dramco-iwast/sensors/README.md

# sensors
Design of the sensors that can be plugged onto the IWAST motherboard.
