dramco-iwast/sensors/casing/verticalspacing.PNG

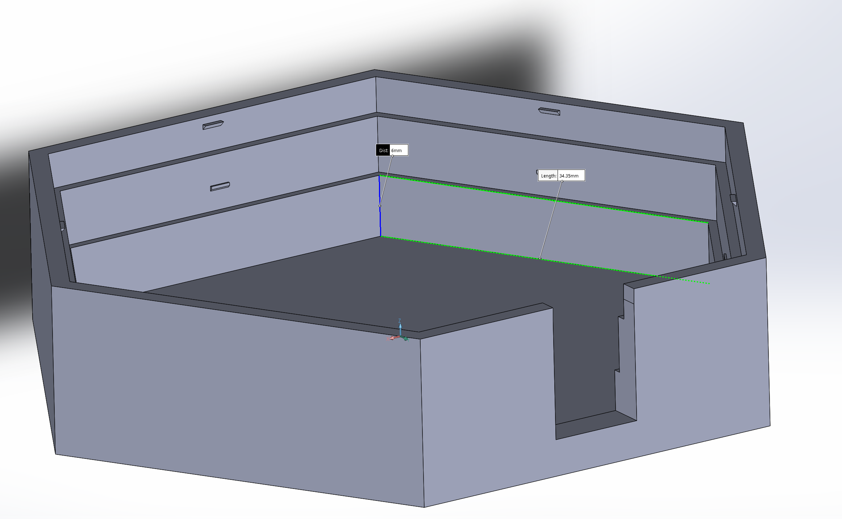
casing/verticalspacing.PNG
