dramco-iwast/sensors/hardware/Sound_Level/SoundModulev2.4/kicadproject/noun_Microphone_1957310.png

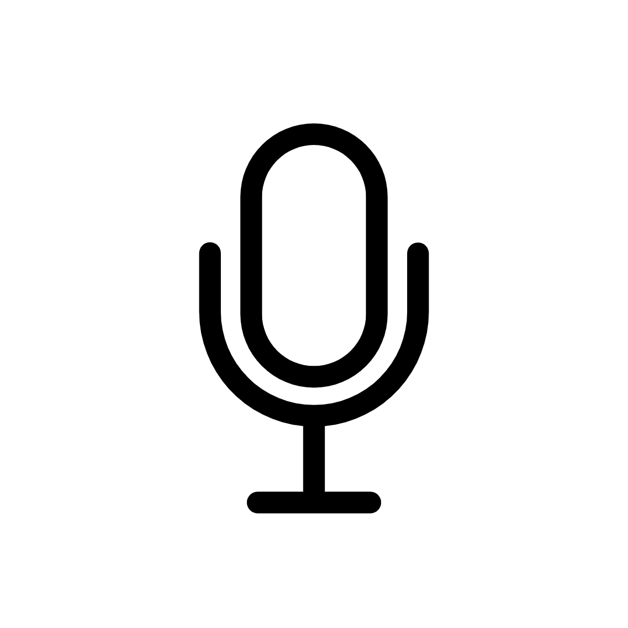
hardware/Sound_Level/SoundModulev2.4/kicadproject/noun_Microphone_1957310.png
