dramco-iwast/sensors/hardware/Buttons/Buttons_v2/bom/Buttons_v1.xlsx

Id | Designator | Behuizing | Hoeveelheid | Orientatie | Manufacturer Part Number (MPN) | Ordercode Farnell | Ordercode Mouser | Type
1 | REF** | PinHeader_1x06_P2.54mm_Vertical_SMD | 1 | PinHeader_1x06_P2.54mm_Vertical_SMD
2 | G*** | Dramco7500 | 1 | LOGO
3 | G*** | KULeuven4000 | 1 | LOGO
4 | S4,S3,S2,S1 | 30062114 | 4 | 30062114 | 30062114 |  | 979-3006.2114 | Not specified
5 | J2 | ConnectorHorizontalPcb | 1 | MASTER | M20-9980345 | 1022230 |  | Per stuk
6 | C5,C4,C3,C2,C1 | C_0805_2012Metric_Pad1.15x1.40mm_HandSolder | 5 | 100n | C0805C104M4RACAUTO | 3510057 |  | Reel
7 | R10,R9,R7,R5,R3 | R_0805_2012Metric_Pad1.15x1.40mm_HandSolder | 5 | 1k | MCWR08X1001FTL | 2446904 |  | Reel
8 | LED1 | LED_0805_2012Metric_Pad1.15x1.40mm_HandSolder | 1 | SML-D12Y1WT86 | KP-2012QBC-D | 2217974 |  | Tape en reel, afgesneden
9 | R8,R6,R4,R2 | R_0805_2012Metric_Pad1.15x1.40mm_HandSolder | 4 | 100k | MC01W08051100K | 2129276 |  | Reel
10 | J1 | PinHeader_1x06_P2.54mm_Vertical | 1 | PICKit3
11 | IC1 | SOP65P780X200-20N | 1 | PIC16F18446-I_SS | PIC16F18446-I/SS | 3631504 |  | Not specified
12 | R1 | R_0805_2012Metric_Pad1.15x1.40mm_HandSolder | 1 | 10k | MC01W0805110K | 2129195 |  | Reel
