dramco-iwast/sensors/hardware/Power/Power_v6/bom/Power_module_v4.xlsx

Id | Designator | Behuizing | Hoeveelheid | Orientatie | Manufacturer Part Number (MPN) | Ordercode Farnell | Ordercode Mouser | Type
1 | G*** | logoKuleuven2 | 1 | LOGO
2 | G*** | logoDramco2 | 1 | LOGO
3 | Z1 | D_SOD-523 | 1 | BZT52C4V7T-7
4 | R4,R5 | R_0805_2012Metric_Pad1.15x1.40mm_HandSolder | 2 | 1.5k | MCWR08X1501FTL | 2447592 |  | Tape en reel, afgesneden
5 | J1 | PinHeader_1x02_P2.54mm_Vertical | 1 | Conn_01x02
6 | CSTOR1,CIN1 | C_0805_2012Metric_Pad1.18x1.45mm_HandSolder | 2 | 4.7 uF | C0805C475K8PACTU | 2409055 |  | Tape en reel, afgesneden
7 | CREF1,CBYP1 | C_0805_2012Metric_Pad1.18x1.45mm_HandSolder | 2 | 10 nF | 885012207011 | 2534050 |  | Tape en reel, afgesneden
8 | COUT1,CIN2 | C_0805_2012Metric_Pad1.18x1.45mm_HandSolder | 2 | 100n | C0805C104M4RACAUTO | 3510057 |  | Reel
9 | C14 | C_0805_2012Metric_Pad1.18x1.45mm_HandSolder | 1 | 100 nF | C0805C104M4RACAUTO | 3510057 |  | Reel
10 | C13 | C_0805_2012Metric_Pad1.18x1.45mm_HandSolder | 1 | 10 uF | C0805C106Z8VACTU | 2725611 |  | Reel
11 | C12,C10,C9,C8,C7,C4,C1 | C_0805_2012Metric_Pad1.18x1.45mm_HandSolder | 9 | 1 uF | C0805C105K4RACTU | 2392346 |  | Reel
12 | COUT2, COUT3 | C_0805_2012Metric_Pad1.18x1.45mm_HandSolder | 2 | 22 uF | C0805C226M8PACTU | 2773239 |  | Tape en reel, afgesneden
13 | CSTOR2,CBATT1 | C_0805_2012Metric_Pad1.18x1.45mm_HandSolder | 2 | DNP
14 | U1 | BQ24040 | 1 | BQ24040 | BQ24040DSQR | 3008693RL |  | Tape en reel, afgesneden
15 | D3,D4 | LED_0805_2012Metric_Pad1.15x1.40mm_HandSolder | 2 | LED | KP-2012QBC-D | 2217974 |  | Tape en reel, afgesneden
15 | D1 | LED_0805_2012Metric_Pad1.15x1.40mm_HandSolder | 1 | LED | KP-2012CGCK | 2290331 |  | Tape en reel, afgesneden
15 | D2 | LED_0805_2012Metric_Pad1.15x1.40mm_HandSolder | 1 | LED | KP-2012SURC | 8529930 |  | Tape en reel, afgesneden
16 | J3 | USB_Micro | 1 | USB_B_Micro | 10118194-0001LF | 2668482 |  | Tape en reel, afgesneden
17 | J4 | PinHeader_1x02_P2.54mm_Vertical | 1 | Conn_01x02_battery
18 | J5,J6 | PinHeader_1x06_P2.54mm_Vertical | 2 | Conn_01x06_programmer
19 | JP1,JP2 | SolderJumper-2_P1.3mm_Open_RoundedPad1.0x1.5mm | 2 | SolderJumper_2_Open
20 | L1 | Inductor_744031220_22uH | 1 | 22 uH | 744031220 | 1890602 |  | Tape en reel, afgesneden
21 | L2 | Inductor_744029100_10uH | 1 | 10 uH | 744029100 | 1635828 |  | Tape en reel, afgesneden
22 | R1,R6,R9,R13,R12 | R_0805_2012Metric_Pad1.15x1.40mm_HandSolder | 5 | 10k | MC01W0805110K | 2129195 |  | Reel
23 | R2 | R_0805_2012Metric_Pad1.15x1.40mm_HandSolder | 1 | 1k | MCWR08X1001FTL | 2446904 |  | Reel
24 | R3 | R_0805_2012Metric_Pad1.15x1.40mm_HandSolder | 1 | 2k | MCWR08X2001FTL | 2447622 |  | Tape en reel, afgesneden
25 | R7 | R_0805_2012Metric_Pad1.15x1.40mm_HandSolder | 1 | 27k | MCWR08X2702FTL | 2447620 |  | Tape en reel, afgesneden
26 | R10 | R_0805_2012Metric_Pad1.15x1.40mm_HandSolder | 1 | 8.2k | MCWR08X8201FTL | 2447732 |  | Tape en reel, afgesneden
27 | R14,R15 | R_0805_2012Metric_Pad1.15x1.40mm_HandSolder | 2 | 470 | MCWR08X4700FTL | 2447662 |  | Tape en reel, afgesneden
28 | ROK3 | R_0805_2012Metric_Pad1.15x1.40mm_HandSolder | 1 | 1,27M | CRCW08051M27FKEA. | 2139131 |  | Tape en reel, afgesneden
29 | ROK2 | R_0805_2012Metric_Pad1.15x1.40mm_HandSolder | 1 | 6,81M | CRCW08056M81FKEA. | 2139222 |  | Tape en reel, afgesneden
30 | ROK1 | R_0805_2012Metric_Pad1.15x1.40mm_HandSolder | 1 | 5,1M | CRCW08055M10FKEA. | 2139205 |  | Tape en reel, afgesneden
31 | ROUT2 | R_0805_2012Metric_Pad1.15x1.40mm_HandSolder | 1 | 8.25 M | CRCW08058M25FKEA. | 2139232 |  | Tape en reel, afgesneden
32 | ROUT1 | R_0805_2012Metric_Pad1.15x1.40mm_HandSolder | 1 | 4.75 M | CRCW08054M75FKEA. | 2139202 |  | Tape en reel, afgesneden
33 | ROV2 | R_0805_2012Metric_Pad1.15x1.40mm_HandSolder | 1 | 7,15 M | CRCW08057M15FKEA. | 2139225 |  | Tape en reel, afgesneden
34 | ROV1 | R_0805_2012Metric_Pad1.15x1.40mm_HandSolder | 1 | 5.49M | CRCW08055M49FKEA. | 2139209 |  | Tape en reel, afgesneden
35 | S3,S1 | SOT-23-6_Handsoldering | 2 | TPS22860 | TPS22860DBVR | 3008896RL |  | Tape en reel, afgesneden
36 | U2 | QFN-20-1EP_3.5x3.5mm_P0.5mm_EP2x2mm | 1 | BQ25570 | BQ25570RGRR | 3123350RL |  | Tape en reel, afgesneden
37 | U3 | SOT-23-5_HandSoldering | 1 | TPS705
38 | U4 | PIC16F18446SSOP20PIN | 1 | PIC16F18446 | PIC16F18446-I/SS | 3631504 |  | Not specified
39 | J2 | ConnectorHorizontalPcb | 1 | Conn_02x03_motherboardconn | M20-9980345 | 1022230 |  | Per stuk
40 | COUT4 | CP_Radial_D6.3mm_P2.50mm | 1 | 470 uF
41 | R8 | R_LDR_5.1x4.3mm_P3.4mm_Vertical | 1 | LDR03 | NSL 19M51 | 3168335 |  | Per stuk
 | C2, C3 | R_0805_2012Metric_Pad1.15x1.40mm_HandSolder |  | DNP
