dramco-iwast/sensors/hardware/Sound_Level/SoundModulev2.4/bom/SoundModulev2_2.xlsx

Id | Designator | Behuizing | Hoeveelheid | Orientatie | Manufacturer Part Number (MPN) | Ordercode Farnell | Ordercode Mouser | Type
1 | G*** | logoDramco2 | 1 | LOGO
2 | G*** | logoKuleuven2 | 1 | LOGO
3 | J6,J4 | PinHeader_1x01_P2.54mm_Vertical | 2 | Conn_01x01
4 | R18 | R_0805_2012Metric_Pad1.15x1.40mm_HandSolder | 1 | 500k | MCWR08X4993FTL | 2447667 |  | Tape en reel, afgesneden
5 | IC1 | SOP50P310X90-8N | 1 | TS5A2066DCUR | TS5A2066DCUR | 3118281RL |  | Tape en reel, afgesneden
6 | R17,R3 | R_0805_2012Metric_Pad1.15x1.40mm_HandSolder | 2 | 9k | CRCW08059K09FKEA. | 2138974 |  | Tape en reel, afgesneden
7 | R2,R1 | R_0805_2012Metric_Pad1.15x1.40mm_HandSolder | 2 | 36k | CRCW080536K0FKEA. | 2138997 |  | Tape en reel, afgesneden
8 | C13,C1,C2,C5,C6,C11 | C_0805_2012Metric_Pad1.15x1.40mm_HandSolder | 6 | 100 nF | C0805C104M4RACAUTO | 3510057 |  | Reel
9 | J5 | ConnectorHorizontalPcb | 1 | Conn_02x03_Top_Bottom | M20-9980345 | 1022230 |  | Per stuk
10 | C3,C7,C12 | C_0805_2012Metric_Pad1.15x1.40mm_HandSolder | 3 | 47n | 885012207015 | 2812382RL |  | Tape en reel, afgesneden
11 | C9,C10 | C_0805_2012Metric_Pad1.15x1.40mm_HandSolder | 2 | 2.2 nF | 885012207009 | 2812377RL |  | Tape en reel, afgesneden
12 | D1 | LED_0805_2012Metric_Pad1.15x1.40mm_HandSolder | 1 | LED | KP-2012QBC-D | 2217974 |  | Tape en reel, afgesneden
13 | J1,J3 | PinHeader_1x06_P2.54mm_Vertical | 2 | ProgramPic
14 | J7 | PinHeader_1x01_P2.54mm_Vertical | 1 | VanalogTestPin
15 | MIC | VESPER_VM1010 | 1 | VesperVM1010 | VM1010 |  | 208-VM1010 | Reel / afgesneden
16 | R4,R12,R13 | R_0805_2012Metric_Pad1.15x1.40mm_HandSolder | 3 | 10k | MC01W0805110K | 2129195 |  | Reel
17 | R6 | R_0805_2012Metric_Pad1.15x1.40mm_HandSolder | 1 | 470 | MCWR08X4700FTL | 2447662 |  | Tape en reel, afgesneden
18 | R5,R11,R16 | R_0805_2012Metric_Pad1.15x1.40mm_HandSolder | 3 | 120k | MCWR08X1203FTL | 2447560 |  | Tape en reel, afgesneden
19 | R7 | R_0805_2012Metric_Pad1.15x1.40mm_HandSolder | 1 | 18k | MCWR08X1802FTL | 2447584 |  | Tape en reel, afgesneden
20 | R8,R9 | R_0805_2012Metric_Pad1.15x1.40mm_HandSolder | 2 | 100k | MC01W08051100K | 2129276 |  | Reel
21 | R10 | R_0805_2012Metric_Pad1.15x1.40mm_HandSolder | 1 | 560k | MCWR08X5603FTL | 2447685 |  | Tape en reel, afgesneden
22 | R14 | R_0805_2012Metric_Pad1.15x1.40mm_HandSolder | 1 | 2.7k | MCWR08X2701FTL | 2447627 |  | Tape en reel, afgesneden
23 | R15 | R_0805_2012Metric_Pad1.15x1.40mm_HandSolder | 1 | 1k | MCWR08X1001FTL | 2446904 |  | Reel
24 | U1 | PIC16F18446SSOP20PIN | 1 | PIC16F18446 | PIC16F18446-I/SS | 3631504 |  | Not specified
25 | U2,U3,U4 | TLV341 SOT-23-6 | 3 | TLV341A | TLV341AIDBVR |  | 595-TLV341AIDBVR | Reel / afgesneden
26 | C4,C8 | C_0805_2012Metric_Pad1.15x1.40mm_HandSolder | 2 | 10 uF | C0805C106Z8VACTU | 2725611 |  | Reel
