dramco-iwast/sensors/casing/CaseModule8.SLDPRT

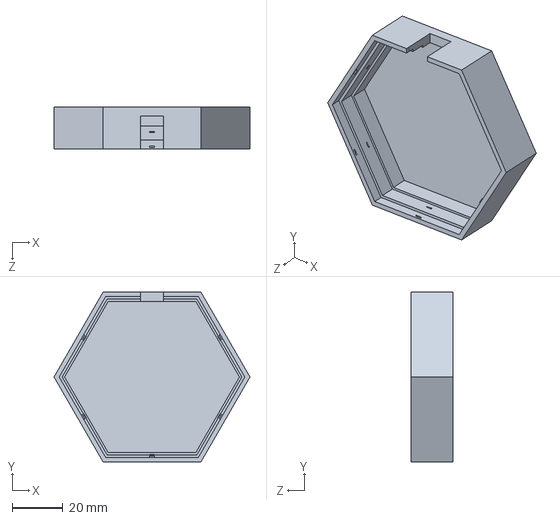
[picture p4: CAD file, 2020-03-09]
casing/CaseModule8.SLDPRT
77.0 x 66.7 x 16.6 mm
