dramco-iwast/sensors/hardware/Power/Power_v6/kicadproject/reverse_mounted_led.STEP

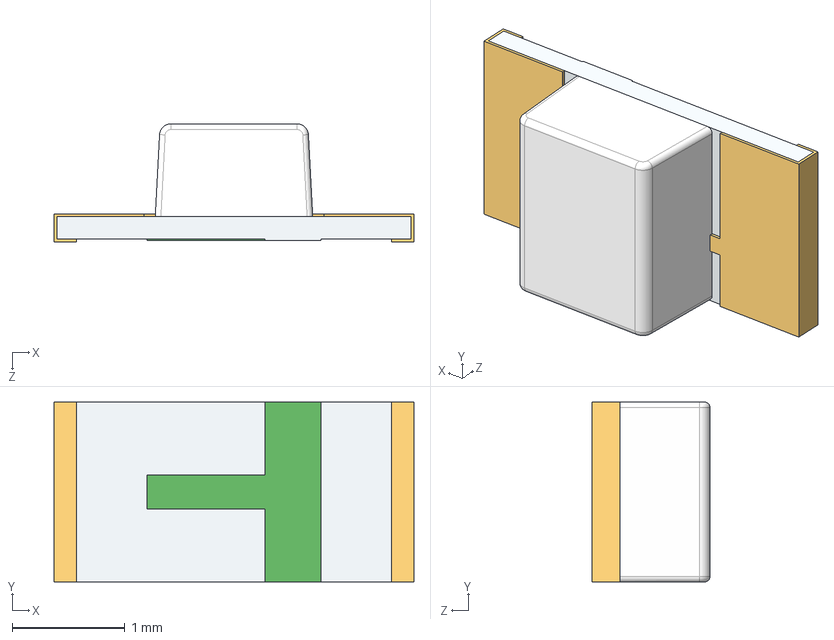
[picture p5: CAD file, 2021-10-26]
hardware/Power/Power_v6/kicadproject/reverse_mounted_led.STEP
3.20 x 1.60 x 1.05 mm
KPTR-3216CGCK
KPTR-3216CGCK-e2
KPTR-3216CGCK-g
KPTR-3216CGCK-e
