dramco-iwast/sensors/hardware/Power/Power_v6/kicadproject/VEML7700-TT/VEML7700-TT.step

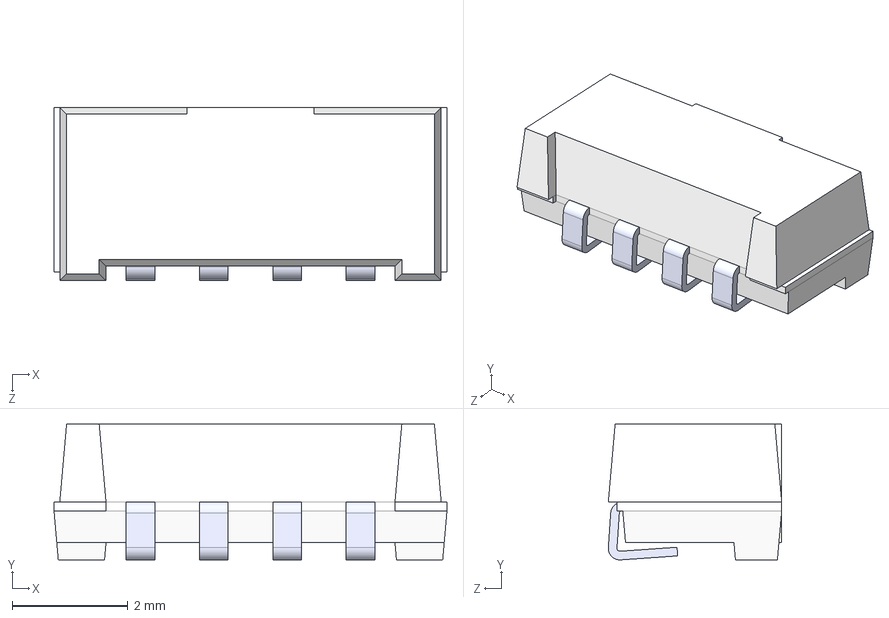
[picture p6: CAD file, 2021-05-31]
hardware/Power/Power_v6/kicadproject/VEML7700-TT/VEML7700-TT.step
6.80 x 2.35 x 3.00 mm
