dramco-iwast/sensors/hardware/Sound_Level/SoundModulev2.4/kicadproject/SoundModulev2.step

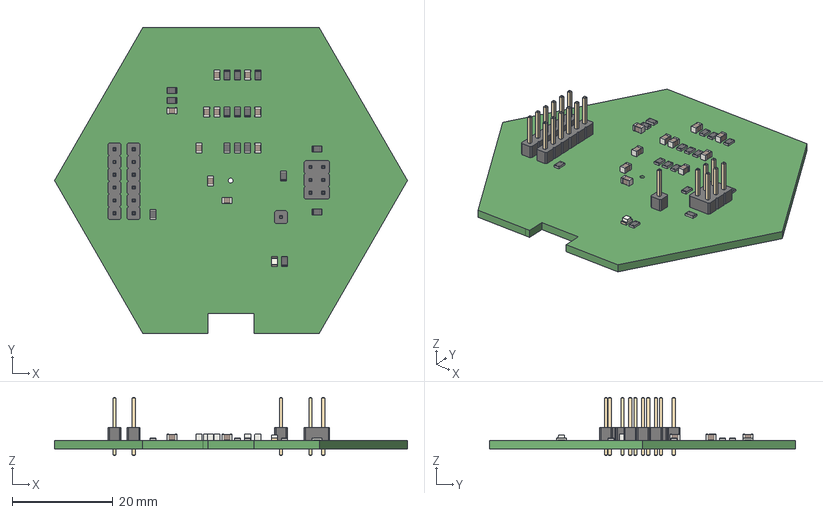
[picture p7: CAD file, 2020-10-28]
hardware/Sound_Level/SoundModulev2.4/kicadproject/SoundModulev2.step
70.0 x 60.6 x 11.5 mm
