dramco-iwast/sensors/hardware/Power/Power_v6/kicadproject/USB3090-30-A--3DModel-STEP-56544.STEP

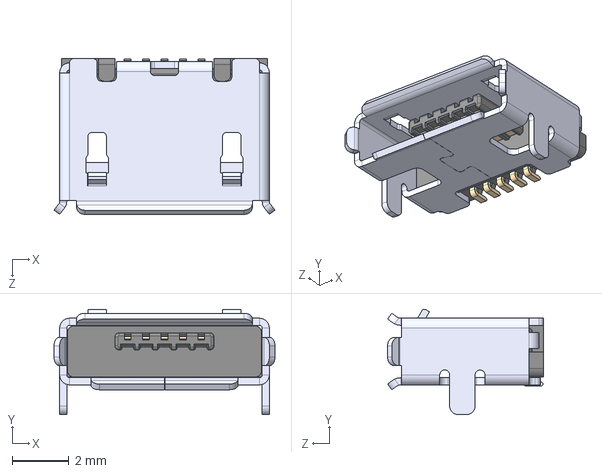
[picture p8: CAD file, 2021-10-26]
hardware/Power/Power_v6/kicadproject/USB3090-30-A--3DModel-STEP-56544.STEP
7.80 x 3.71 x 5.50 mm
