dramco-iwast/sensors/hardware/Power/Power_v6/kicadproject/PIC_3d.STEP

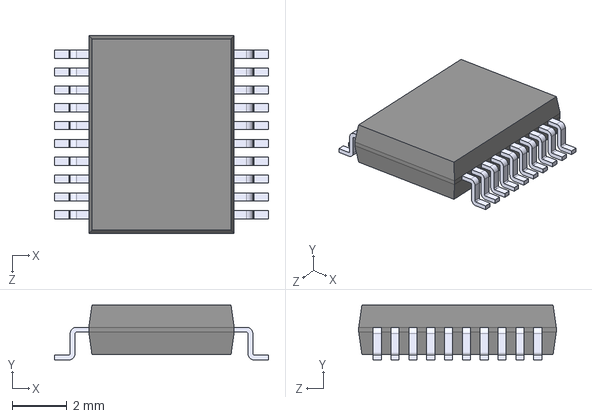
[picture p9: CAD file, 2021-10-26]
hardware/Power/Power_v6/kicadproject/PIC_3d.STEP
7.80 x 2.00 x 7.20 mm
