dramco-iwast/sensors/hardware/Buttons/Buttons_v2/kicadproject/610106249121/610106249121.step

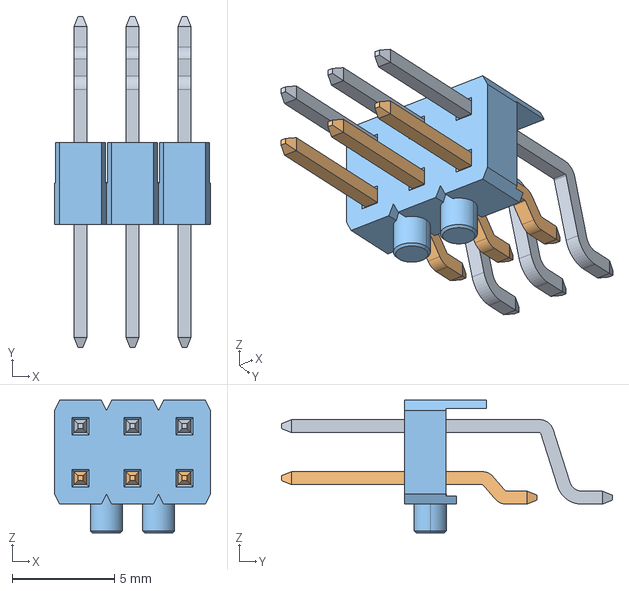
[picture p10: CAD file, 2021-10-26]
hardware/Buttons/Buttons_v2/kicadproject/610106249121/610106249121.step
7.62 x 16.2 x 6.48 mm
