dramco-iwast/sensors/(list of files, cad)

Other CAD files:
casing/CaseModule8.STL
hardware/Sound_Level/SoundModulev2.4/kicadproject/SoundModulev2.SLDASM
