dramco-iwast/sensors/hardware/Air_Quality/air_quality_v3/schematics/back.pdf

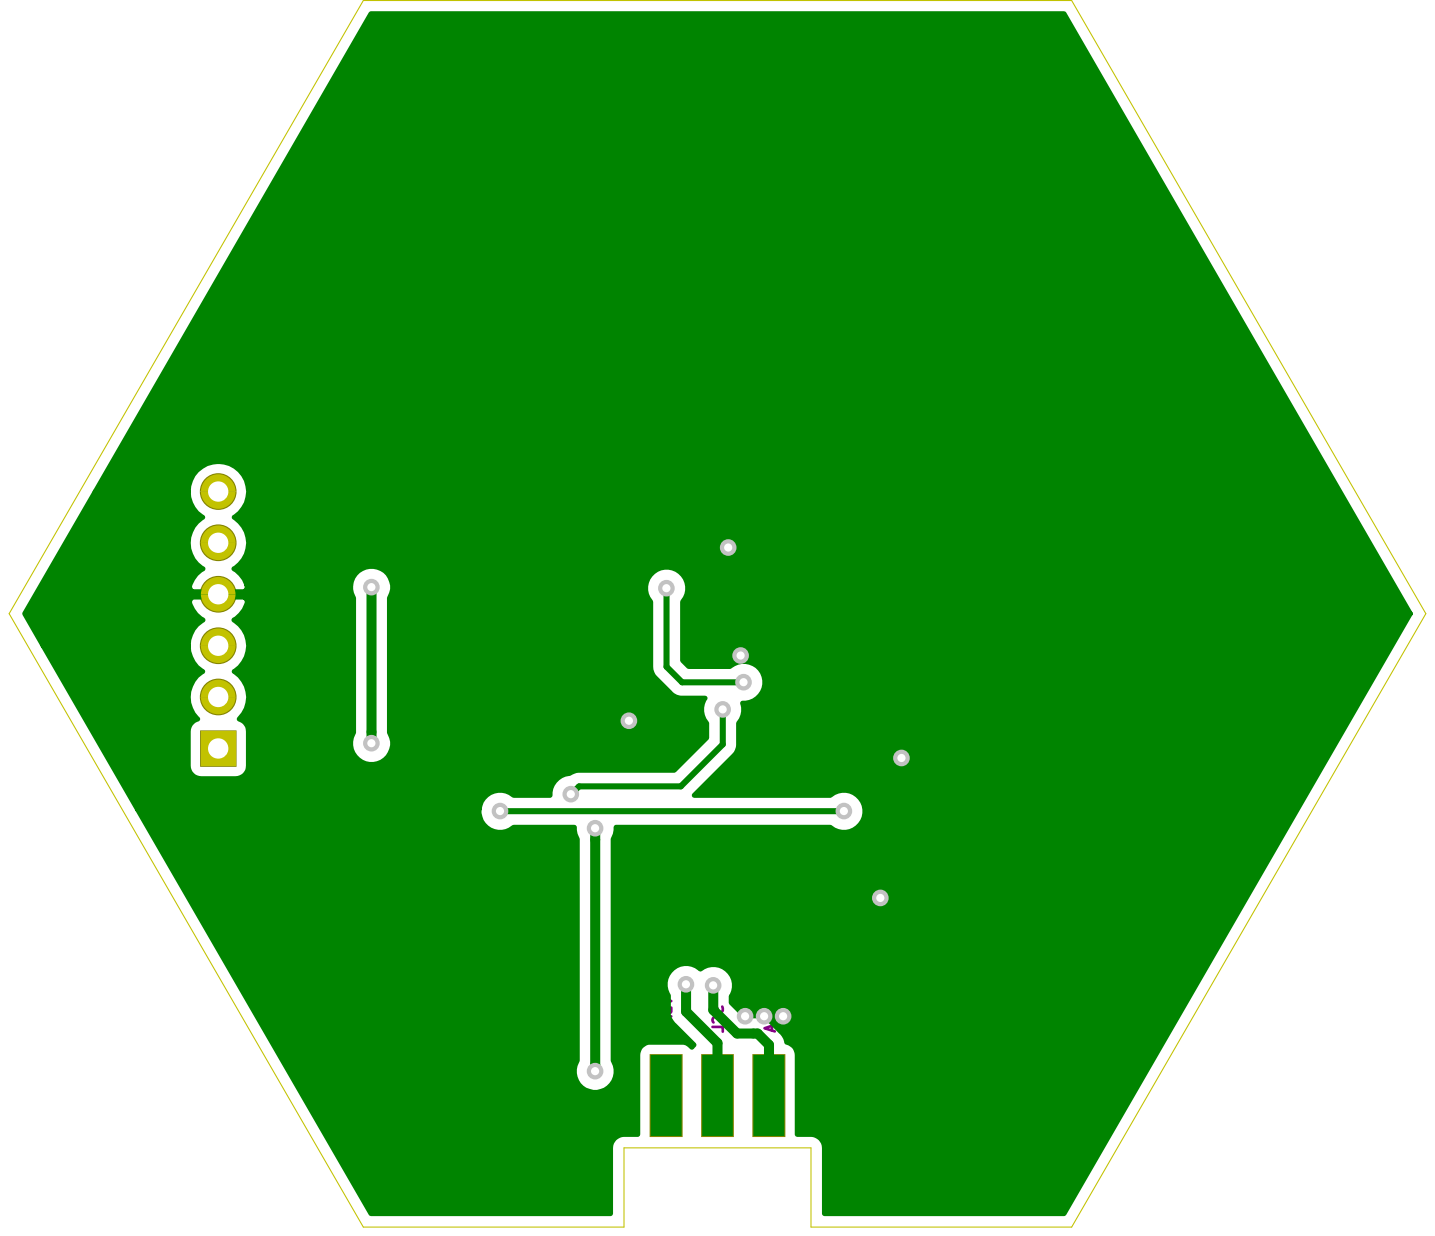
[picture p11: page 1]
