dramco-iwast/sensors/hardware/Air_Quality/air_quality_v3/schematics/front.pdf

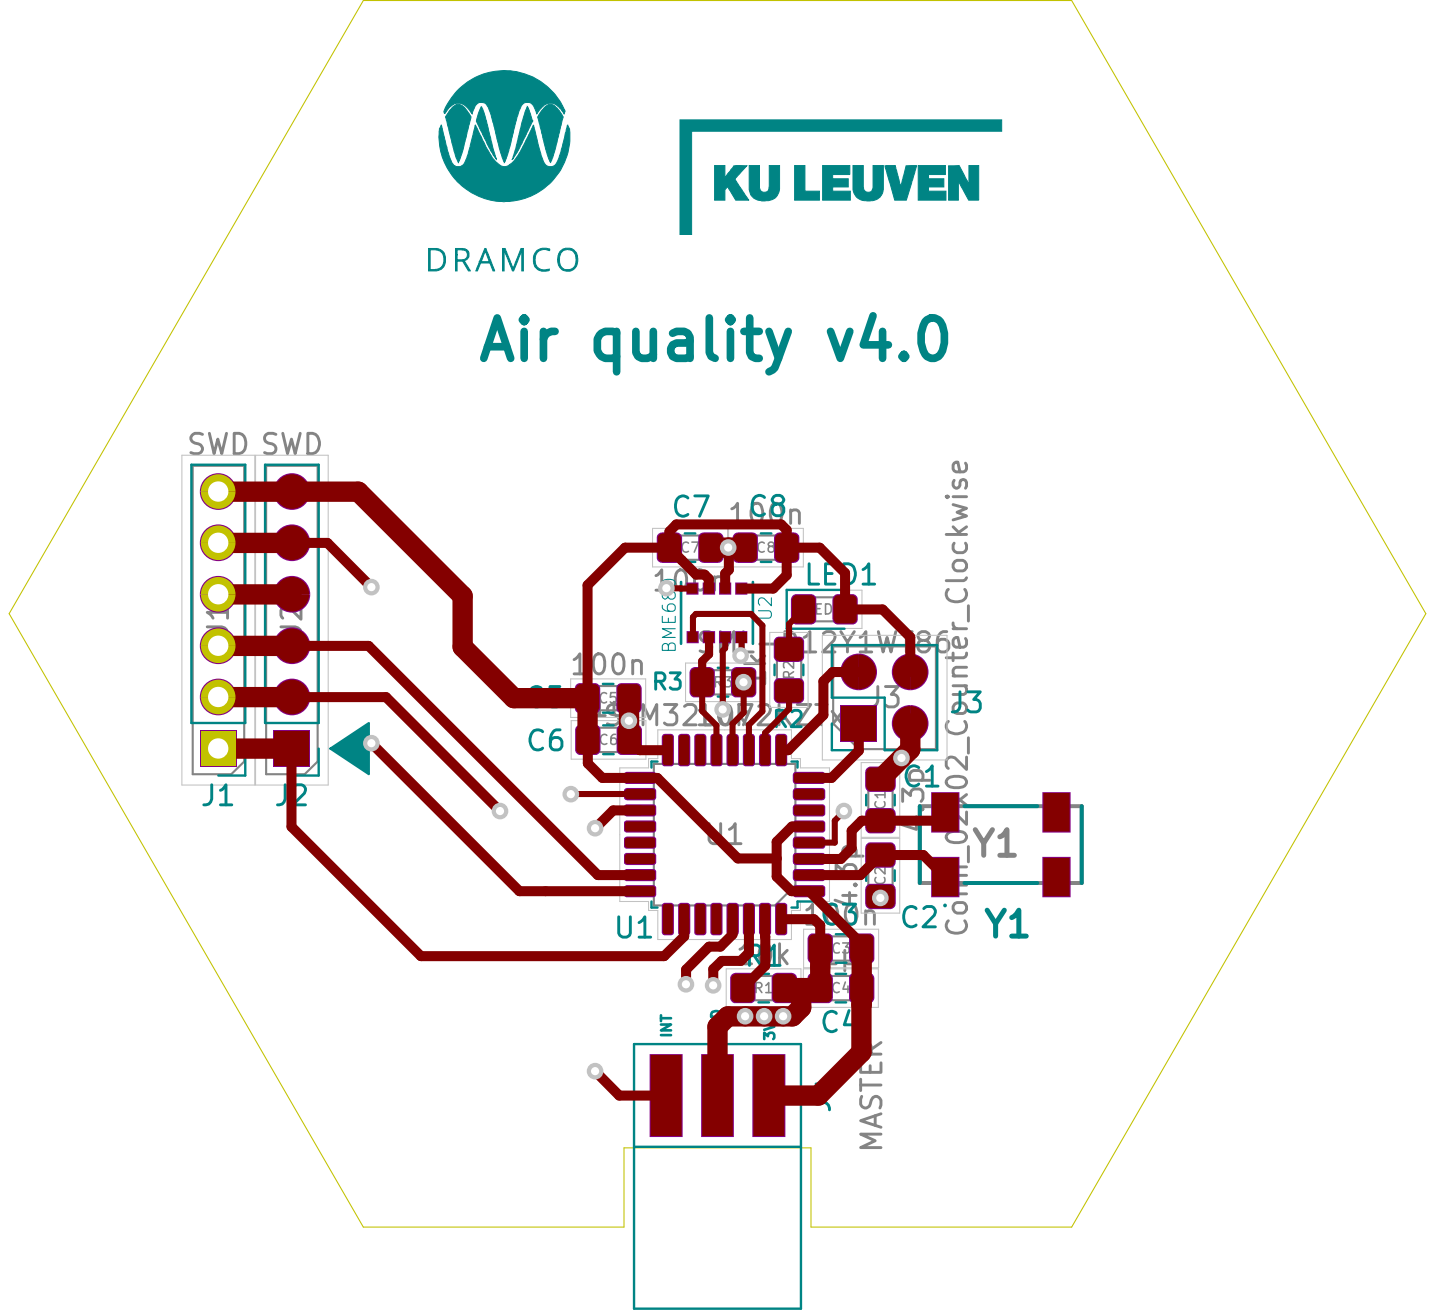
[picture p12: page 1]
