dramco-iwast/sensors/hardware/Air_Quality/air_quality_v3/schematics/schematics.pdf

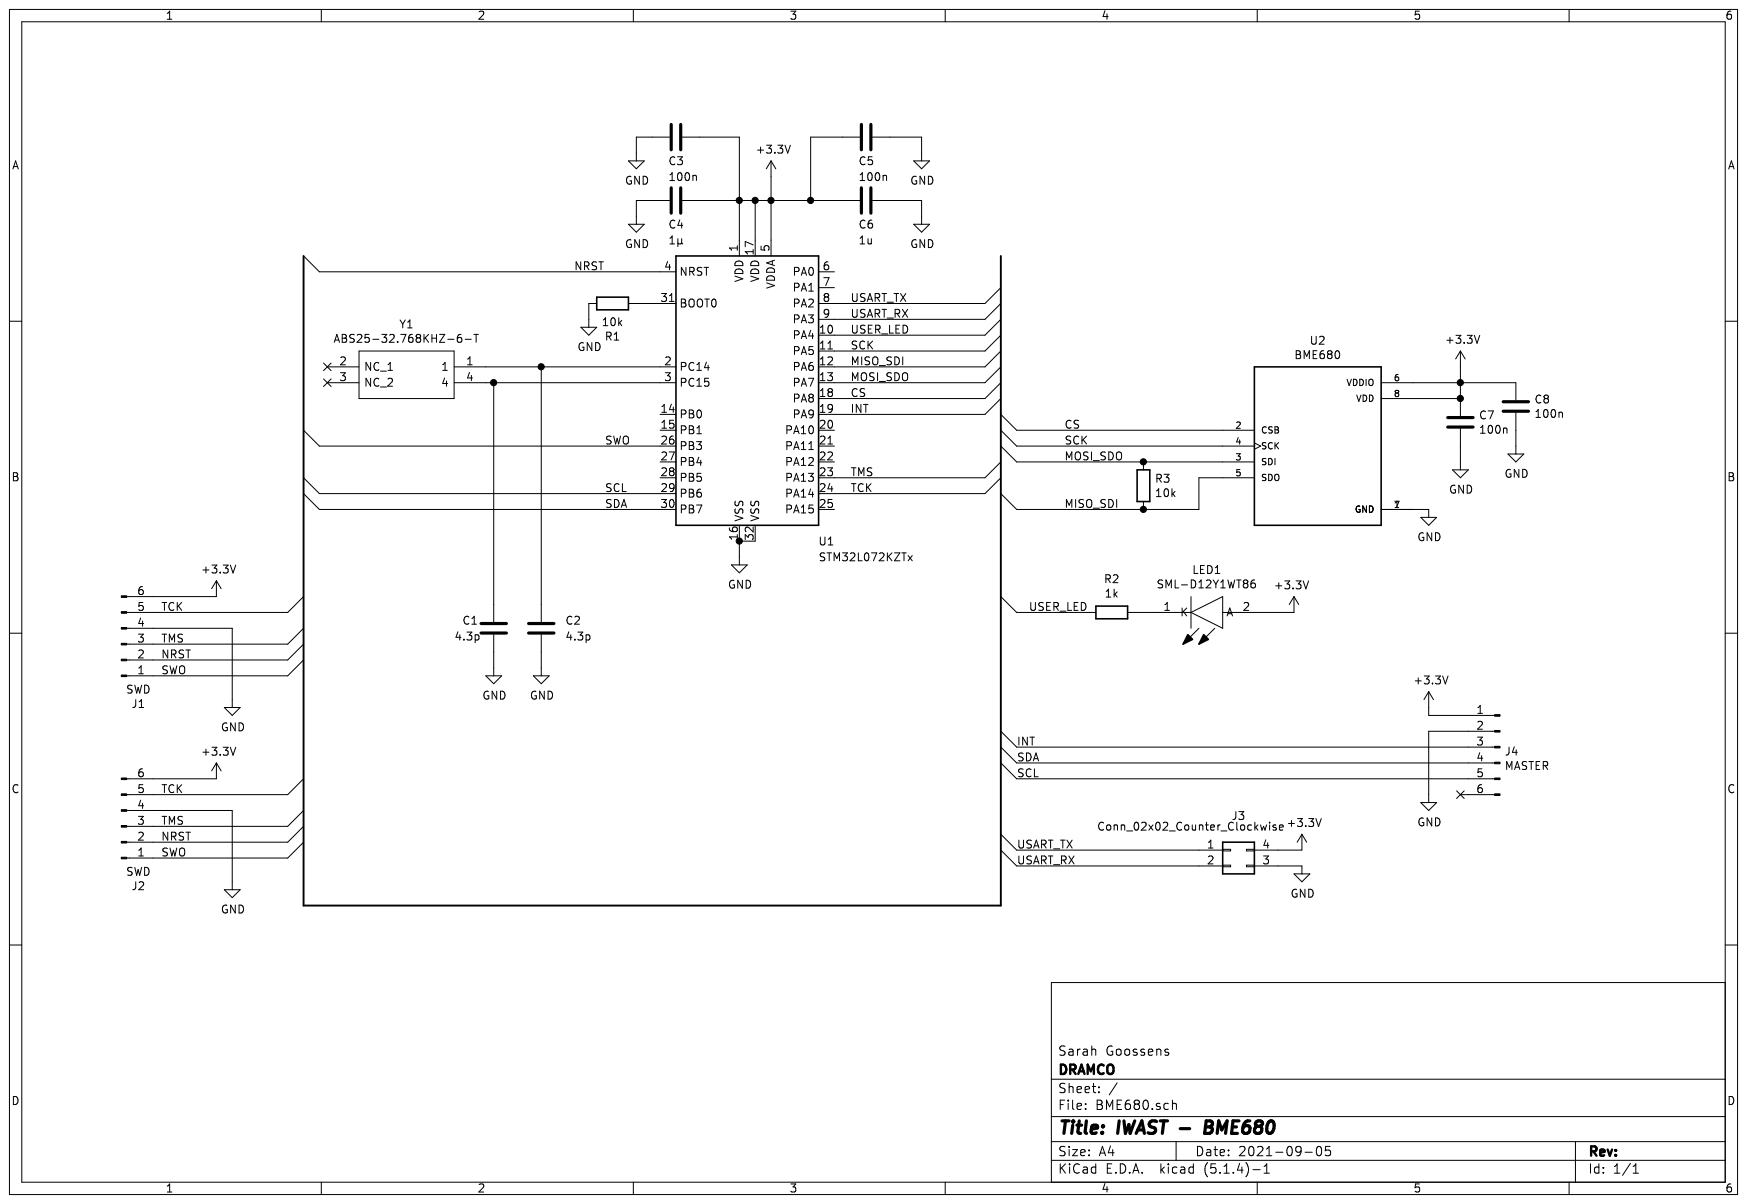
[picture p13: page 1]
