dramco-iwast/sensors/hardware/Power/Power_v6/schematic/power_module_v4_back.pdf

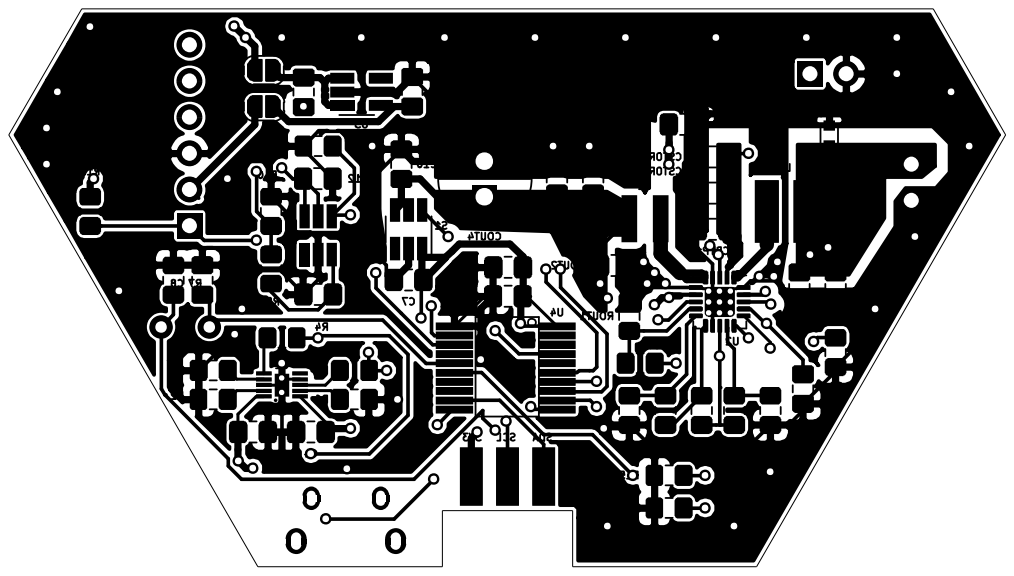
[picture p14: page 1]
