dramco-iwast/sensors/hardware/Power/Power_v6/schematic/power_module_v4_front.pdf

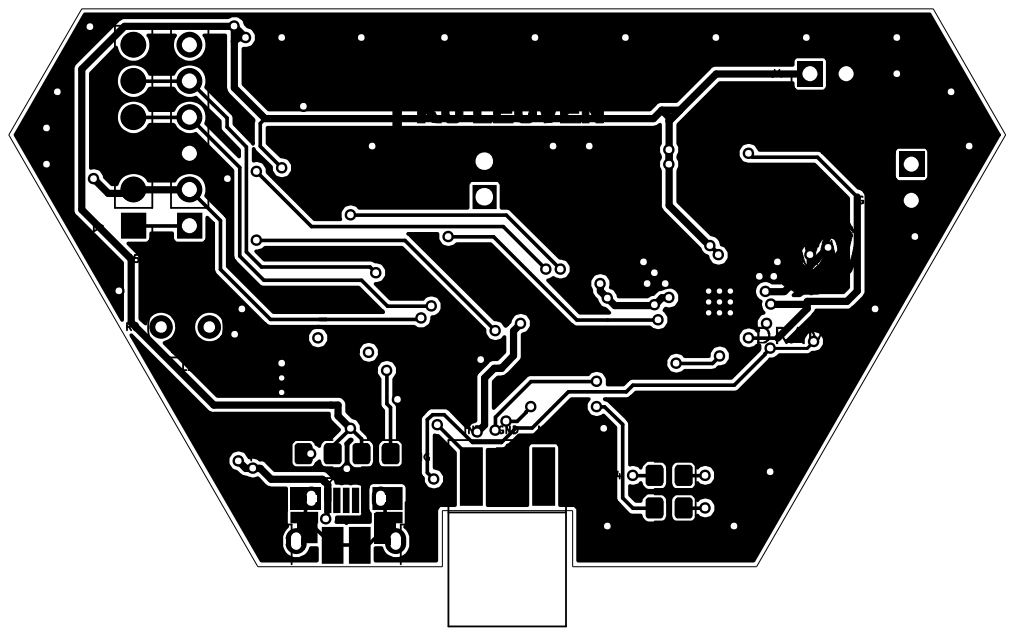
[picture p15: page 1]
