dramco-iwast/sensors/hardware/Power/Power_v6/schematic/power_module_v4_schematic.pdf

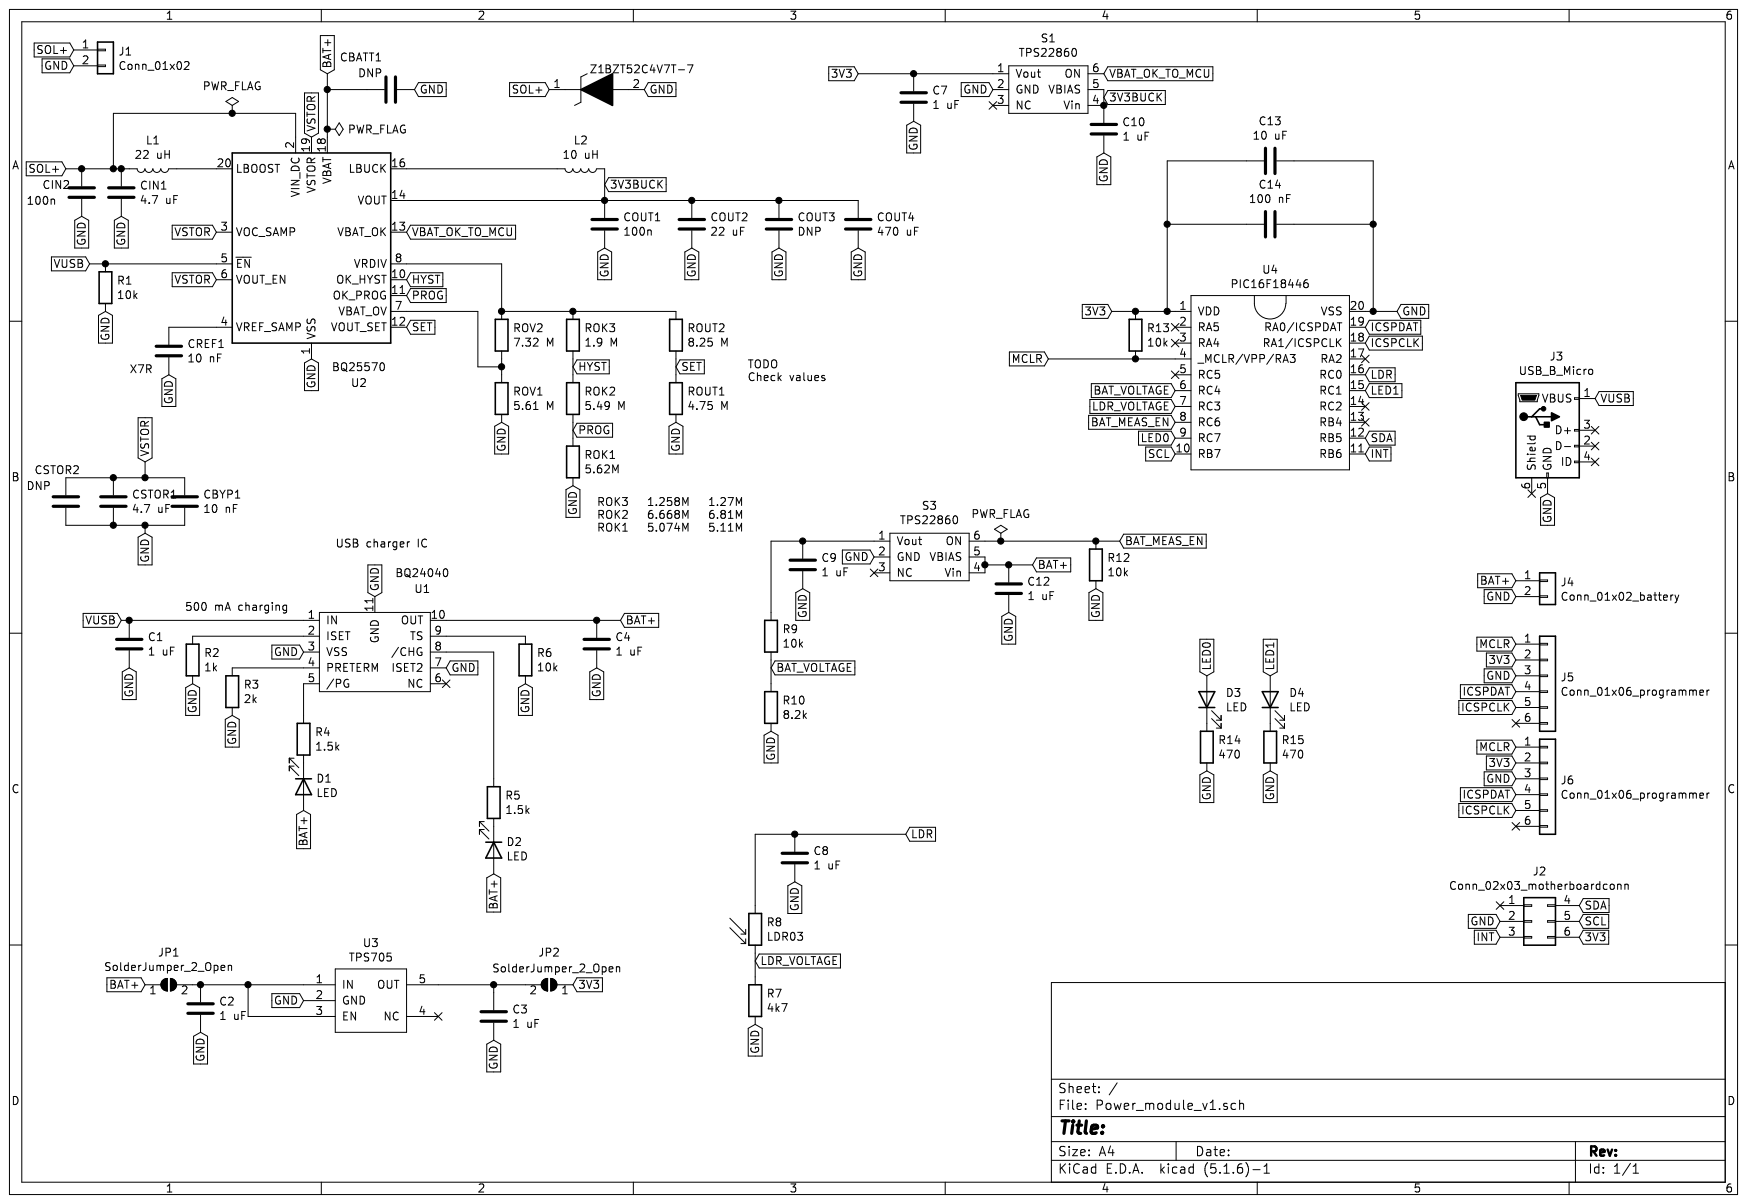
[picture p16: page 1]
