dramco-iwast/sensors/hardware/Sound_Level/SoundModulev2.4/schematics/sound_module_v2.1_back.pdf

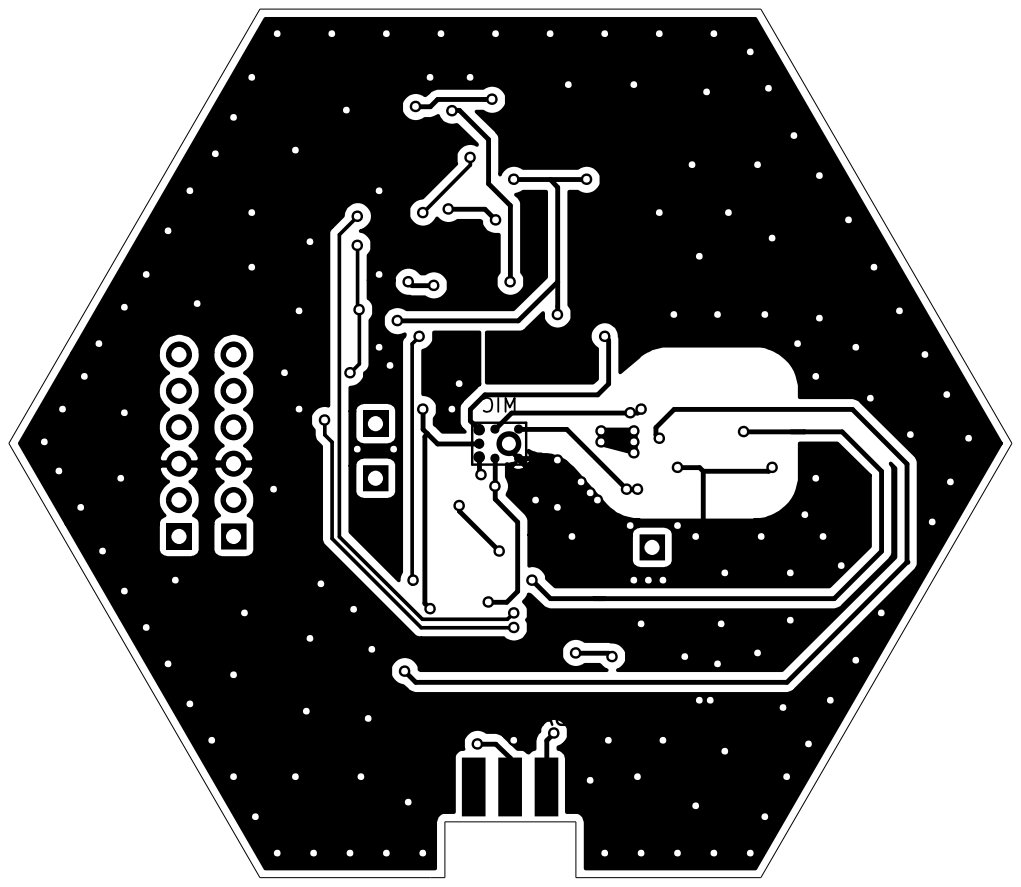
[picture p17: page 1]
