dramco-iwast/sensors/hardware/Sound_Level/SoundModulev2.4/schematics/sound_module_v2.1_front.pdf

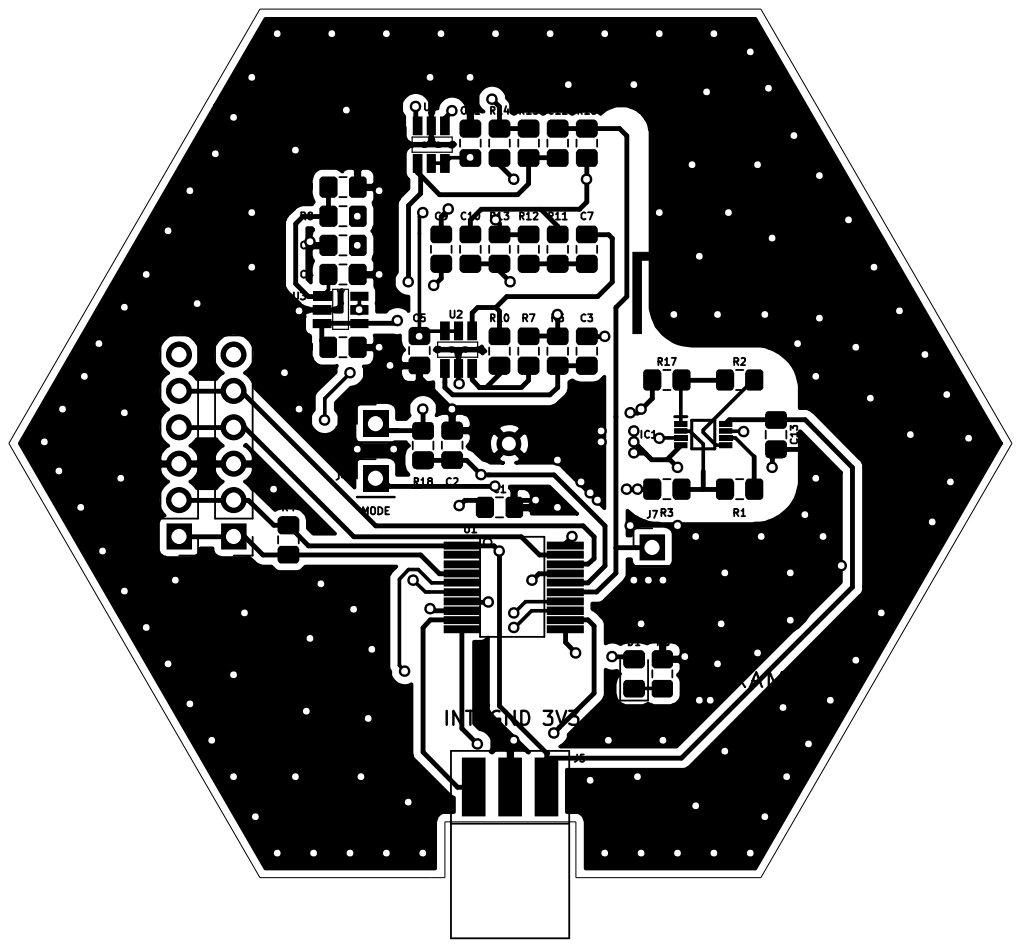
[picture p18: page 1]
