dramco-iwast/sensors/hardware/Sound_Level/SoundModulev2.4/schematics/sound_module_v2.1_schematic.pdf

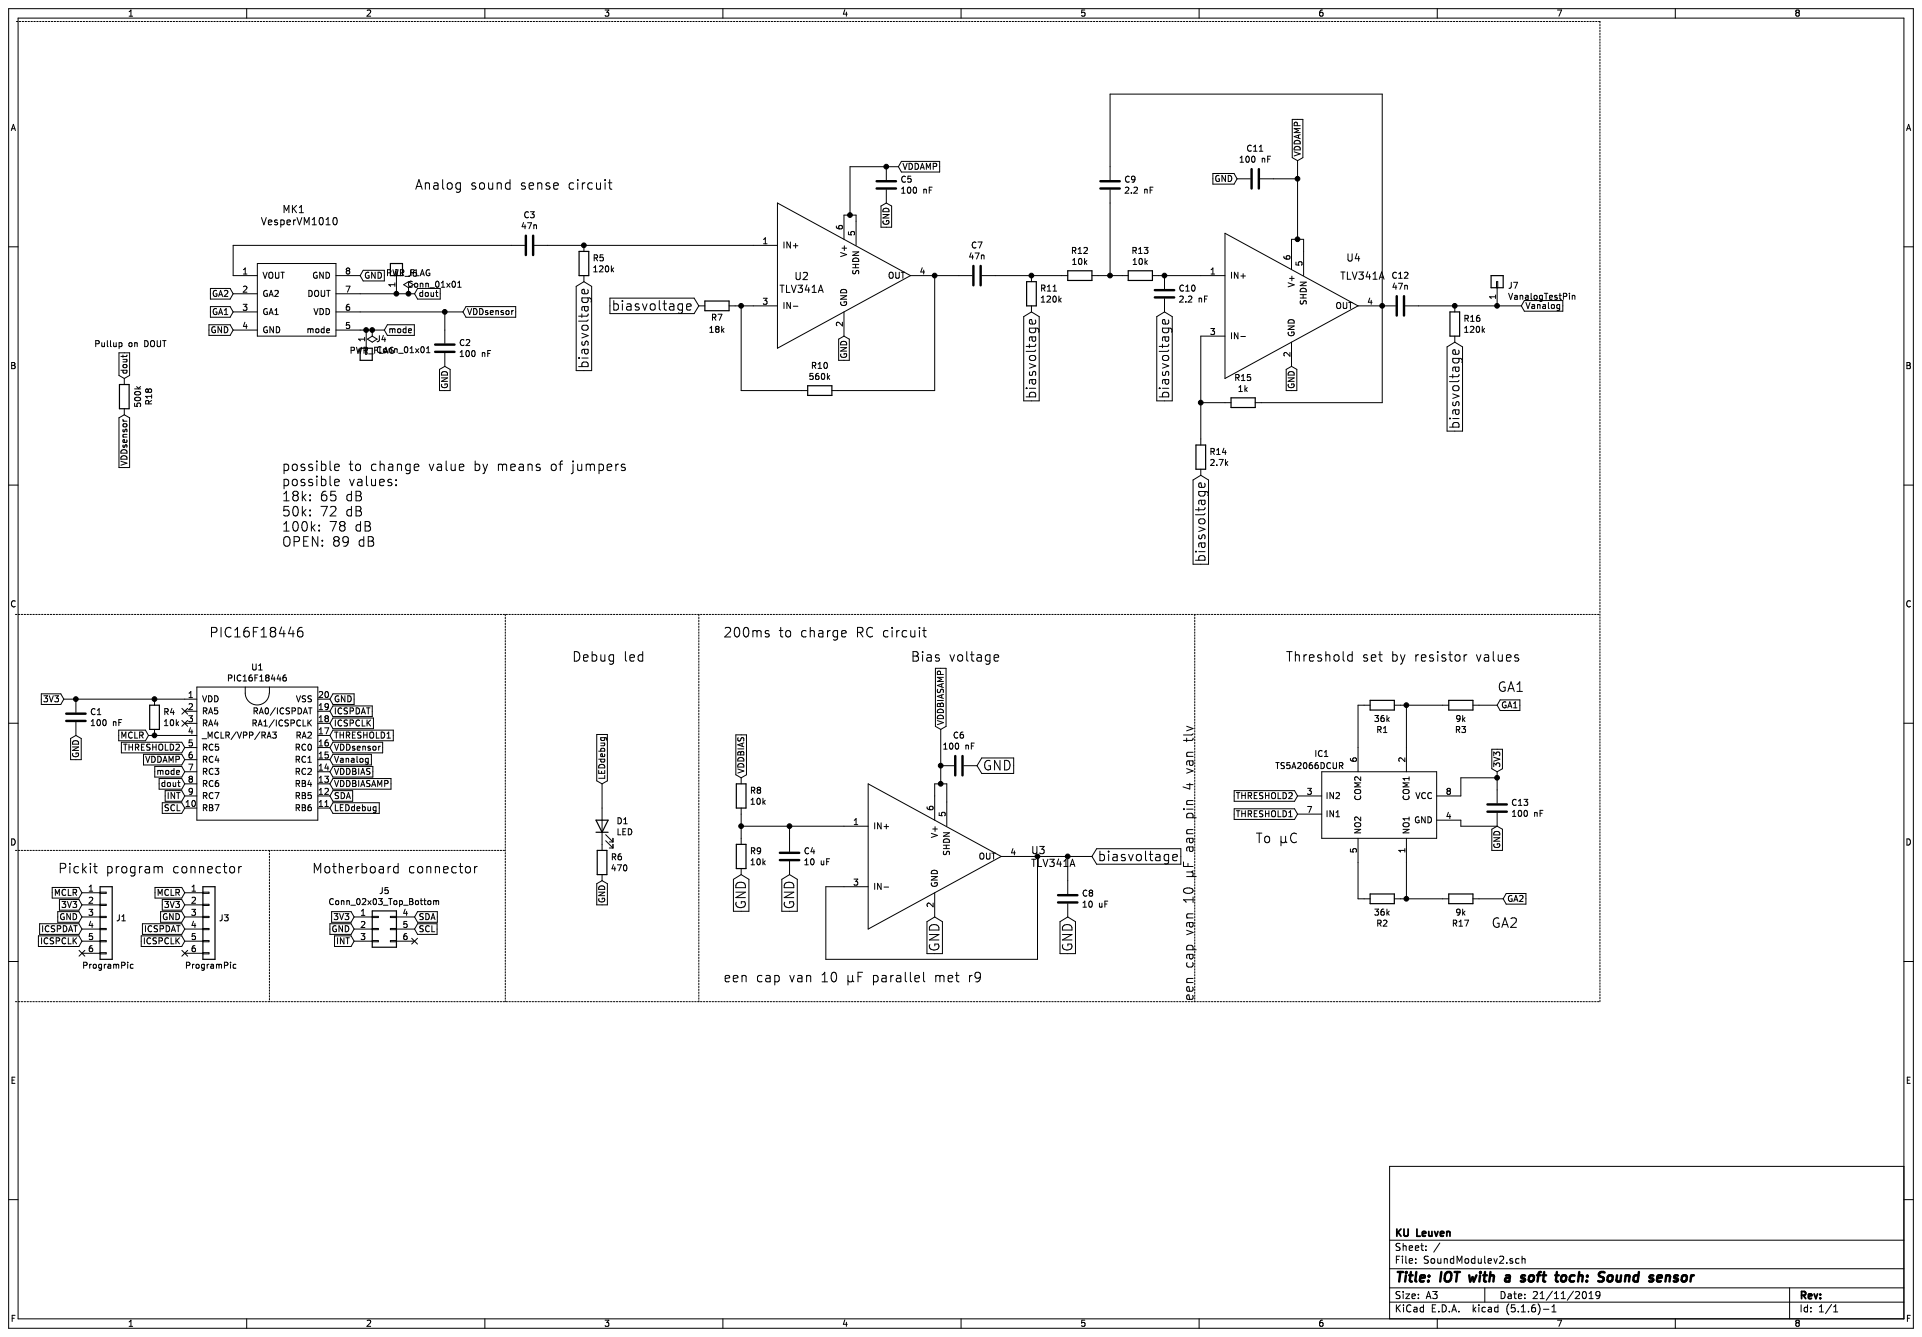
[picture p19: page 1]
