dramco-iwast/sensors/hardware/Sound_Level/SoundModulev1/schematics/sound_module_v1_back.pdf

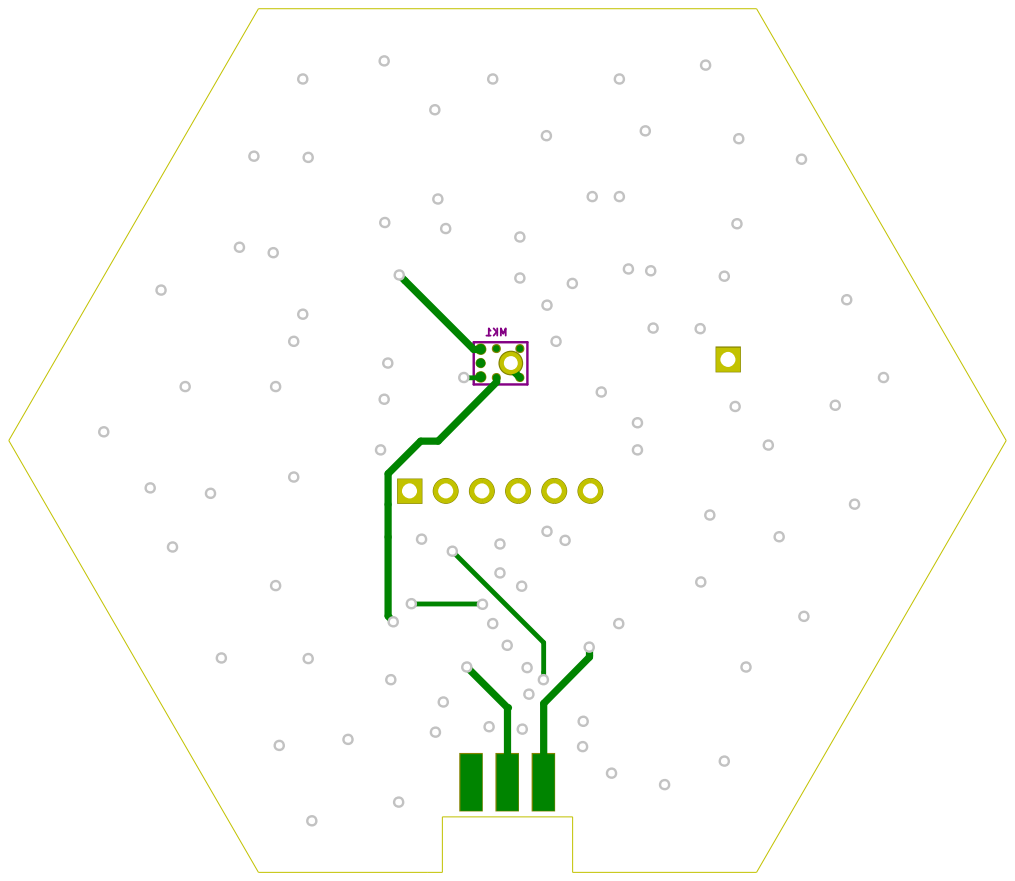
[picture p20: page 1]
