dramco-iwast/sensors/hardware/Sound_Level/SoundModulev1/schematics/sound_module_v1_front.pdf

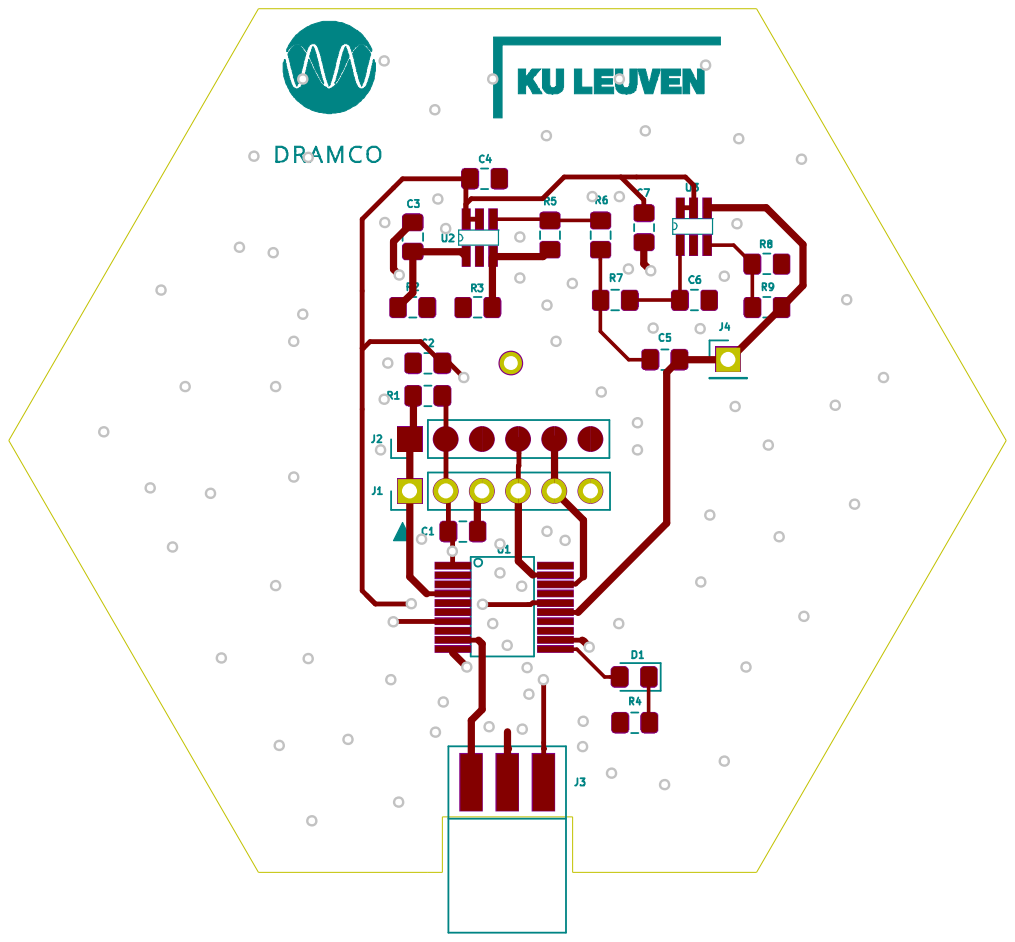
[picture p21: page 1]
