dramco-iwast/sensors/hardware/Sound_Level/SoundModulev1/schematics/sound_module_v1_schematic.pdf

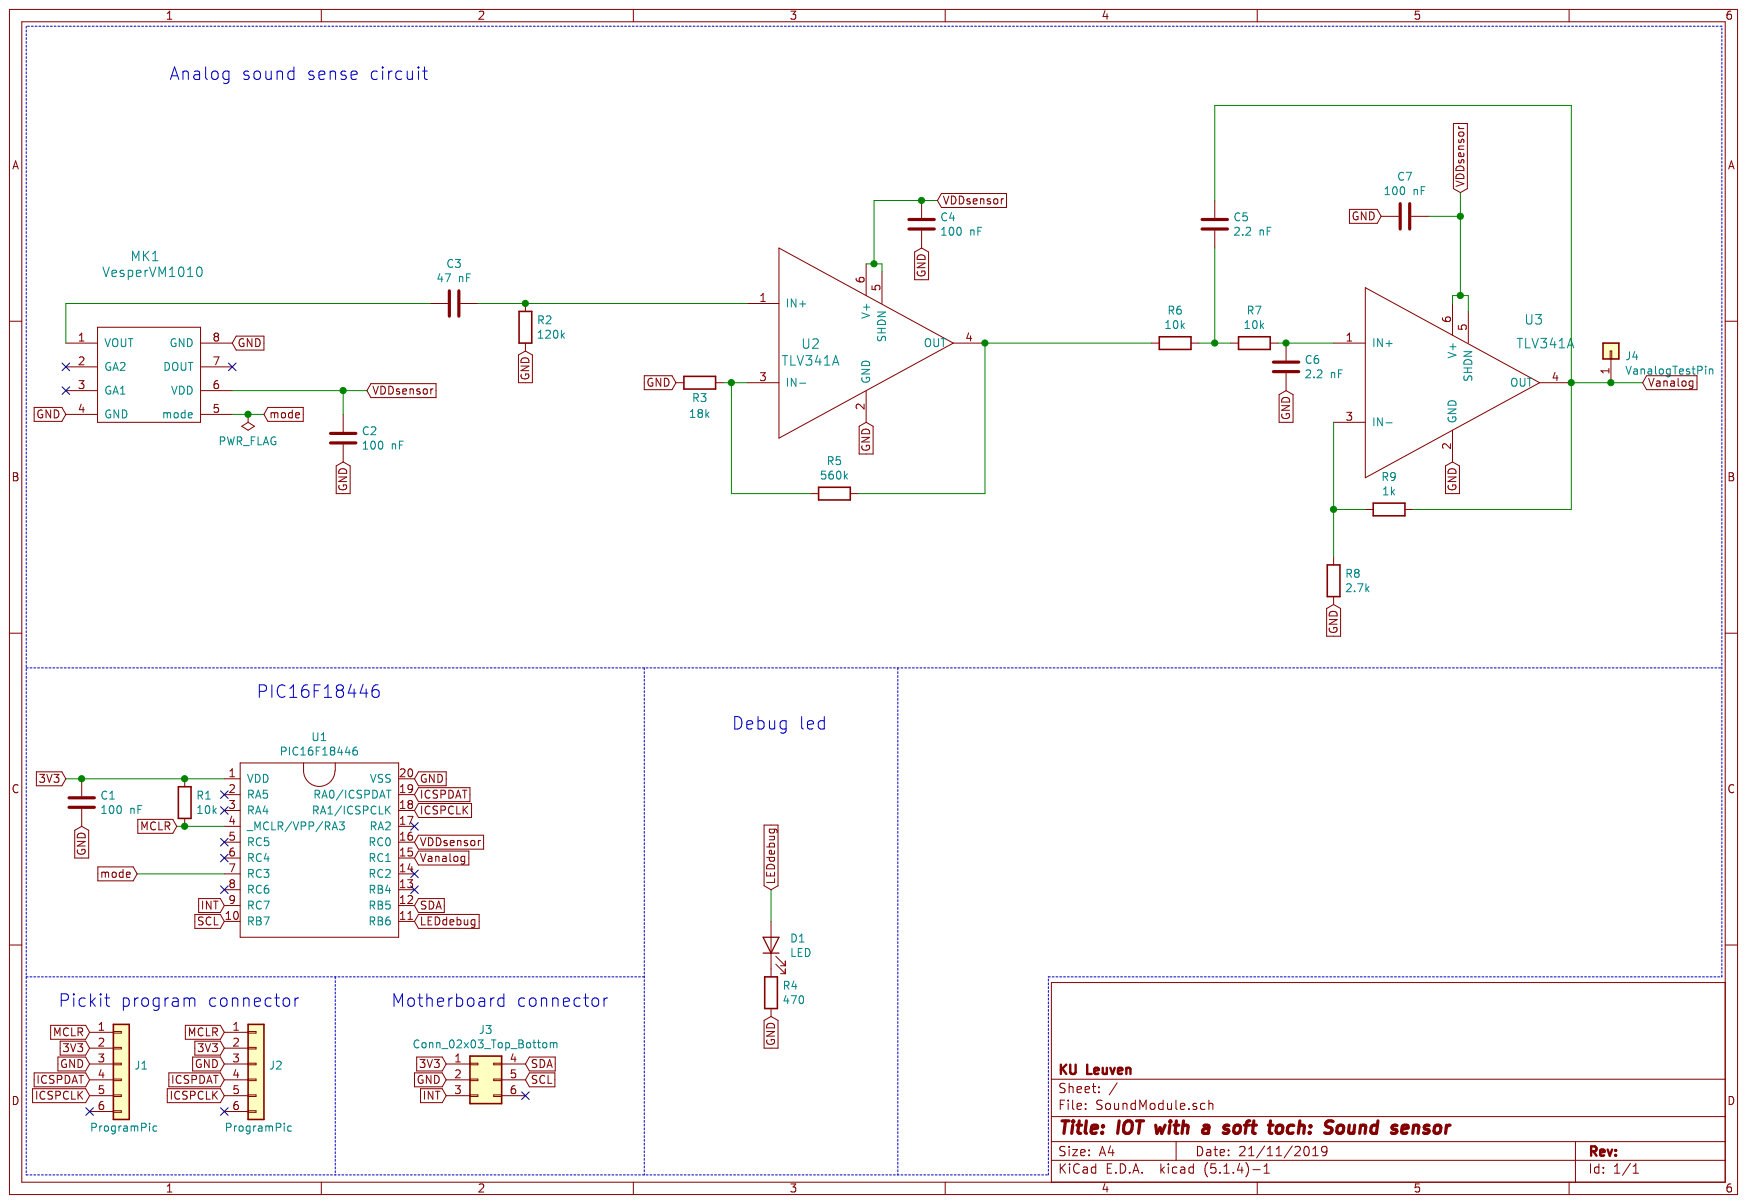
[picture p22: page 1]
