dramco-iwast/sensors/hardware/Buttons/Buttons_v2/schematics/Version_4/buttons_back_v4.pdf

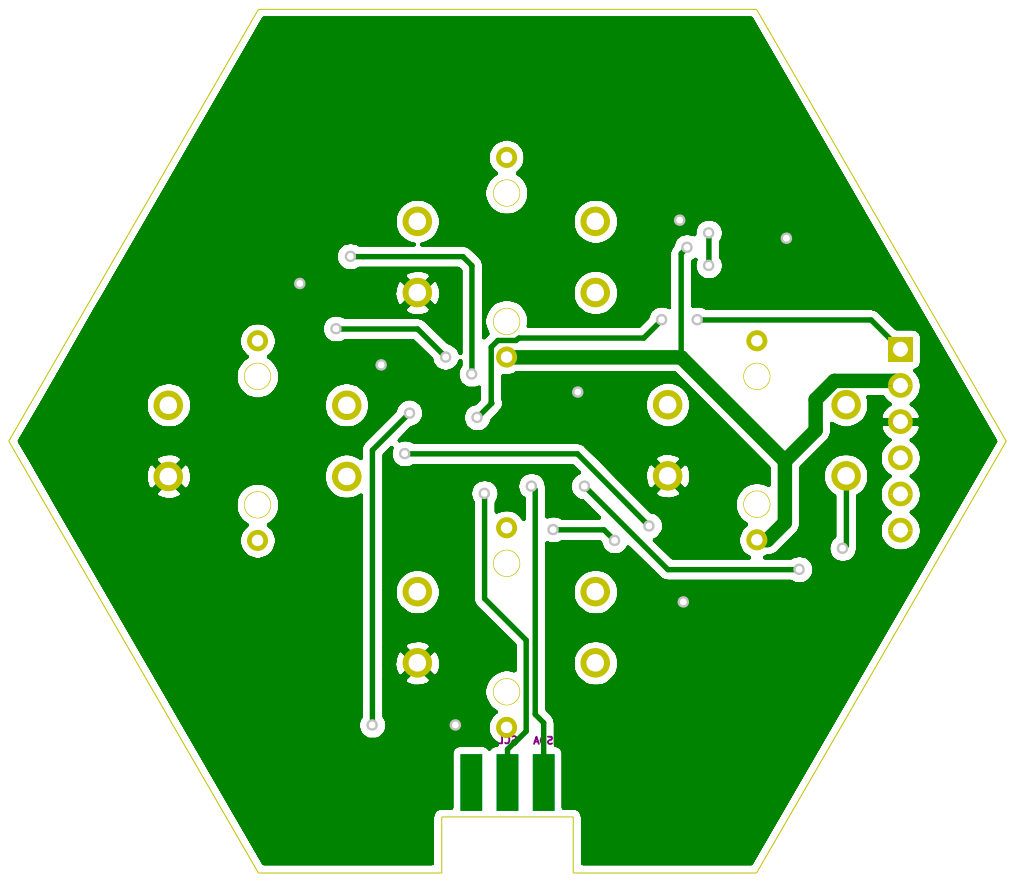
[picture p23: page 1]
