dramco-iwast/sensors/hardware/Buttons/Buttons_v2/schematics/Version_4/buttons_front_v4.pdf

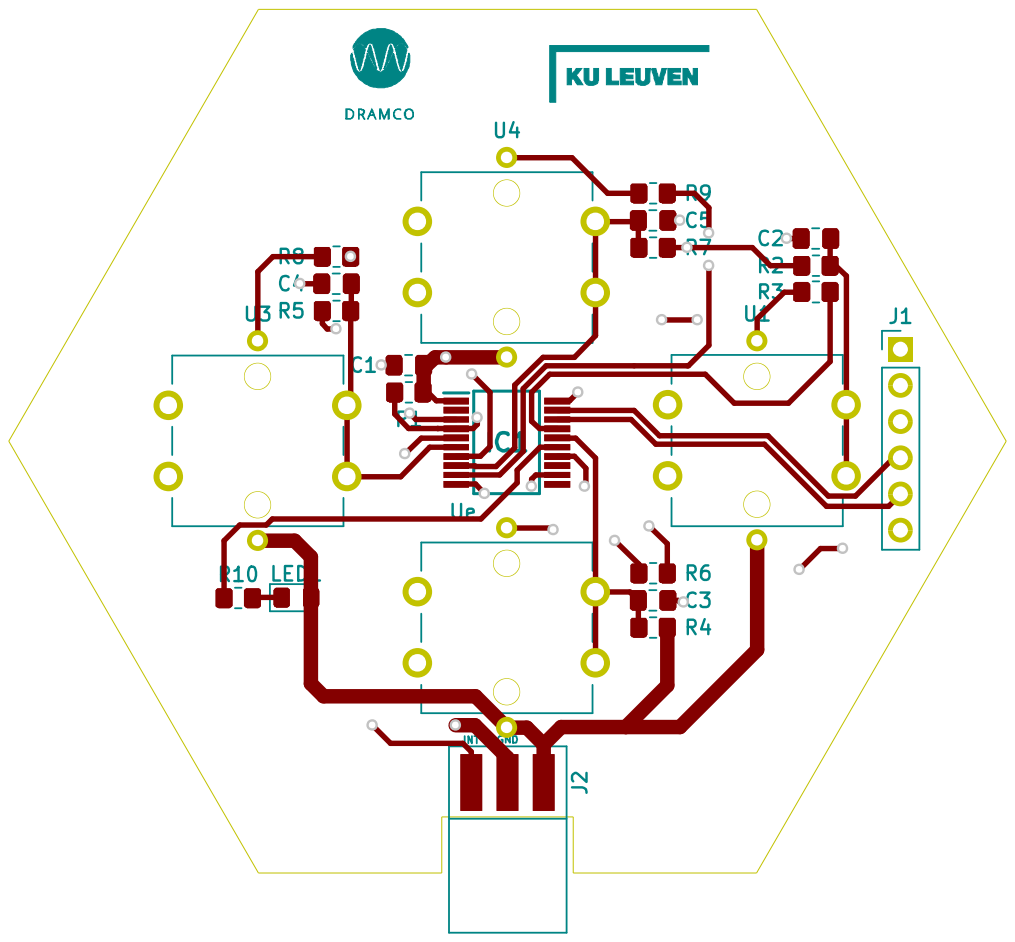
[picture p24: page 1]
