dramco-iwast/sensors/hardware/Buttons/Buttons_v2/schematics/Version_4/buttons_schematic_v4.pdf

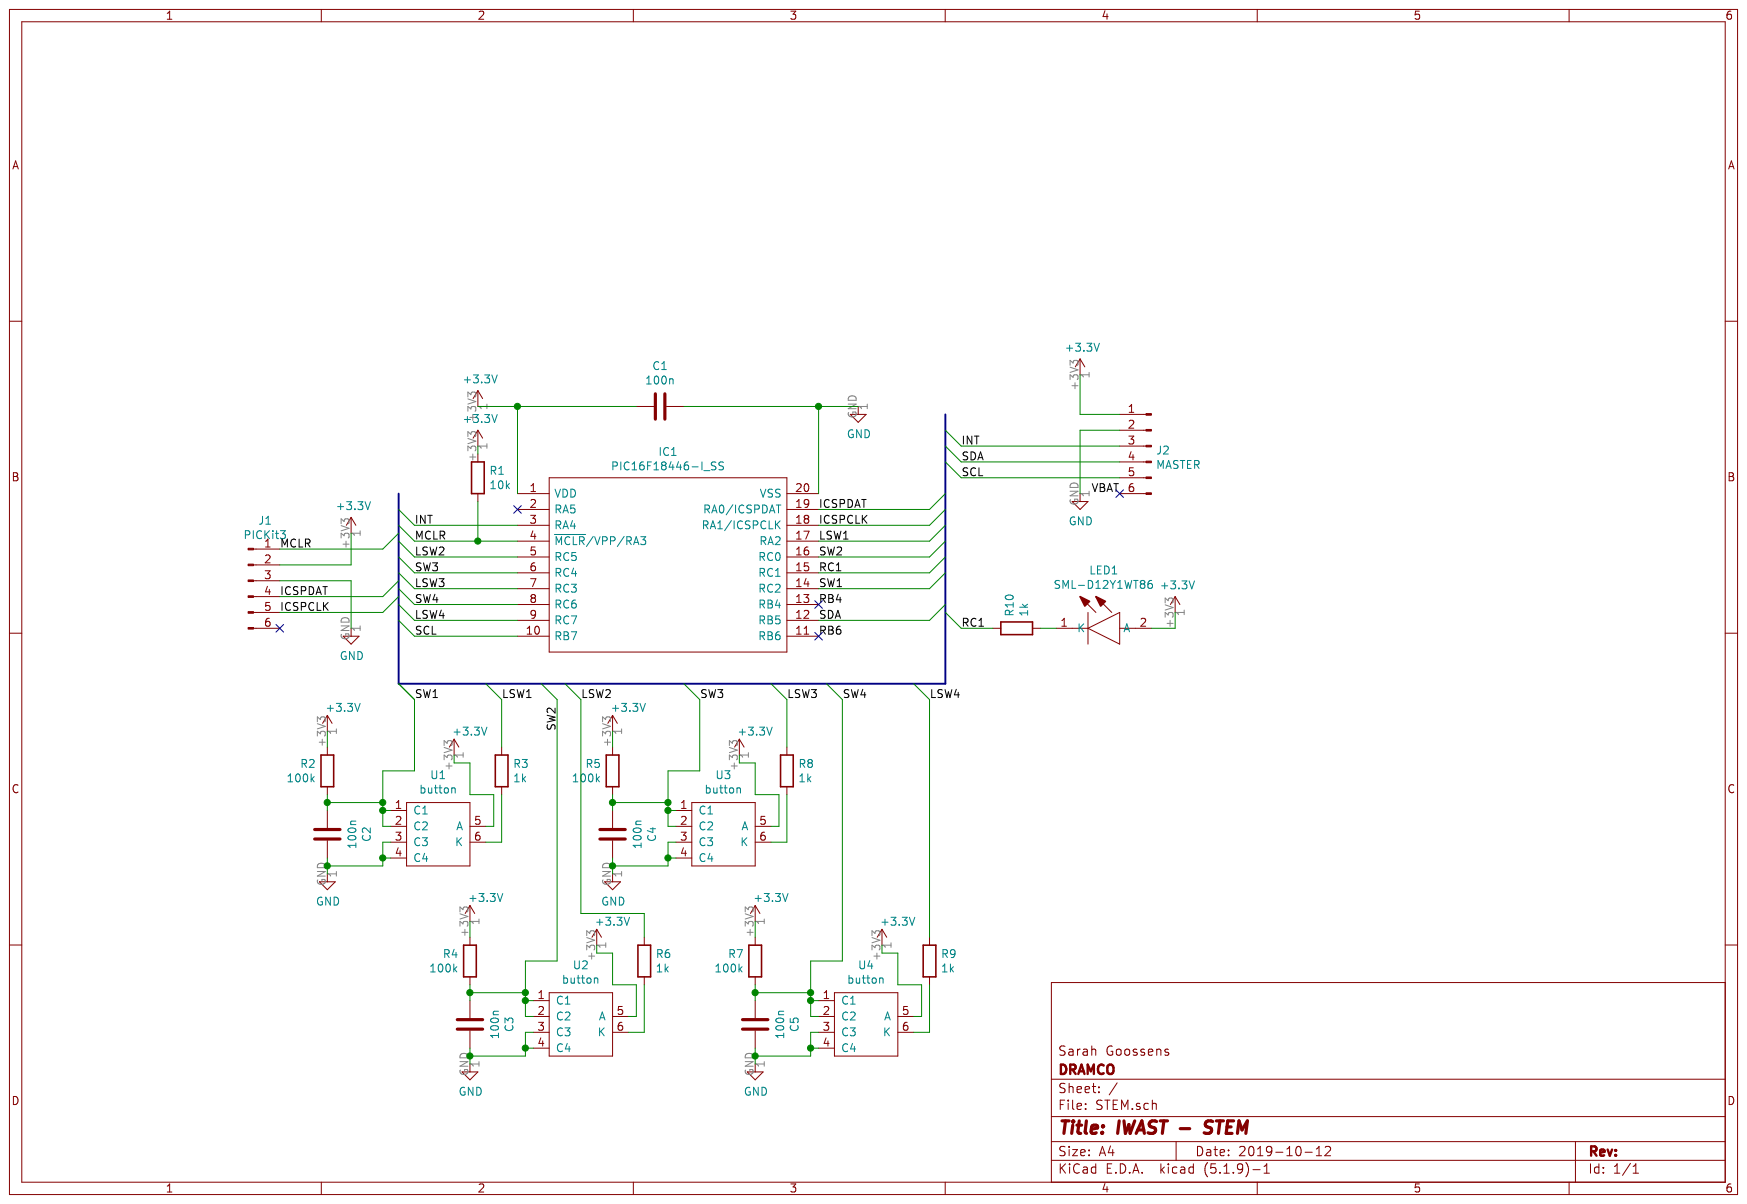
[picture p25: page 1]
