dramco-iwast/sensors/hardware/Air_Quality/air_quality_v2/schematics/back.pdf

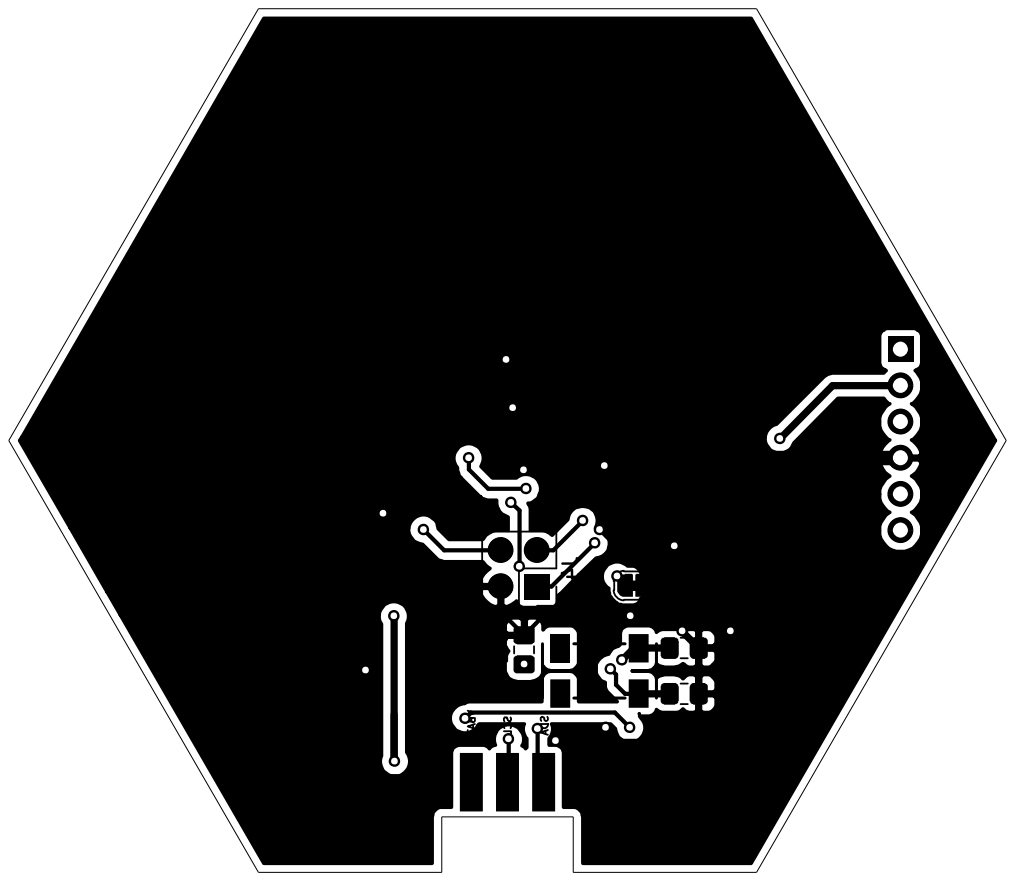
[picture p26: page 1]
