dramco-iwast/sensors/hardware/Air_Quality/air_quality_v2/schematics/front.pdf

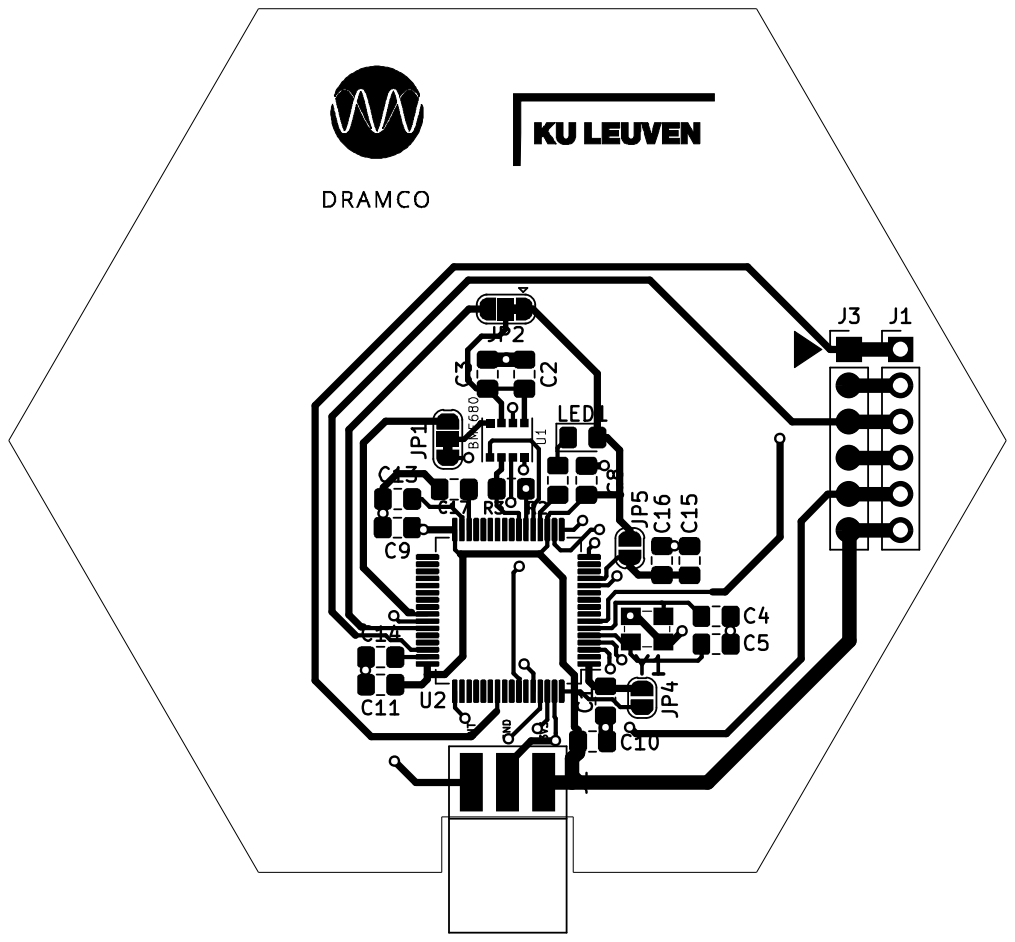
[picture p27: page 1]
