dramco-iwast/sensors/hardware/Air_Quality/air_quality_v2/schematics/schematic.pdf

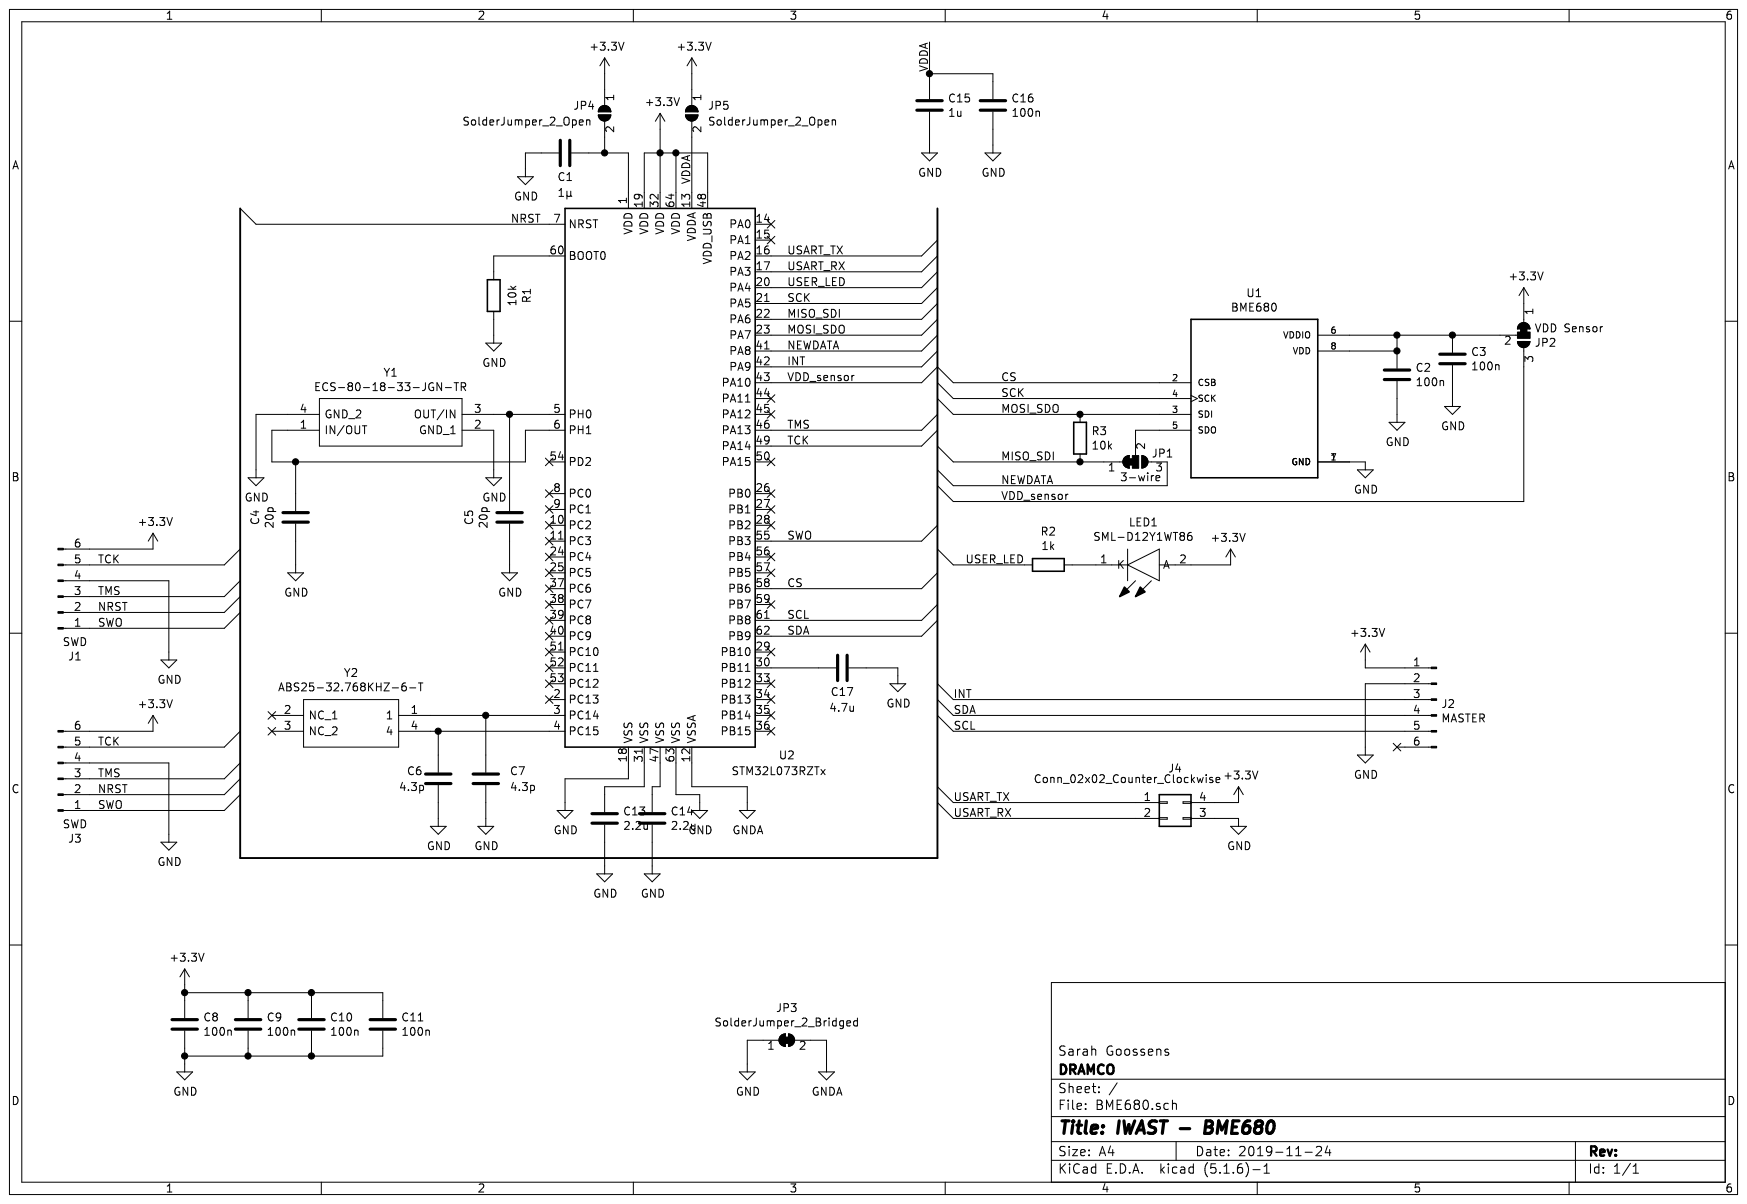
[picture p28: page 1]
