dramco-iwast/sensors/hardware/Power/Power_v2/schematic/power_module_v1_back.pdf

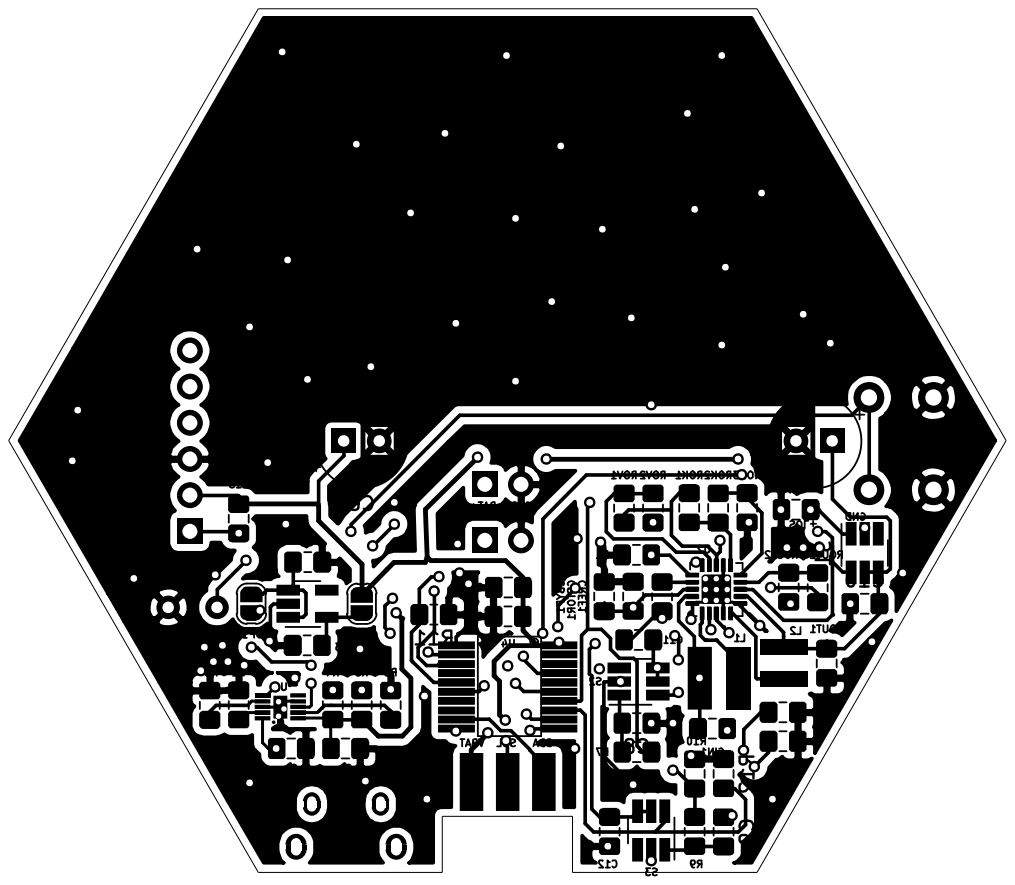
[picture p29: page 1]
