dramco-iwast/sensors/hardware/Power/Power_v2/schematic/power_module_v1_front.pdf

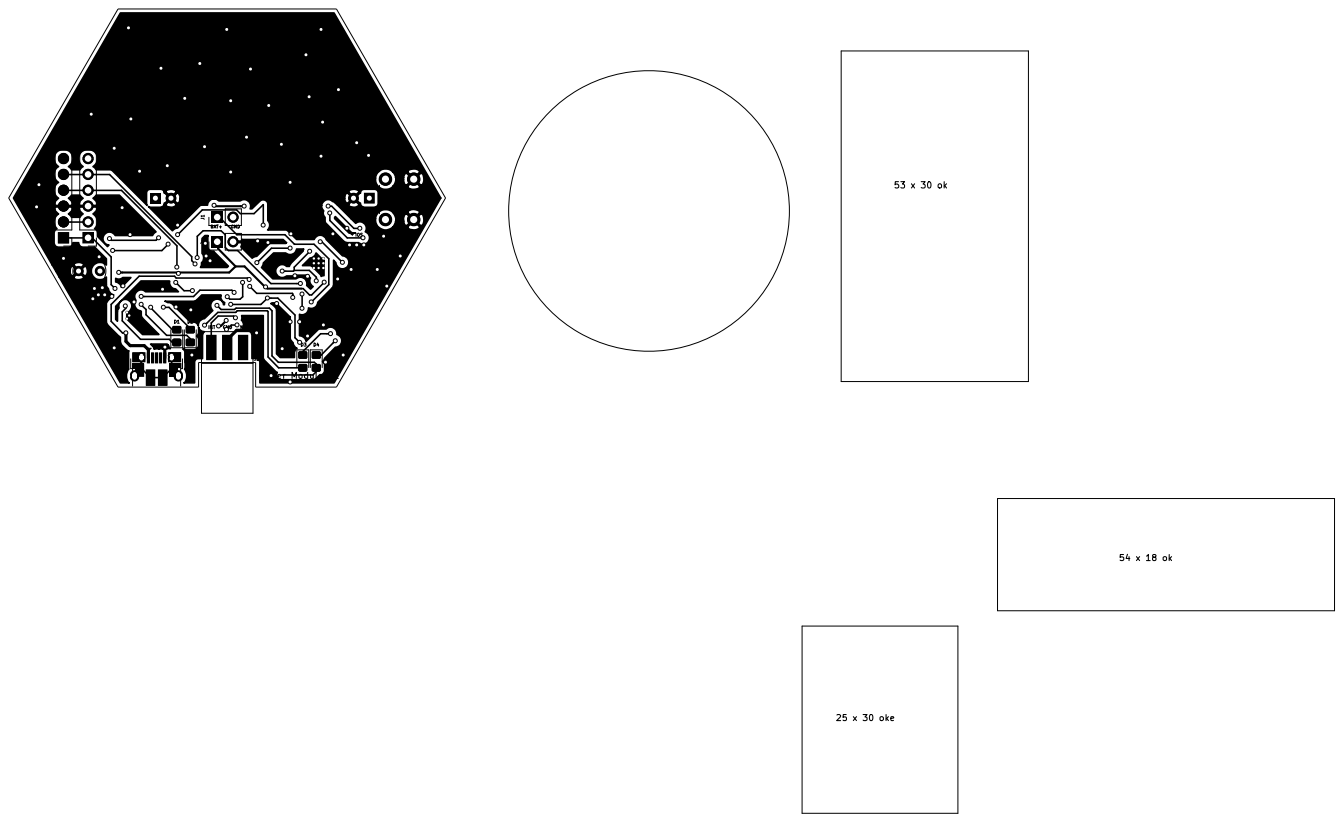
[picture p30: page 1]
