dramco-iwast/sensors/hardware/Power/Power_v2/schematic/power_module_v1_schematic.pdf

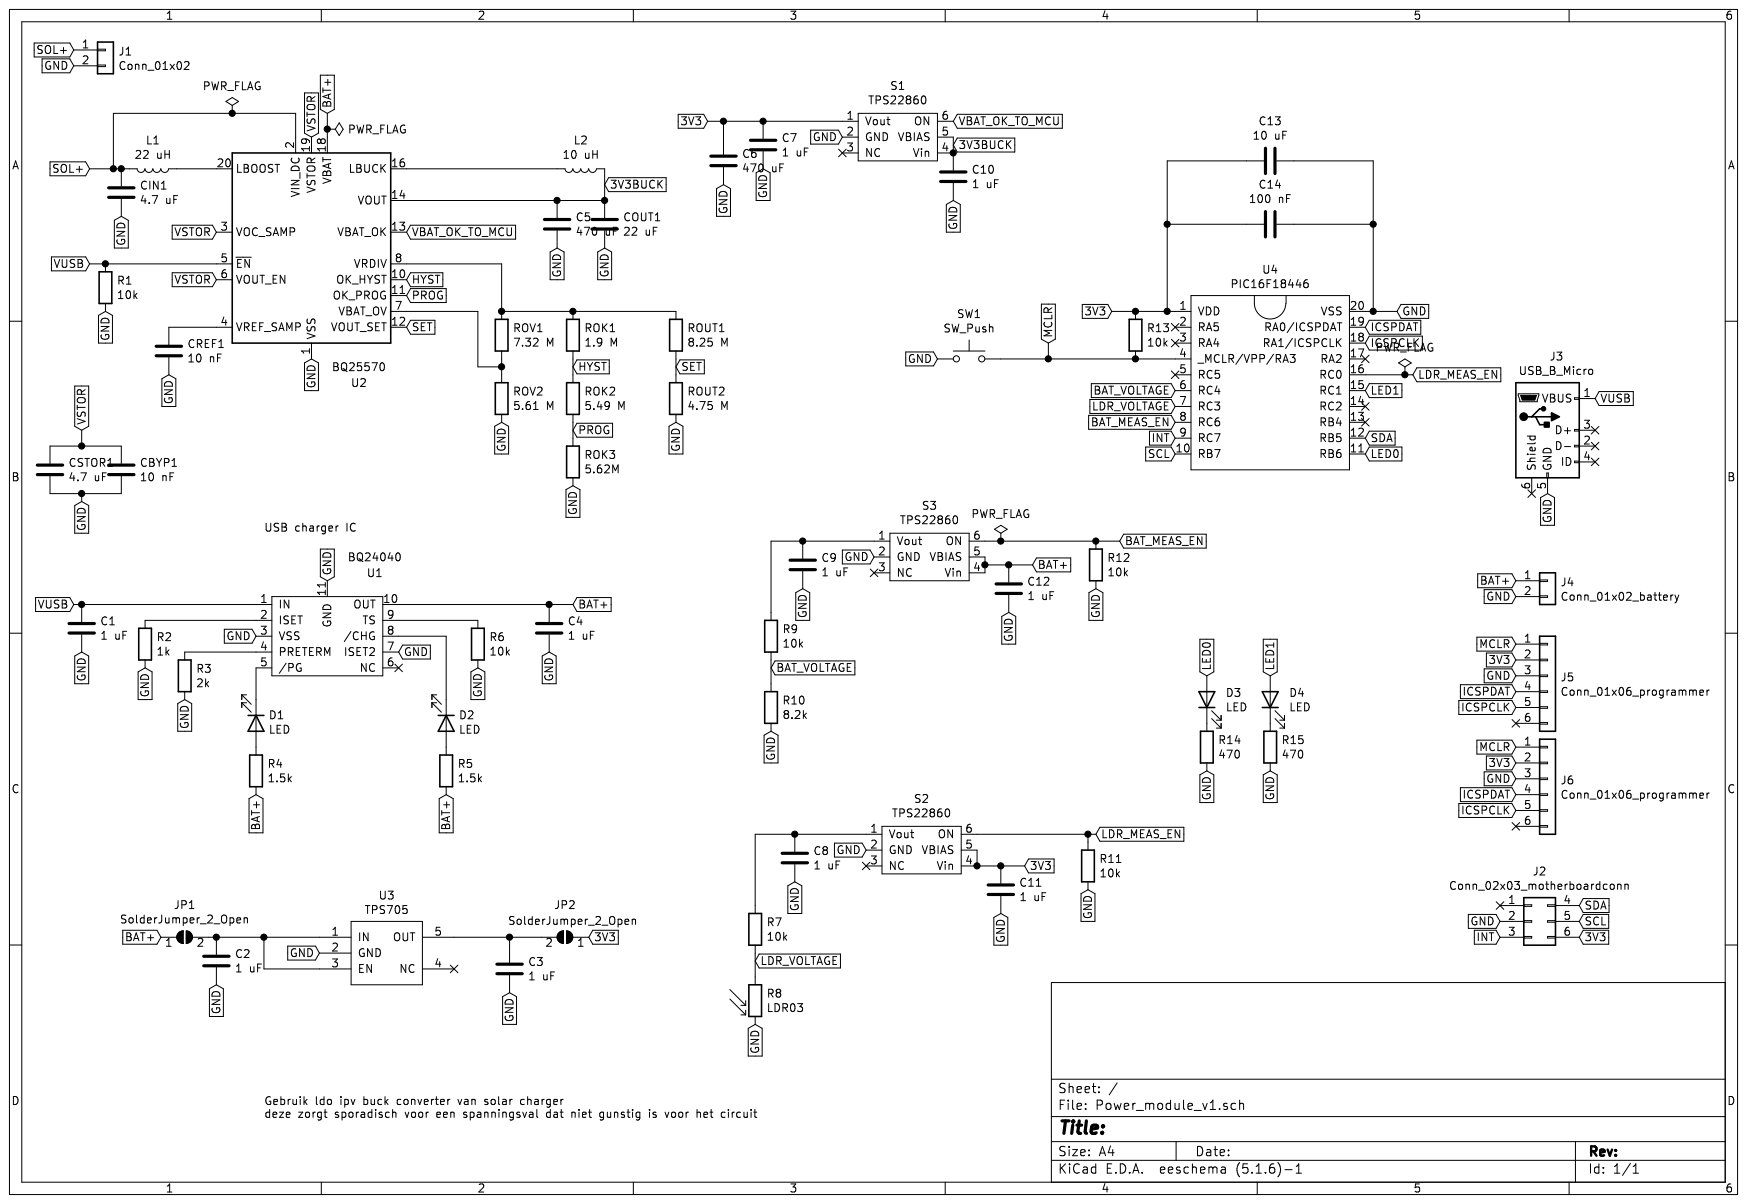
[picture p31: page 1]
