dramco-iwast/sensors/hardware/Sound_Level/SoundModulev2.1/schematics/sound_module_v2.1_back.pdf

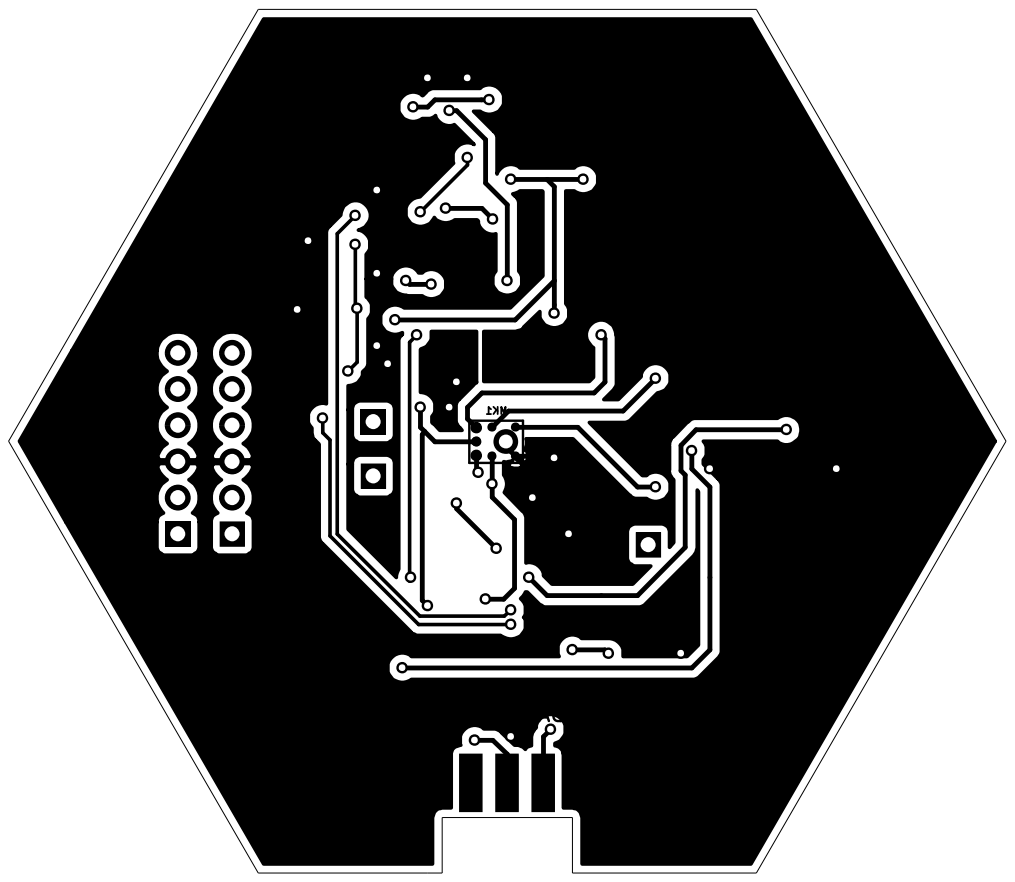
[picture p32: page 1]
