dramco-iwast/sensors/hardware/Sound_Level/SoundModulev2.1/schematics/sound_module_v2.1_front.pdf

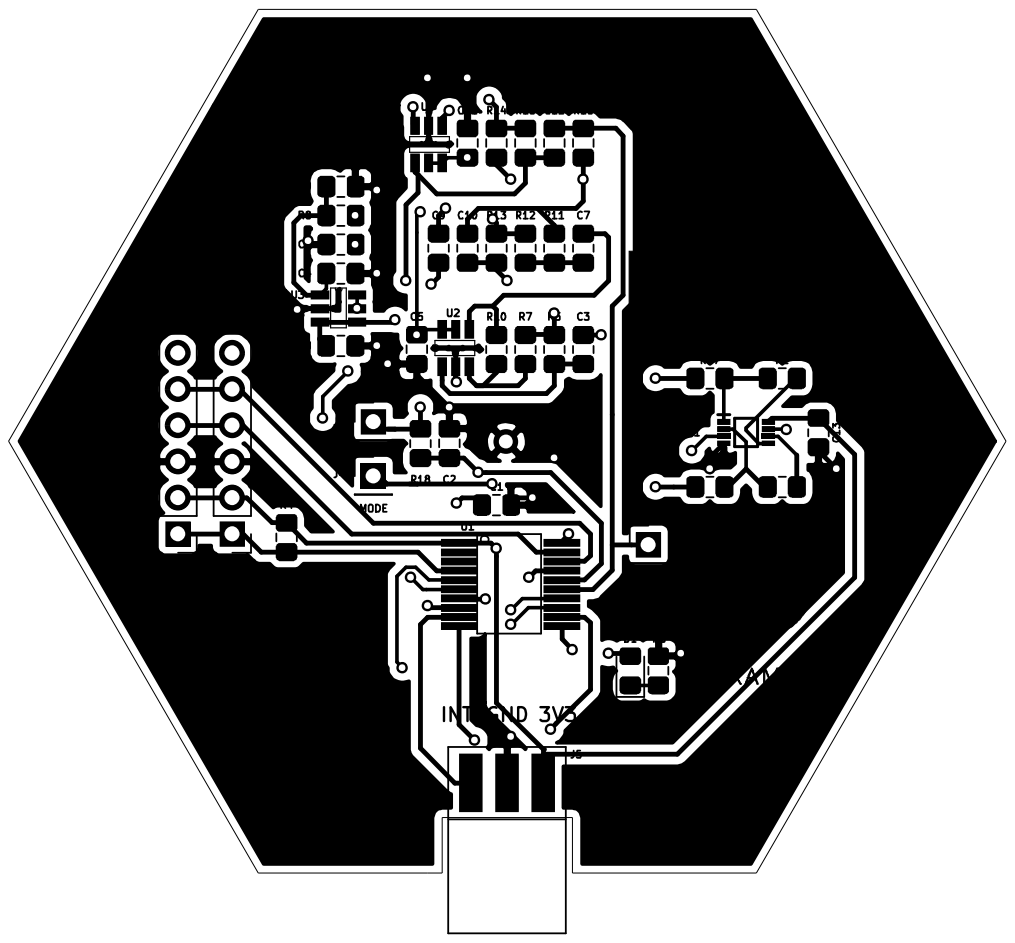
[picture p33: page 1]
