dramco-iwast/sensors/hardware/Sound_Level/SoundModulev2.1/schematics/sound_module_v2.1_schematic.pdf

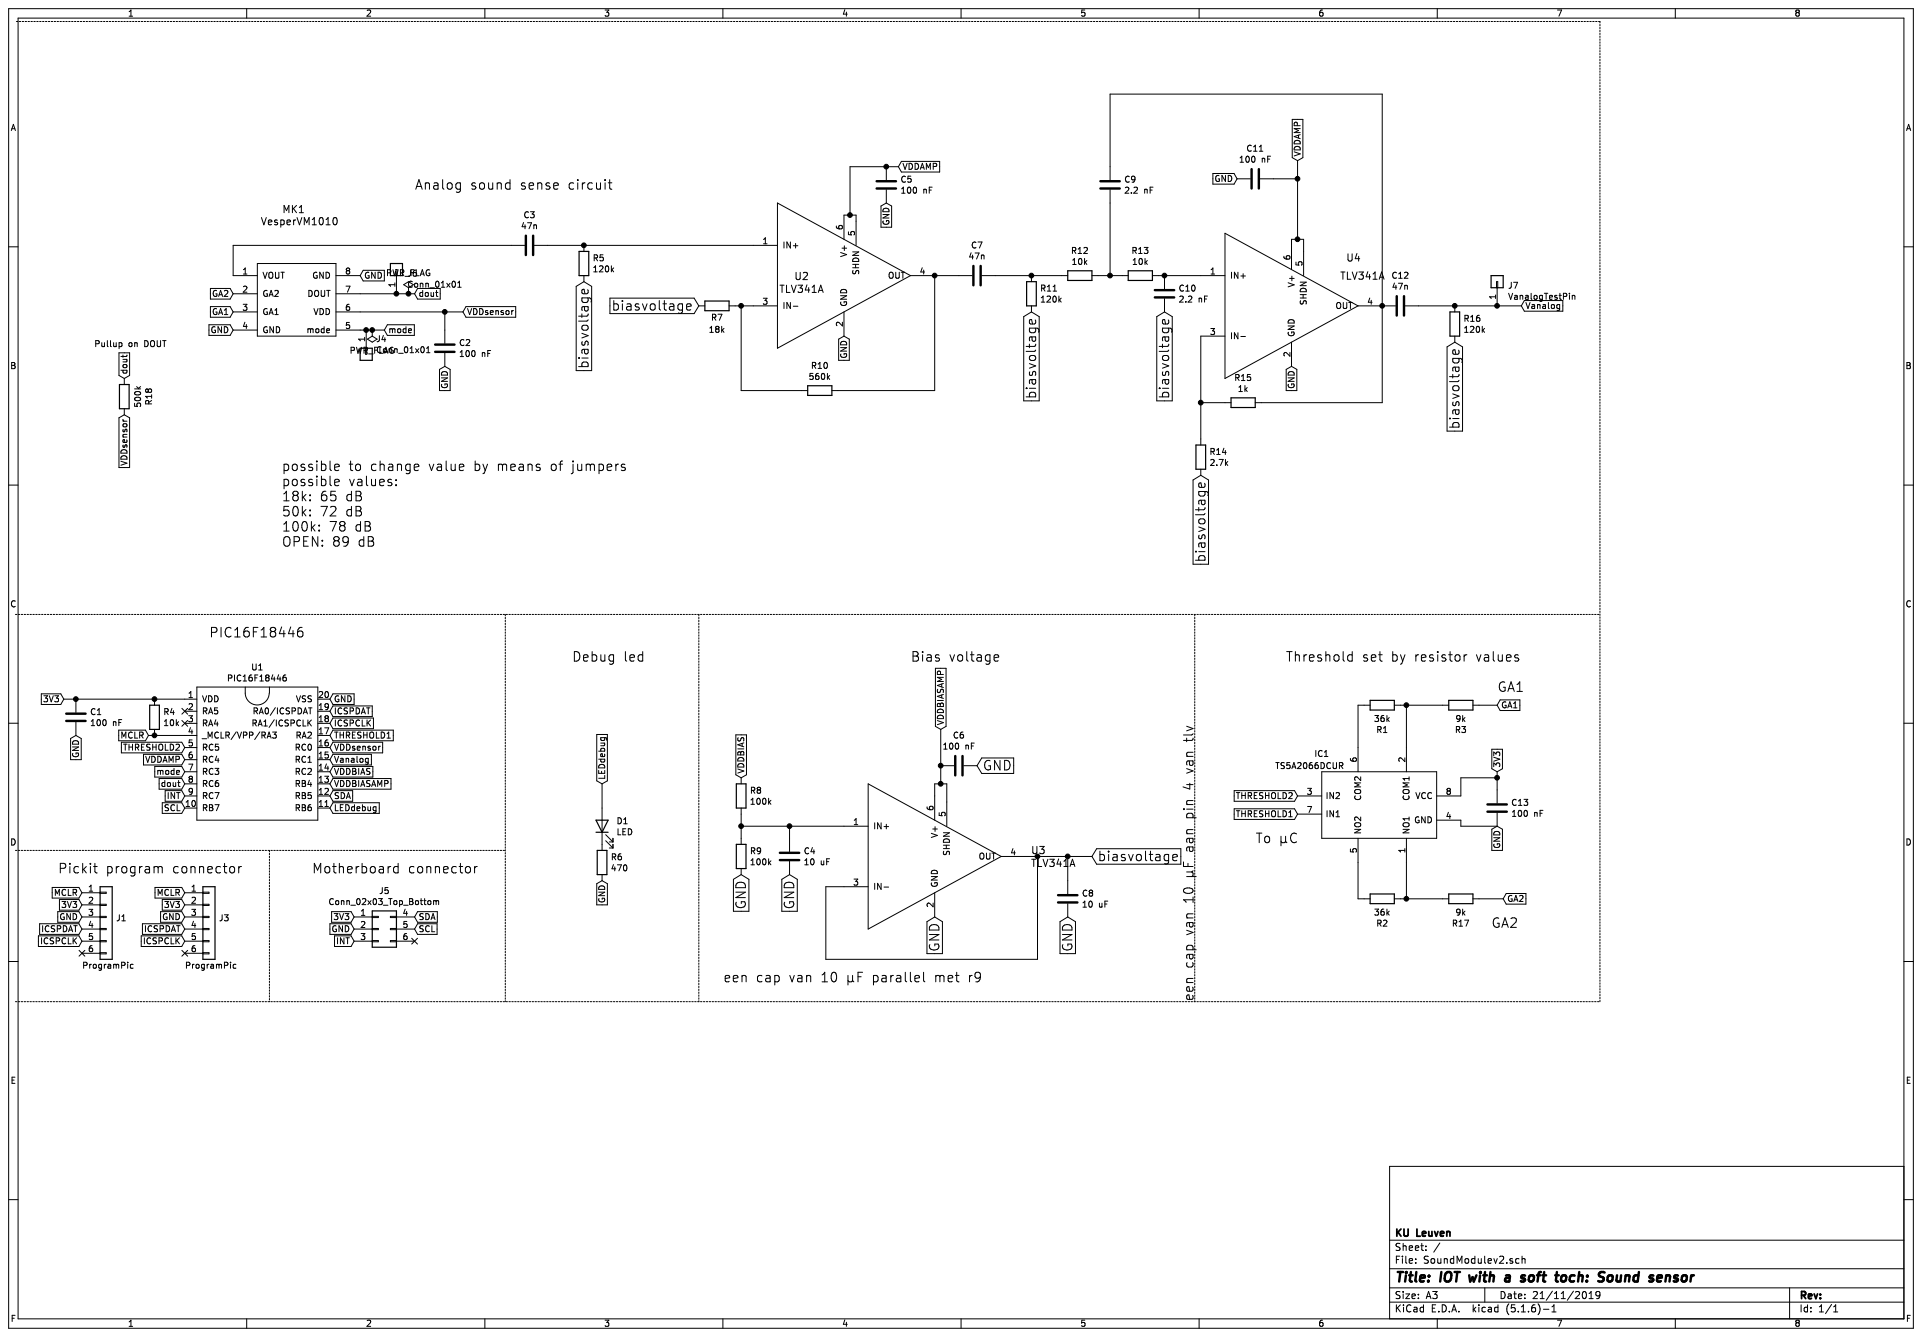
[picture p34: page 1]
