dramco-iwast/sensors/hardware/Air_Quality/air_quality_v1/schematics/BME680_back.pdf

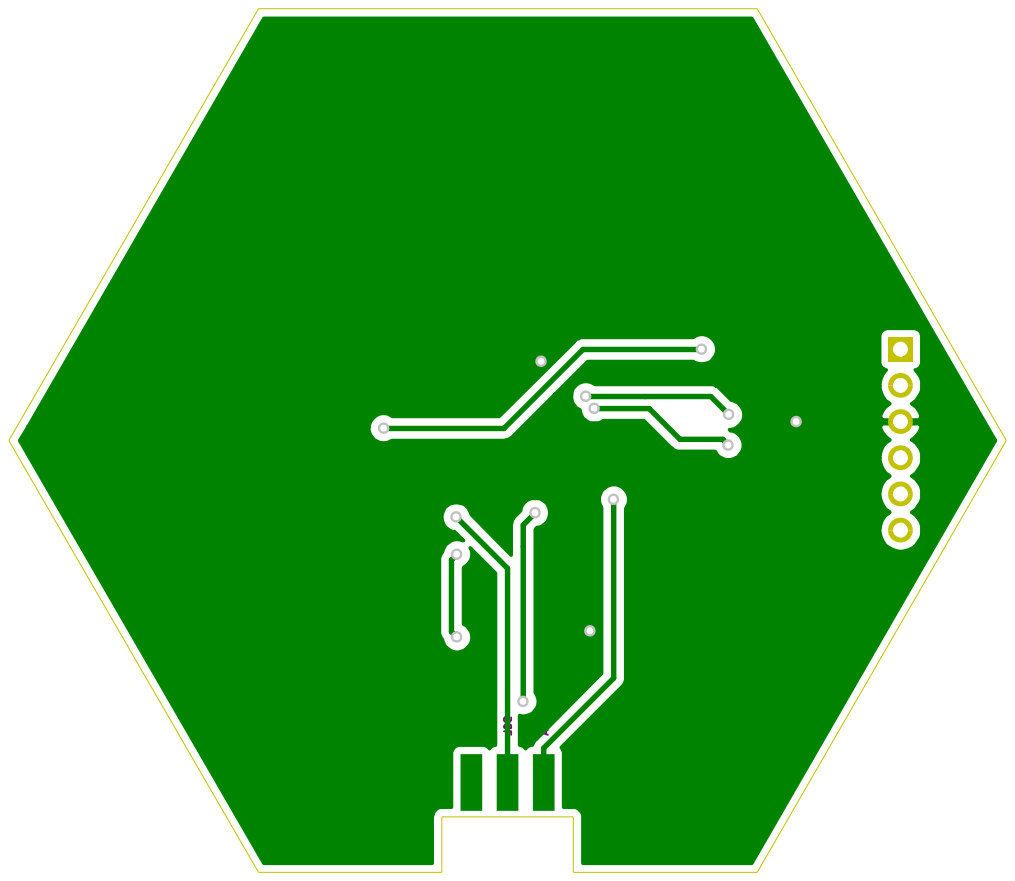
[picture p35: page 1]
