dramco-iwast/sensors/hardware/Air_Quality/air_quality_v1/schematics/BME680_front.pdf

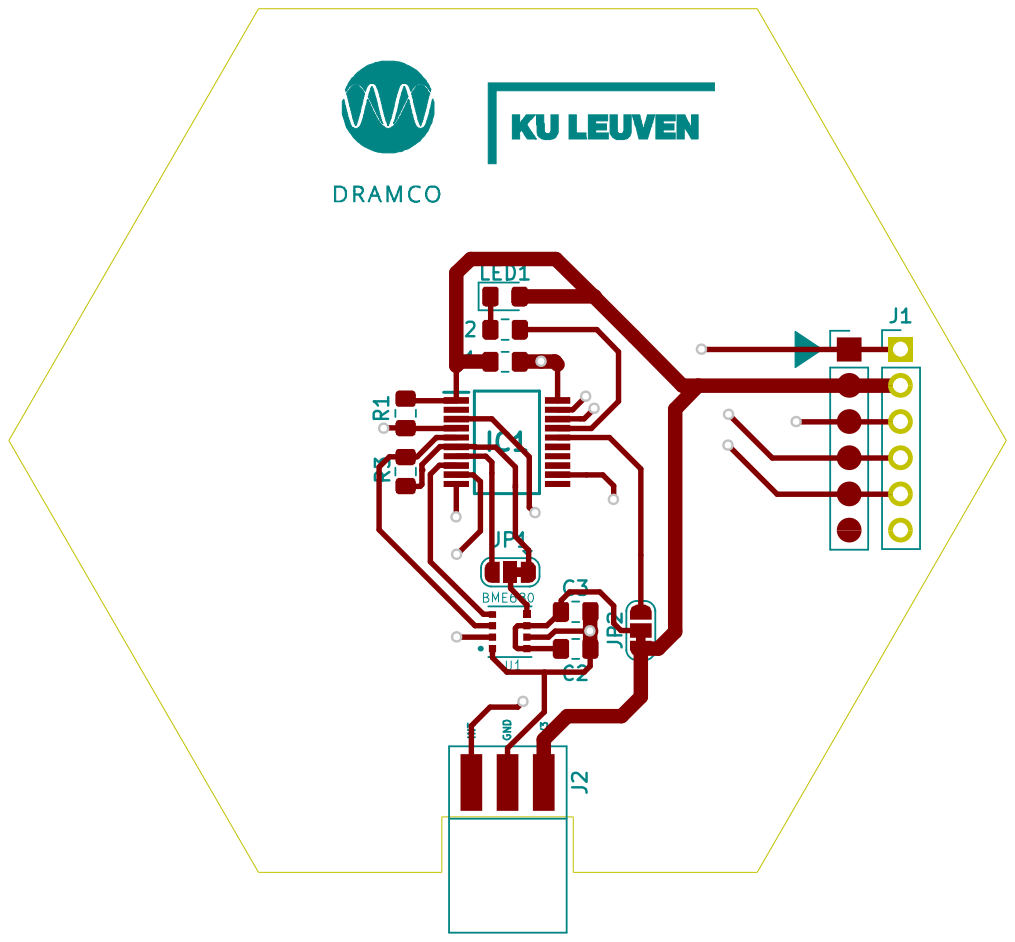
[picture p36: page 1]
