dramco-iwast/sensors/hardware/Air_Quality/air_quality_v1/schematics/BME680_schematic.pdf

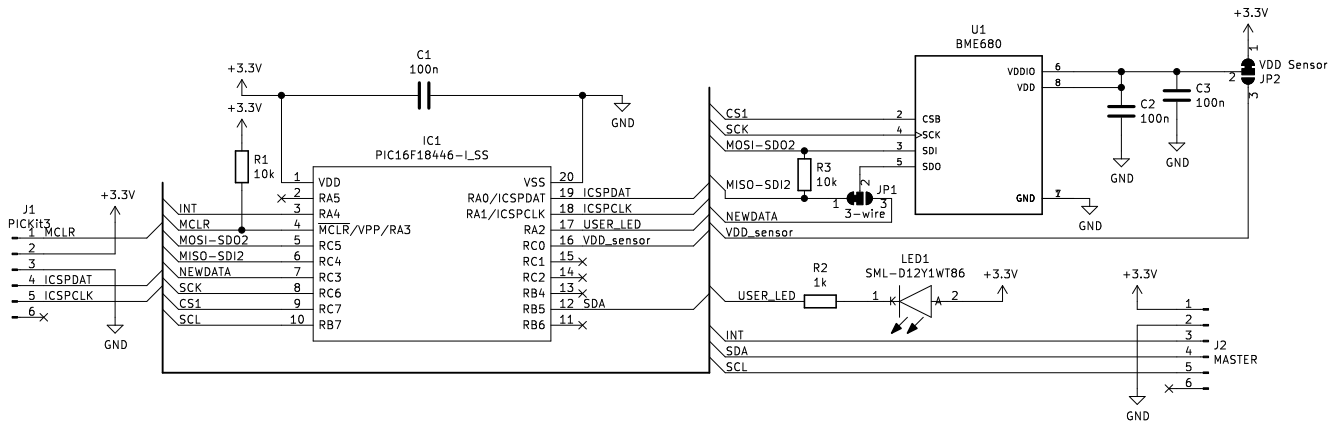
[picture p37: page 1]
