dramco-iwast/sensors/hardware/Buttons/Buttons_v1/schematics/Version_1/buttons_back_v1.pdf

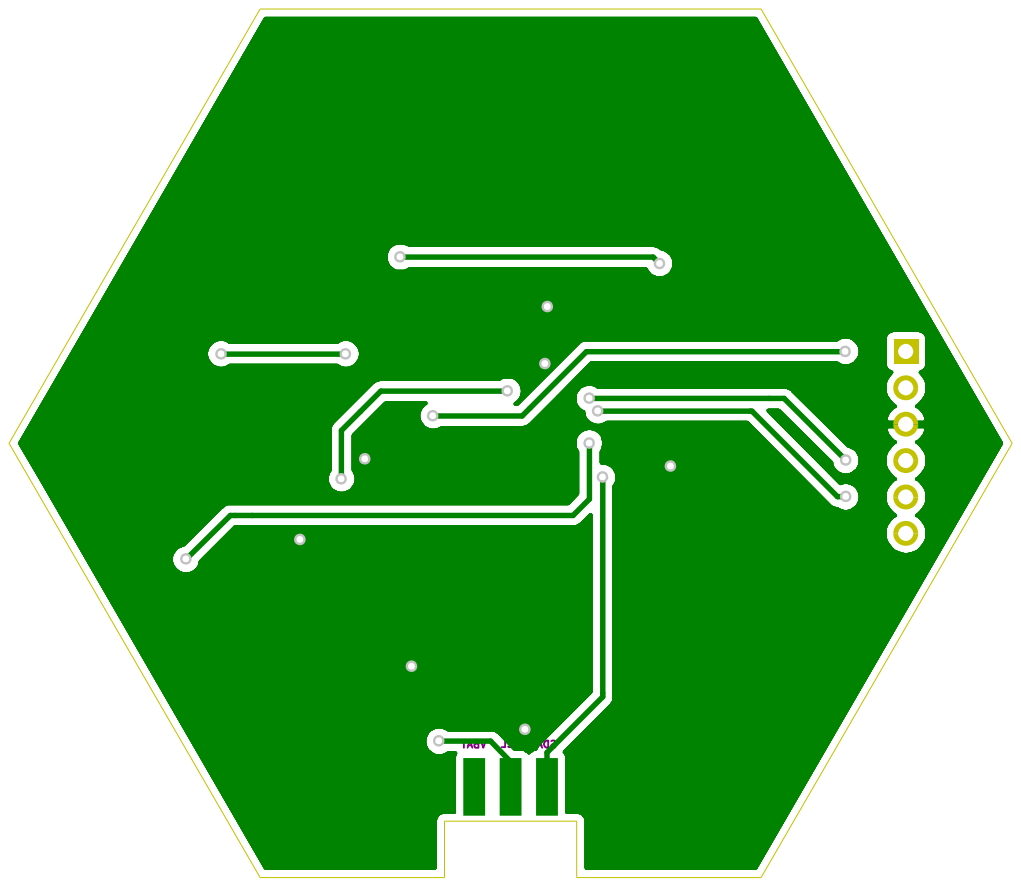
[picture p38: page 1]
