dramco-iwast/sensors/hardware/Buttons/Buttons_v1/schematics/Version_1/buttons_front_v1.pdf

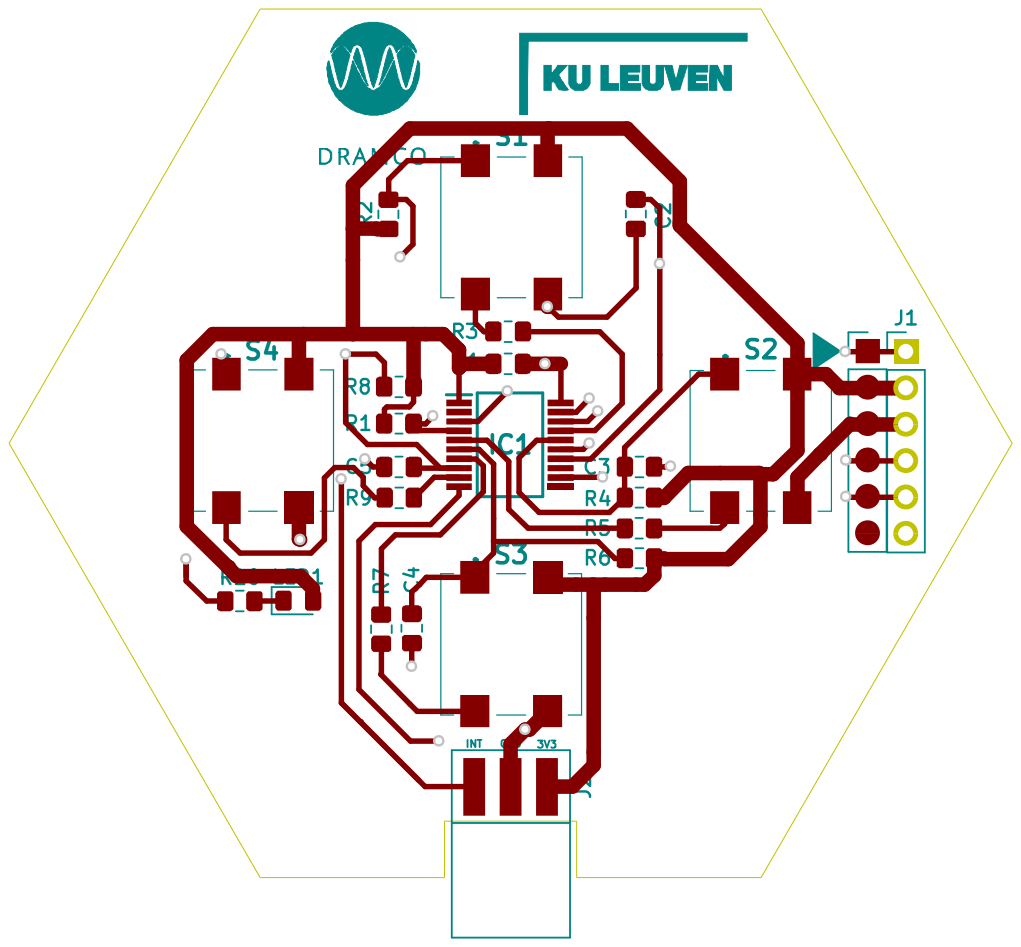
[picture p39: page 1]
