dramco-iwast/sensors/hardware/Buttons/Buttons_v1/schematics/Version_1/buttons_schematic_v1.pdf

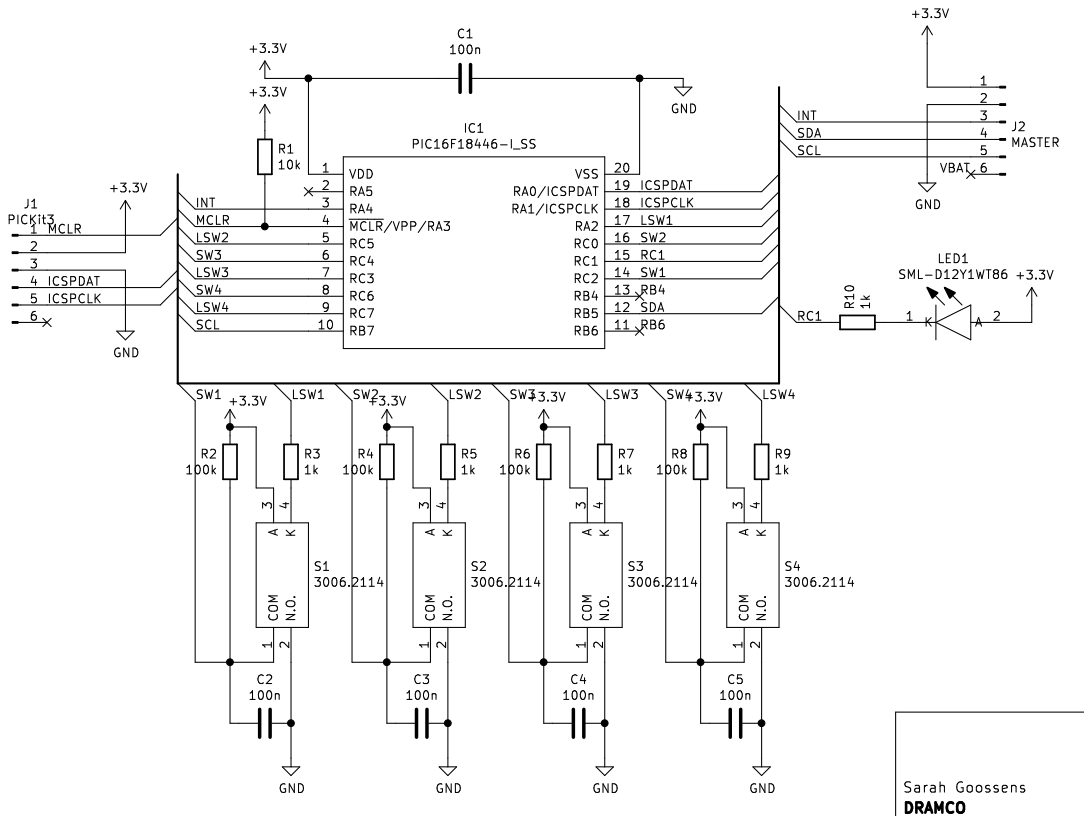
[picture p40: page 1]
