dramco-iwast/sensors/hardware/Buttons/Buttons_v1/kicadproject/STEM.kicad_pcb

## KiCad design hardware/Buttons/Buttons_v1/kicadproject/STEM.kicad_pcb (2021-09-02, an earlier design)

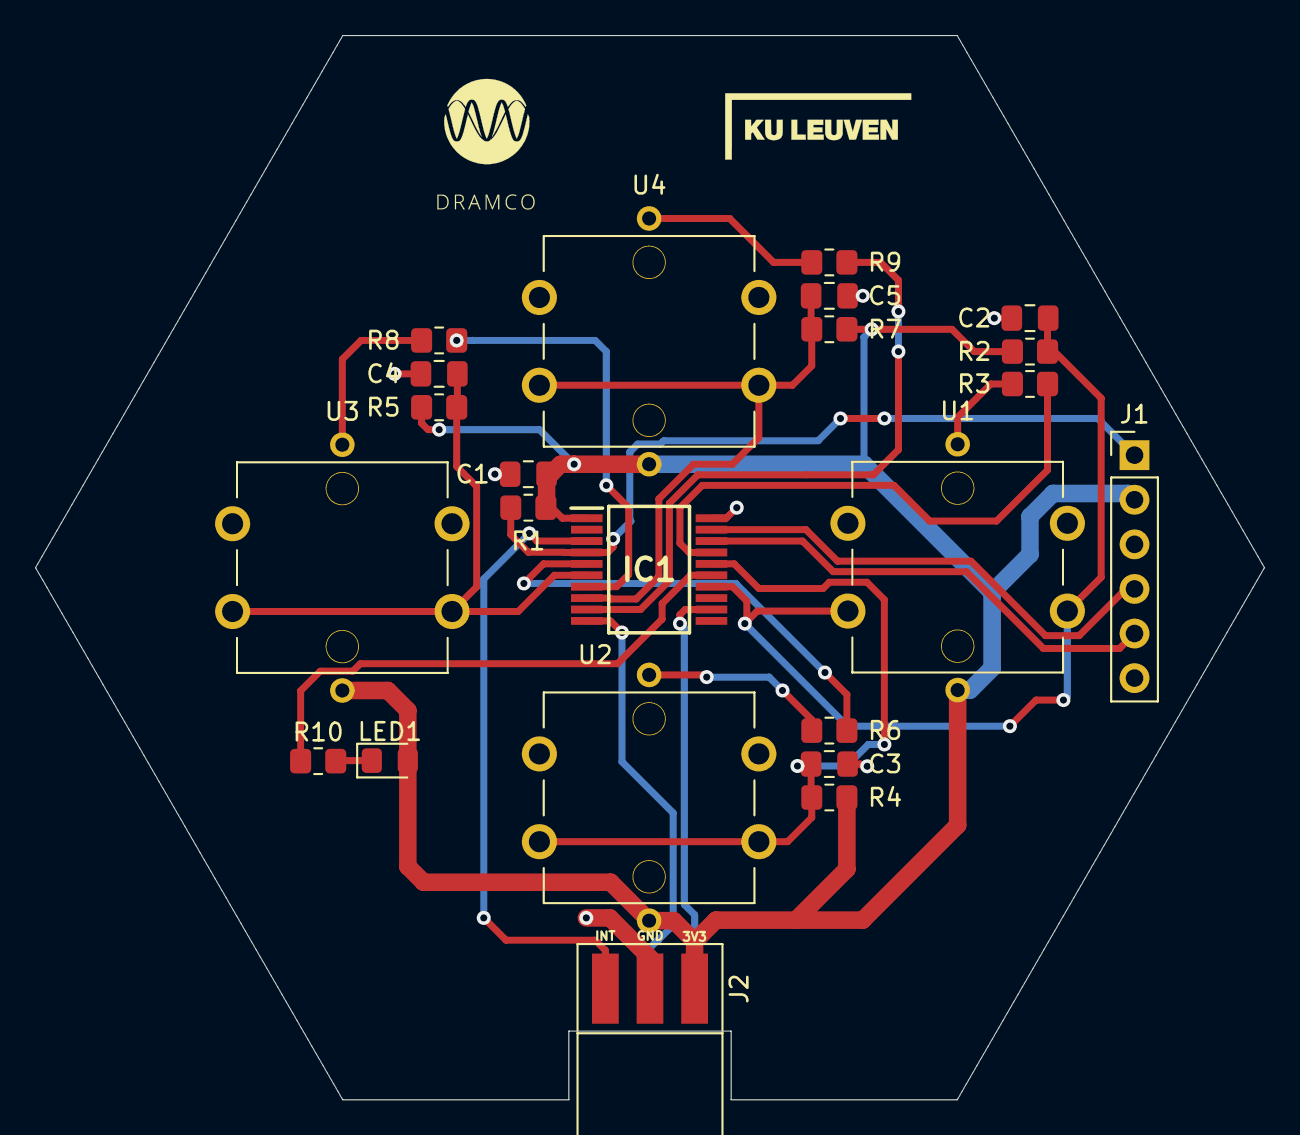
[picture p43: board STEM.kicad_pcb from above]

Board: 2 copper layers, 70.0 x 60.6 mm, 23 parts (0 on the bottom side), 22 nets.

Parts:
C1, C2, C3, C4, C5: 100n; C_0805_2012Metric_Pad1.18x1.45mm_HandSolder
IC1: PIC16F18446-I_SS; SOP65P780X200-20N
J1: PICKit3; PinHeader_1x06_P2.54mm_Vertical
J2: MASTER; ConnectorHorizontalPcb
LED1: SML-D12Y1WT86; LED_0805_2012Metric_Pad1.15x1.40mm_HandSolder
R1: 10k; R_0805_2012Metric_Pad1.20x1.40mm_HandSolder
R2, R4, R5, R7: 100k; R_0805_2012Metric_Pad1.20x1.40mm_HandSolder
R3, R6, R8, R9, R10: 1k; R_0805_2012Metric_Pad1.20x1.40mm_HandSolder
U1, U2, U3, U4: button; aliButton

Connections:
+3V3: C1.1, IC1.1, J1.2, J2.1, LED1.2, R1.1, R2.1, R4.1, R5.1, R7.1, U1.5, U2.5, U3.5, U4.5
/ICSPCLK: IC1.18, J1.5
/ICSPDAT: IC1.19, J1.4
/INT: IC1.3, J2.3
/LSW1: IC1.17, R3.1
/LSW2: IC1.5, R6.1
/LSW3: IC1.7, R8.1
/LSW4: IC1.9, R9.1
/MCLR: IC1.4, J1.1, R1.2
/RC1: IC1.15, R10.1
/SCL: IC1.10, J2.5
/SDA: IC1.12, J2.4
/SW1: C2.2, IC1.14, R2.2, U1.1, U1.2
/SW2: C3.2, IC1.16, R4.2, U2.1, U2.2
/SW3: C4.2, IC1.6, R5.2, U3.1, U3.2
/SW4: C5.2, IC1.8, R7.2, U4.1, U4.2
GND: C1.2, C2.1, C3.1, C4.1, C5.1, IC1.20, J1.3, J2.2, U1.3, U1.4, U2.3, U2.4, U3.3, U3.4, U4.3, U4.4
unnamed: LED1.1, R10.2
unnamed: R3.2, U1.6
unnamed: R6.2, U2.6
unnamed: R8.2, U3.6
unnamed: R9.2, U4.6
