dramco-iwast/sensors/hardware/Power/Power_v6/kicadproject/Power_module_v1.kicad_pcb

## KiCad design hardware/Power/Power_v6/kicadproject/Power_module_v1.kicad_pcb (2021-11-15)

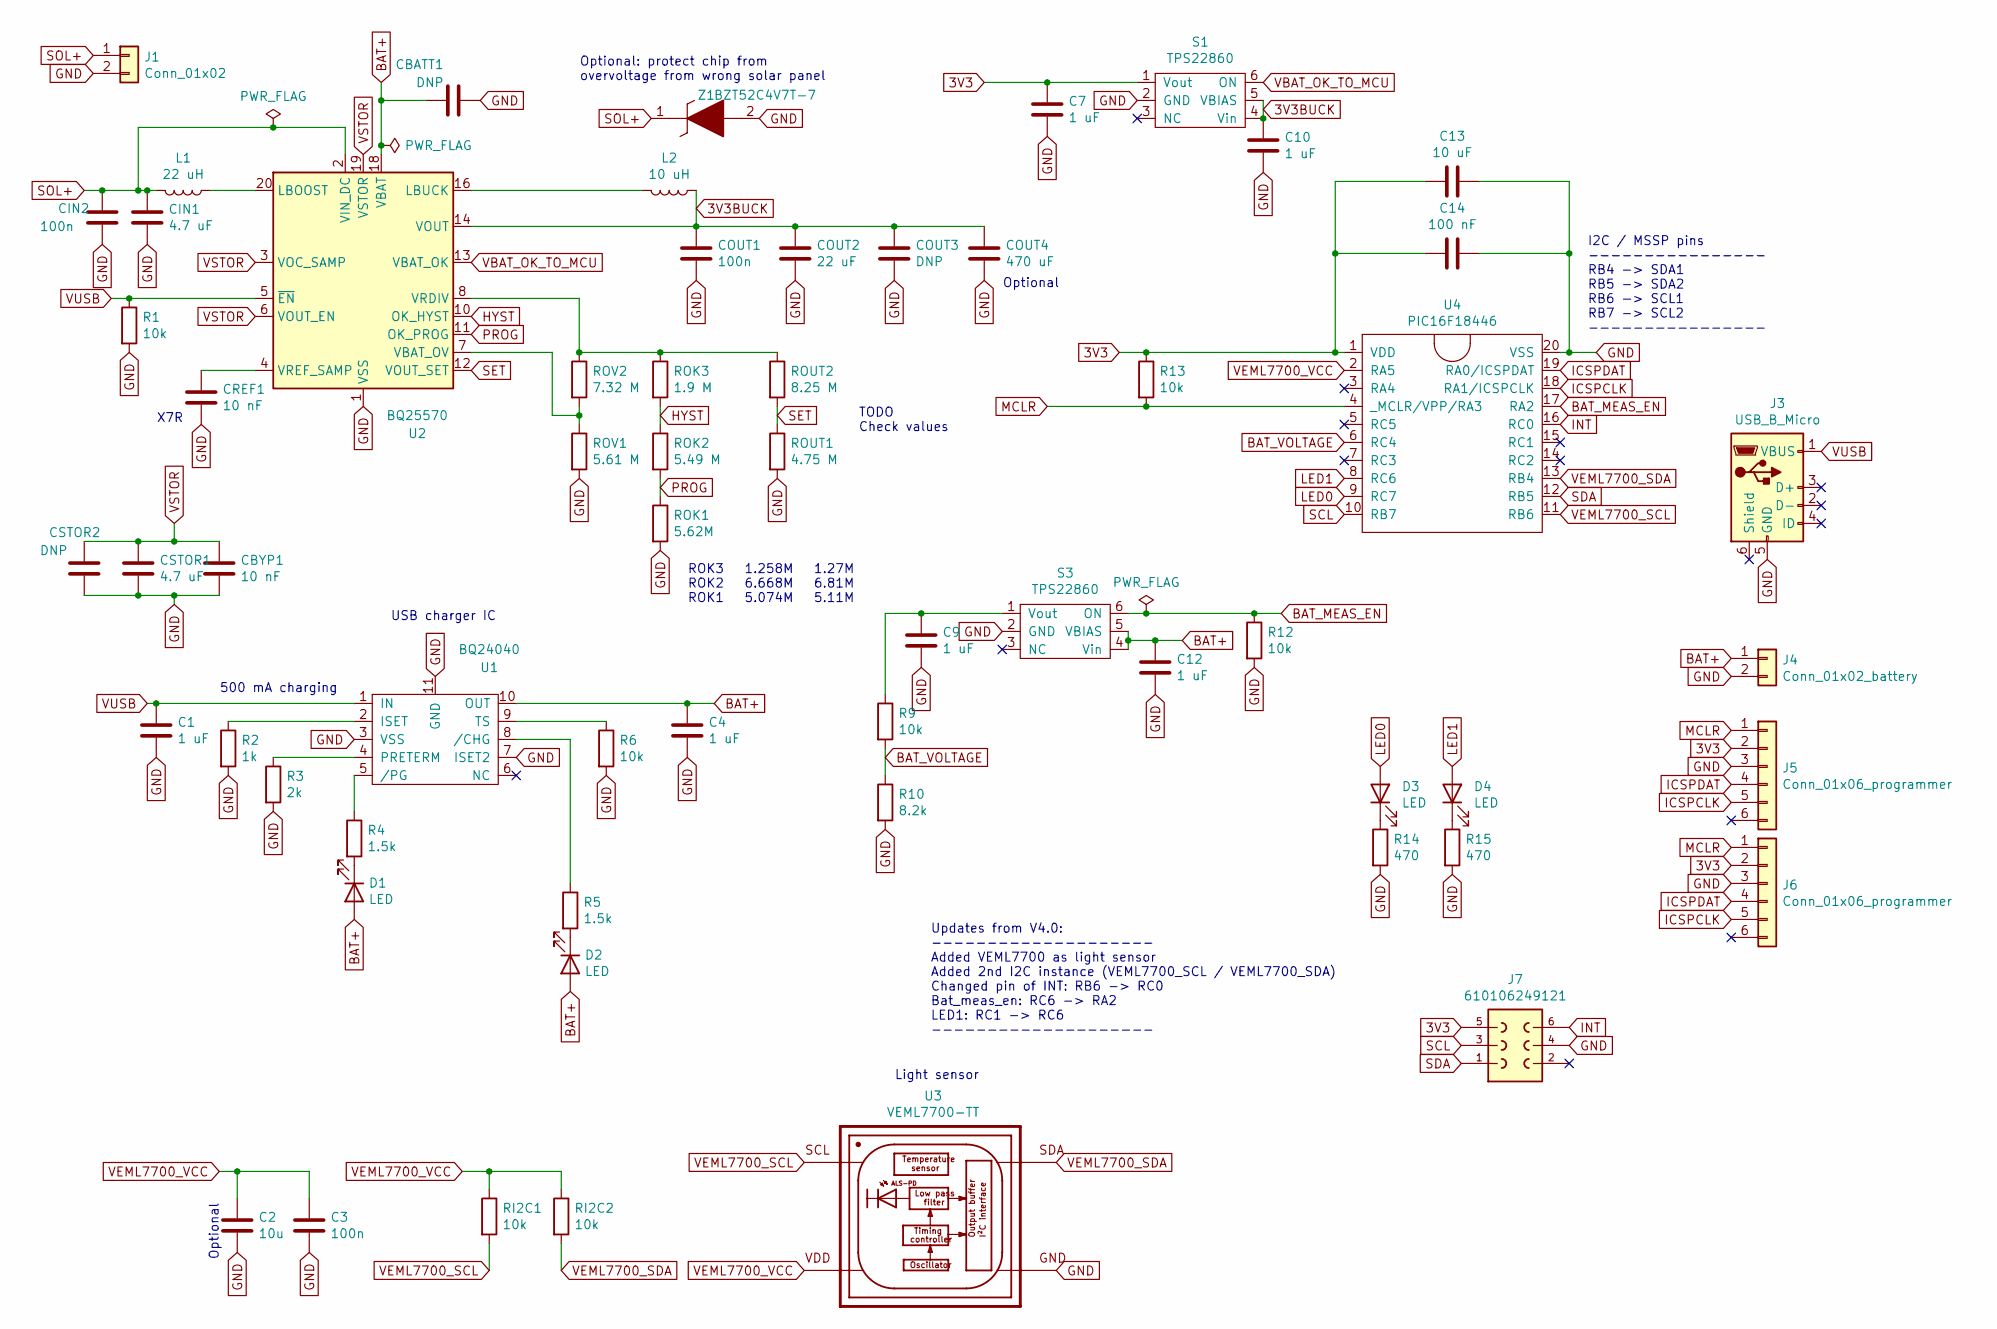
[picture p47: schematic Power_module_v1.sch]

Parts:
C1, C4, C7, C9, C10, C12: 1 uF; C_0805_2012Metric_Pad1.18x1.45mm_HandSolder
C2: 10u; C_0805_2012Metric_Pad1.15x1.40mm_HandSolder
C3: 100n; C_0805_2012Metric_Pad1.15x1.40mm_HandSolder
C13: 10 uF; C_0805_2012Metric_Pad1.18x1.45mm_HandSolder
C14: 100 nF; C_0805_2012Metric_Pad1.18x1.45mm_HandSolder
CBATT1: DNP; C_0805_2012Metric_Pad1.18x1.45mm_HandSolder
CBYP1: 10 nF; C_0805_2012Metric_Pad1.18x1.45mm_HandSolder
CIN1: 4.7 uF; C_0805_2012Metric_Pad1.18x1.45mm_HandSolder
CIN2: 100n; C_0805_2012Metric_Pad1.18x1.45mm_HandSolder
COUT1: 100n; C_0805_2012Metric_Pad1.18x1.45mm_HandSolder
COUT2: 22 uF; C_0805_2012Metric_Pad1.18x1.45mm_HandSolder
COUT3: DNP; C_0805_2012Metric_Pad1.18x1.45mm_HandSolder
COUT4: 470 uF; CP_Radial_D6.3mm_P2.50mm
CREF1: 10 nF; C_0805_2012Metric_Pad1.18x1.45mm_HandSolder
CSTOR1: 4.7 uF; C_0805_2012Metric_Pad1.18x1.45mm_HandSolder
CSTOR2: DNP; C_0805_2012Metric_Pad1.18x1.45mm_HandSolder
D1, D2, D3, D4: LED; LED_1206_3216Metric_ReverseMount_Hole1.8x2.4mm
J1: Conn_01x02; PinHeader_1x02_P2.54mm_Vertical
J3: USB_B_Micro; USB_Micro
J4: Conn_01x02_battery; PinHeader_1x02_P2.54mm_Vertical
J5, J6: Conn_01x06_programmer; PinHeader_1x06_P2.54mm_Vertical
J7: 610106249121
L1: 22 uH; Inductor_744031220_22uH
L2: 10 uH; Inductor_744029100_10uH
R1, R6, R9, R12, R13: 10k; R_0805_2012Metric_Pad1.15x1.40mm_HandSolder
R2: 1k; R_0805_2012Metric_Pad1.15x1.40mm_HandSolder
R3: 2k; R_0805_2012Metric_Pad1.15x1.40mm_HandSolder
R4, R5: 1.5k; R_0805_2012Metric_Pad1.15x1.40mm_HandSolder
R10: 8.2k; R_0805_2012Metric_Pad1.15x1.40mm_HandSolder
R14, R15: 470; R_0805_2012Metric_Pad1.15x1.40mm_HandSolder
RI2C1, RI2C2: 10k; R_0805_2012Metric_Pad1.15x1.40mm_HandSolder
ROK1: 5.62M; R_0805_2012Metric_Pad1.15x1.40mm_HandSolder
ROK2: 5.49 M; R_0805_2012Metric_Pad1.15x1.40mm_HandSolder
ROK3: 1.9 M; R_0805_2012Metric_Pad1.15x1.40mm_HandSolder
ROUT1: 4.75 M; R_0805_2012Metric_Pad1.15x1.40mm_HandSolder
ROUT2: 8.25 M; R_0805_2012Metric_Pad1.15x1.40mm_HandSolder
ROV1: 5.61 M; R_0805_2012Metric_Pad1.15x1.40mm_HandSolder
ROV2: 7.32 M; R_0805_2012Metric_Pad1.15x1.40mm_HandSolder
S1, S3: TPS22860; SOT-23-6_Handsoldering
U1: BQ24040
U2: BQ25570; QFN-20-1EP_3.5x3.5mm_P0.5mm_EP2x2mm
U3: VEML7700-TT; XDCR_VEML7700-TT; PARTREV 1.3
U4: PIC16F18446; PIC16F18446SSOP20PIN
Z1: BZT52C4V7T-7; D_SOD-523; Mouser Part Number 621-BZT52C4V7T-7

Connections:
3V3: C7.1, C13.2, C14.2, J5.2, J6.2, J7.5, R13.1, S1.1 (Vout), U4.1 (VDD)
3V3BUCK: C10.1, COUT1.1, COUT2.1, COUT3.1, COUT4.1, L2.1, S1.4 (Vin), S1.5 (VBIAS), U2.14 (VOUT)
BAT+: C4.1, C12.1, CBATT1.1, D1.2 (A), D2.2 (A), J4.1, S3.4 (Vin), S3.5 (VBIAS), U1.10 (OUT), U2.18 (VBAT)
BAT_MEAS_EN: R12.1, S3.6 (ON), U4.17 (RA2)
BAT_VOLTAGE: R9.2, R10.1, U4.6 (RC4)
GND: C1.2, C2.2, C3.2, C4.2, C7.2, C9.2, C10.2, C12.2, C13.1, C14.1, CBATT1.2, CBYP1.2, CIN1.2, CIN2.2, COUT1.2, COUT2.2, COUT3.2, COUT4.2, CREF1.2, CSTOR1.2, CSTOR2.2, J1.2, J3.5 (GND), J4.2, J5.3, J6.3, J7.4, R1.2, R2.2, R3.2, R6.2, R10.2, R12.2, R14.2, R15.2, ROK1.2, ROUT1.2, ROV1.2, S1.2 (GND), S3.2 (GND), U1.3 (VSS), U1.7 (ISET2), U1.11 (GND), U2.1 (VSS), U2.9 (VSS), U2.15 (VSS), U2.17 (VSS), U2.21 (VSS), U3.3, U4.20 (VSS), Z1.2
HYST: ROK2.1, ROK3.2, U2.10 (OK_HYST)
ICSPCLK: J5.5, J6.5, U4.18 (RA1/ICSPCLK)
ICSPDAT: J5.4, J6.4, U4.19 (RA0/ICSPDAT)
INT: J7.6, U4.16 (RC0)
LED0: D3.2 (A), U4.9 (RC7)
LED1: D4.2 (A), U4.8 (RC6)
MCLR: J5.1, J6.1, R13.2, U4.4 (_MCLR/VPP/RA3)
unnamed: C9.1, R9.1, S3.1 (Vout)
unnamed: CREF1.1, U2.4 (VREF_SAMP)
unnamed: D1.1 (K), R4.2
unnamed: D2.1 (K), R5.2
unnamed: D3.1 (K), R14.1
unnamed: D4.1 (K), R15.1
unnamed: L1.1, U2.20 (LBOOST)
unnamed: L2.2, U2.16 (LBUCK)
unnamed: R2.1, U1.2 (ISET)
unnamed: R3.1, U1.4 (PRETERM)
unnamed: R4.1, U1.5 (/PG)
unnamed: R5.1, U1.8 (/CHG)
unnamed: R6.1, U1.9 (TS)
unnamed: ROK3.1, ROUT2.1, ROV2.1, U2.8 (VRDIV)
unnamed: ROV1.1, ROV2.2, U2.7 (VBAT_OV)
PROG: ROK1.1, ROK2.2, U2.11 (OK_PROG)
SCL: J7.3, U4.10 (RB7)
SDA: J7.1, U4.12 (RB5)
SET: ROUT1.1, ROUT2.2, U2.12 (VOUT_SET)
SOL+: CIN1.1, CIN2.1, J1.1, L1.2, U2.2 (VIN_DC), Z1.1
VBAT_OK_TO_MCU: S1.6 (ON), U2.13 (VBAT_OK)
VEML7700_SCL: RI2C1.2, U3.1, U4.11 (RB6)
VEML7700_SDA: RI2C2.2, U3.4, U4.13 (RB4)
VEML7700_VCC: C2.1, C3.1, RI2C1.1, RI2C2.1, U3.2, U4.2 (RA5)
VSTOR: CBYP1.1, CSTOR1.1, CSTOR2.1, U2.3 (VOC_SAMP), U2.6 (VOUT_EN), U2.19 (VSTOR)
VUSB: C1.1, J3.1 (VBUS), R1.1, U1.1 (IN), U2.5 (~EN)

Notes on the sheet:
USB charger IC
X7R
TODO Check values
ROK3 1.258M 1.27M ROK2 6.668M 6.81M ROK1 5.074M 5.11M
500 mA charging
Light sensor
Optional
Optional: protect chip from overvoltage from wrong solar panel
Optional
I2C / MSSP pins ---------------- RB4 -> SDA1 RB5 -> SDA2 RB6 -> SCL1 RB7 -> SCL2 ----------------
Updates from V4.0: -------------------- Added VEML7700 as light sensor Added 2nd I2C instance (VEML7700_SCL / VEML7700_SDA) Changed pin of INT: RB6 -> RC0 Bat_meas_en: RC6 -> RA2 LED1: RC1 -> RC6 --------------------

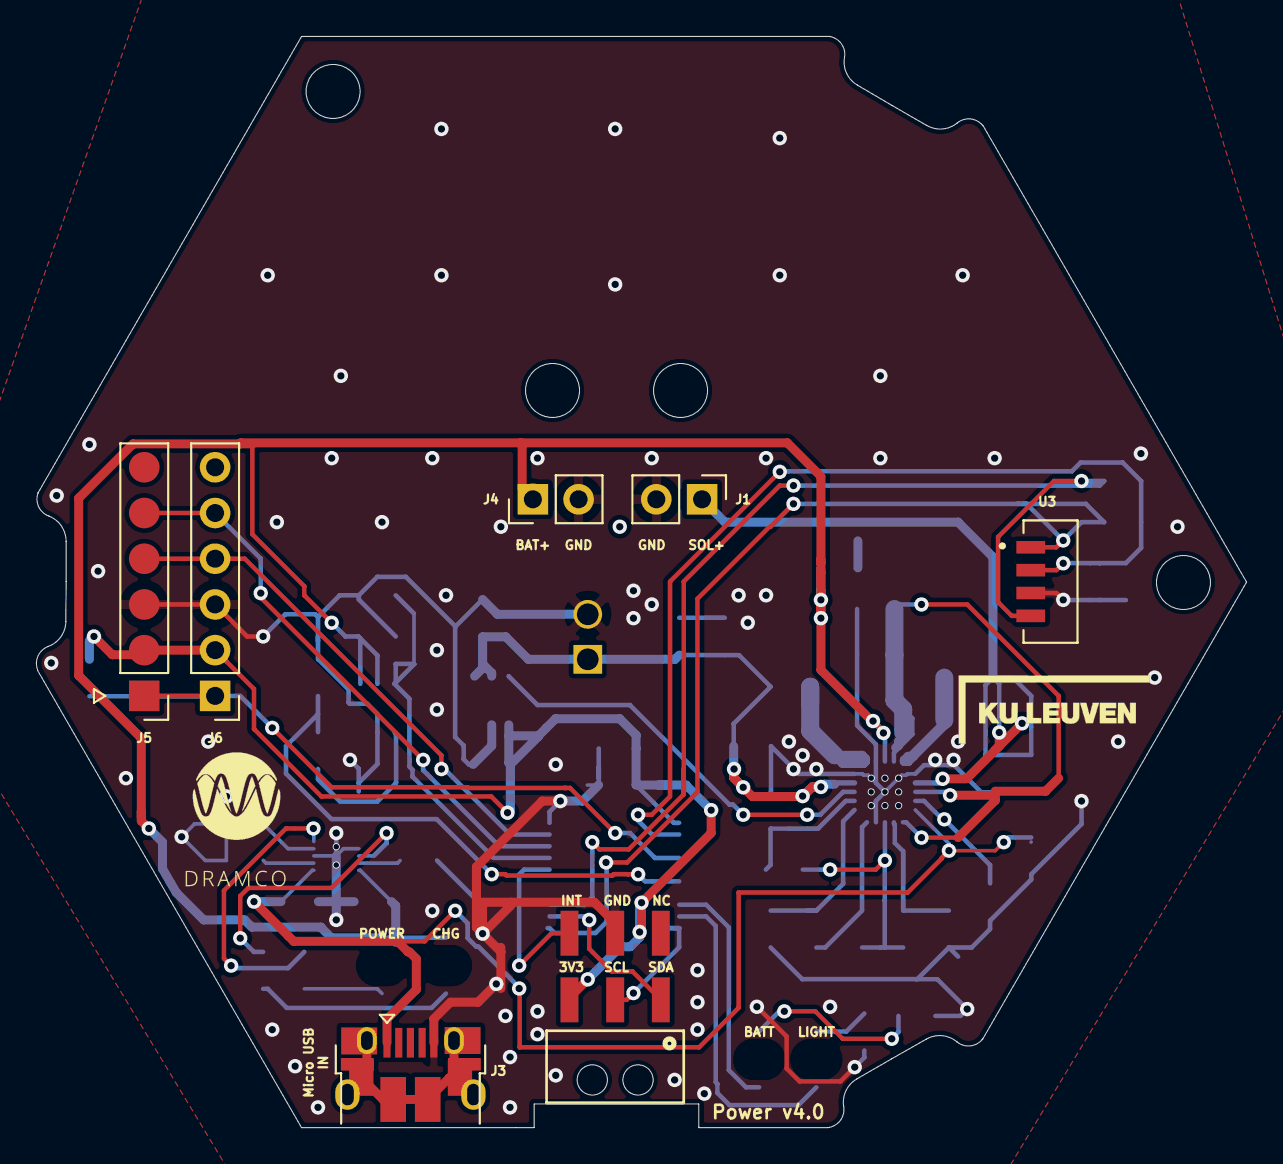
[picture p48: board Power_module_v1.kicad_pcb from above]

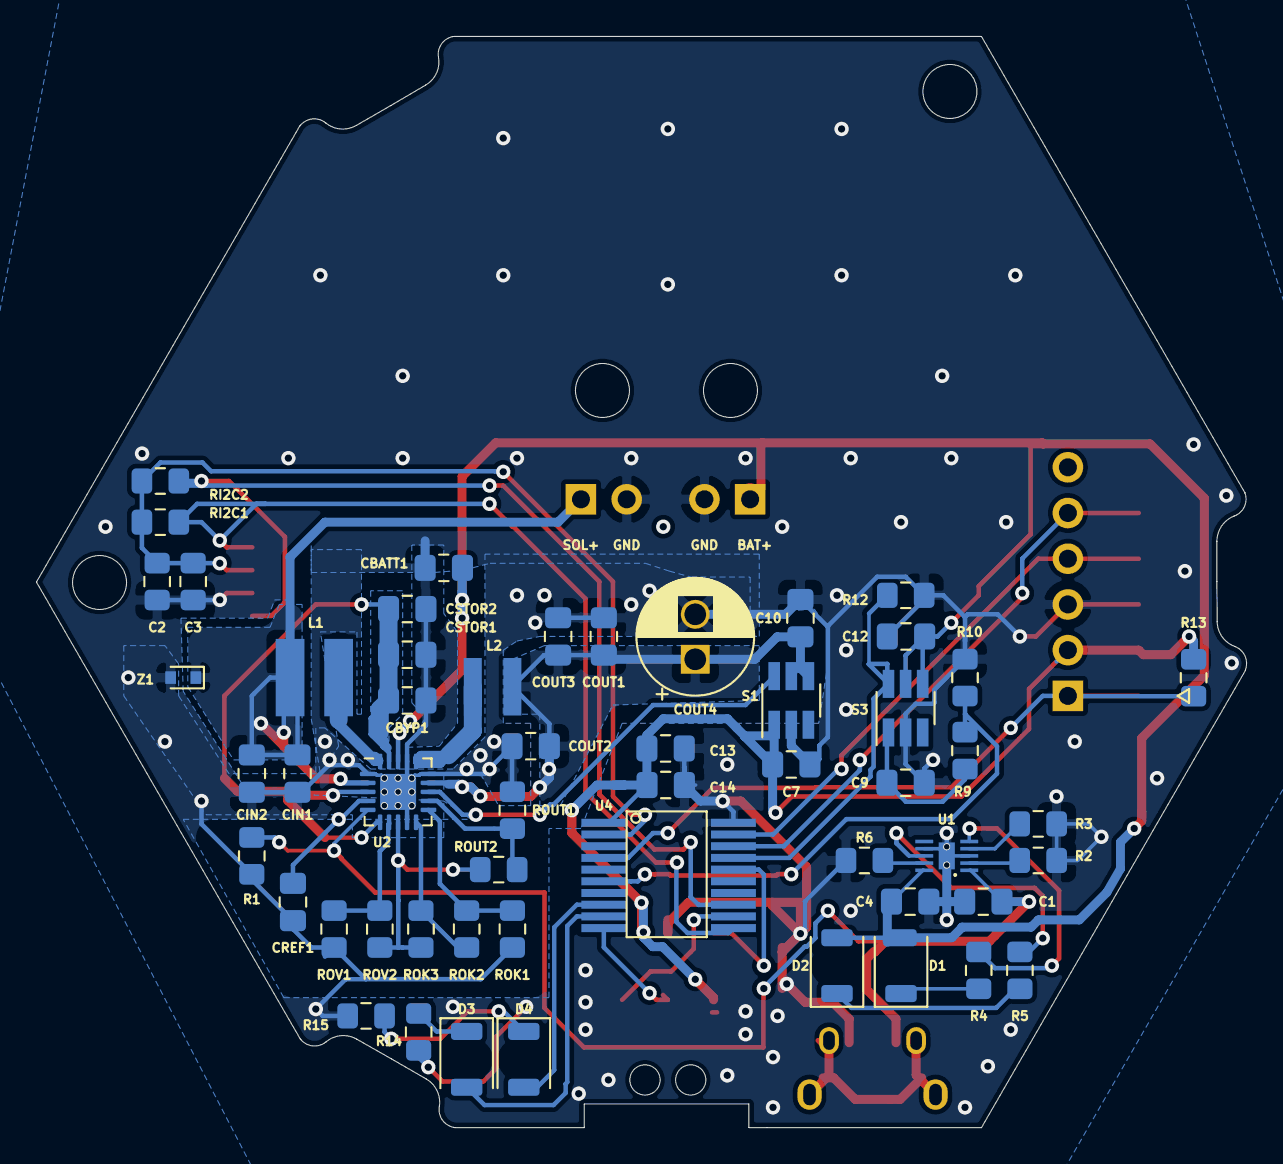
[picture p49: board Power_module_v1.kicad_pcb from below]

Board: 2 copper layers, 67.2 x 60.6 mm, 61 parts (54 on the bottom side), 39 nets.
