dramco-iwast/sensors/hardware/Air_Quality/air_quality_v2/kicadproject/BME680.kicad_pcb

## KiCad design hardware/Air_Quality/air_quality_v2/kicadproject/BME680.kicad_pcb (2021-05-21, an earlier design)

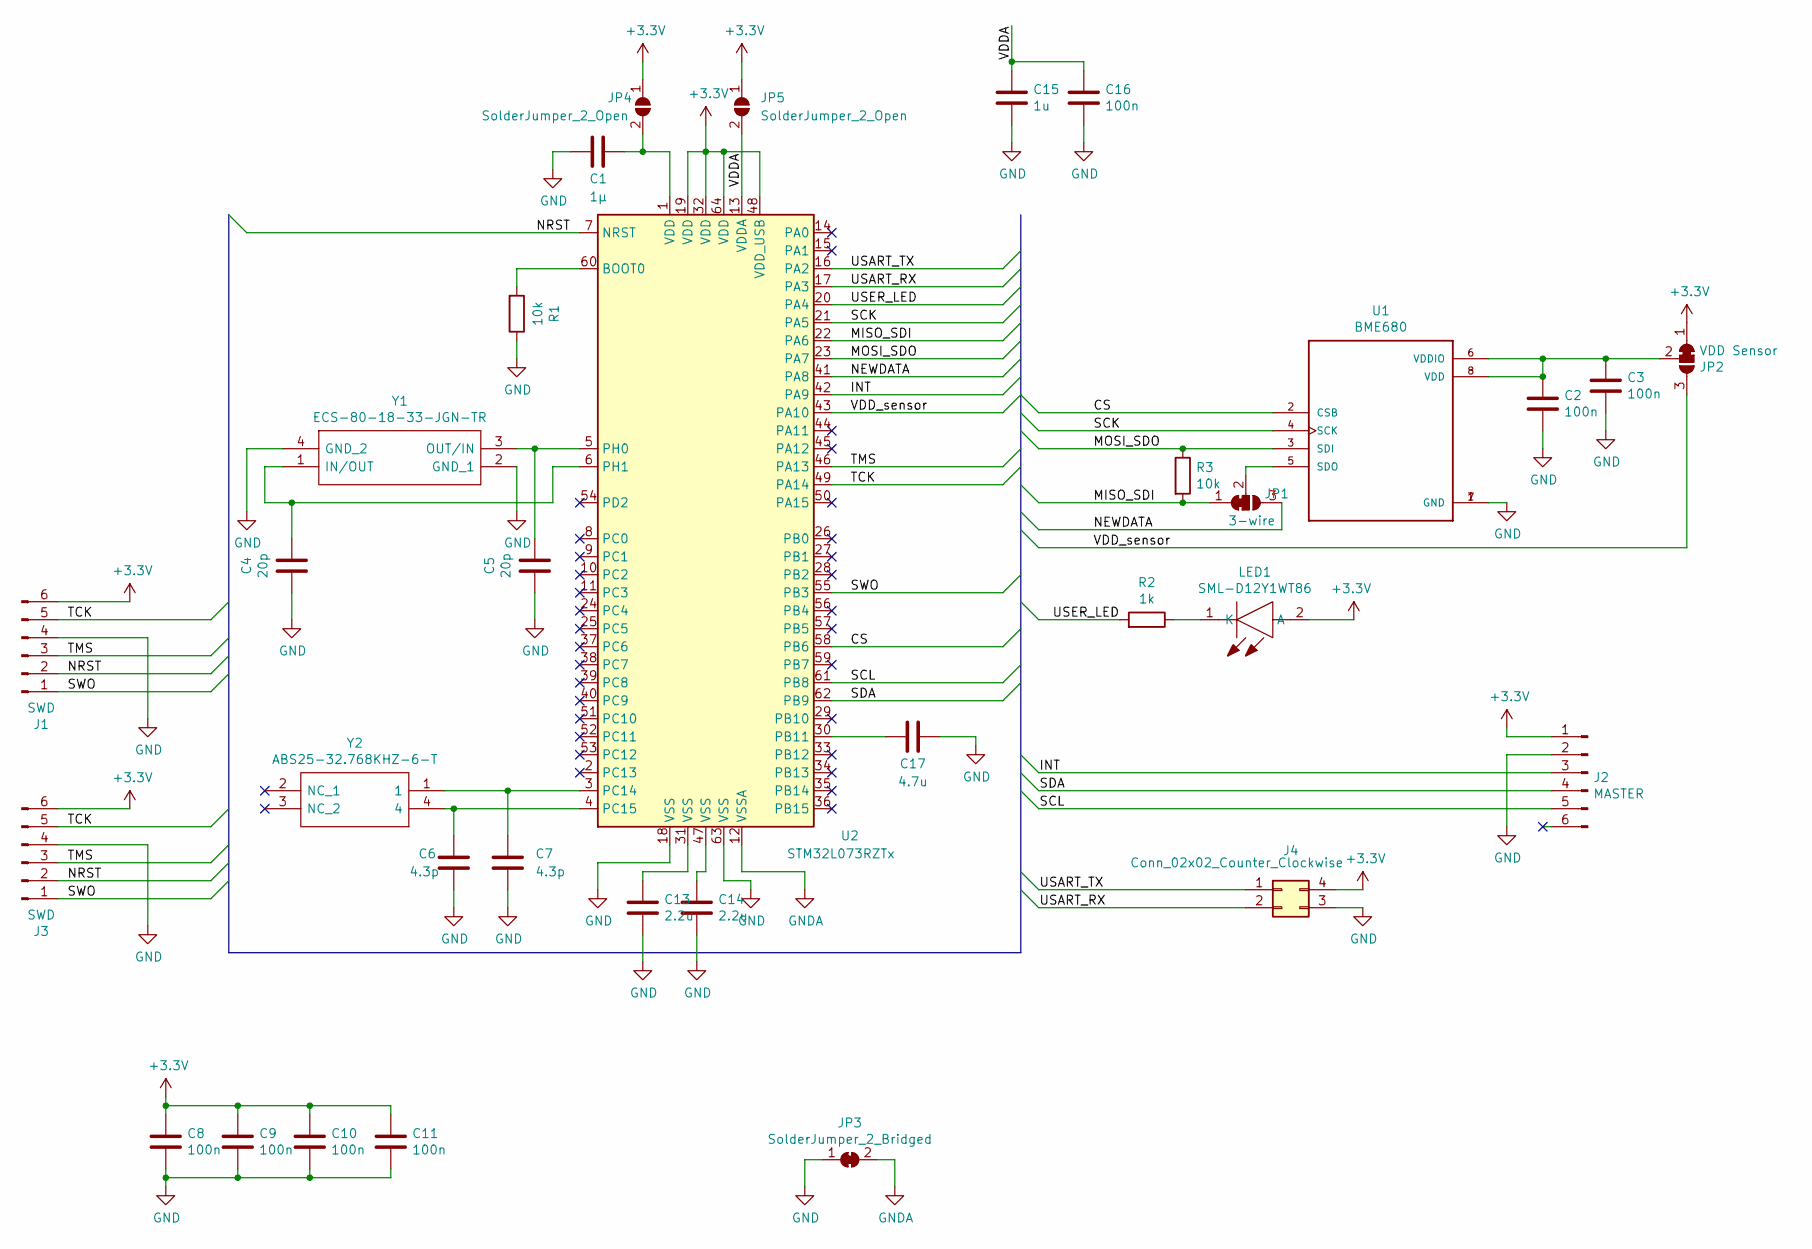
[picture p50: schematic BME680.sch, IWAST - BME680]

Parts:
C1: 1µ; C_0805_2012Metric_Pad1.15x1.40mm_HandSolder
C2, C3, C8, C9, C10, C11, C16: 100n; C_0805_2012Metric_Pad1.15x1.40mm_HandSolder
C4, C5: 20p; C_0805_2012Metric_Pad1.15x1.40mm_HandSolder
C6, C7: 4.3p; C_0805_2012Metric_Pad1.15x1.40mm_HandSolder
C13, C14: 2.2u; C_0805_2012Metric_Pad1.15x1.40mm_HandSolder
C15: 1u; C_0805_2012Metric_Pad1.15x1.40mm_HandSolder
C17: 4.7u; C_0805_2012Metric_Pad1.15x1.40mm_HandSolder
J1: SWD; PinHeader_1x06_P2.54mm_Vertical
J2: MASTER; ConnectorHorizontalPcb
J3: SWD; PinHeader_1x06_P2.54mm_Vertical_SMD
J4: Conn_02x02_Counter_Clockwise; PinHeader_2x02_P2.54mm_Vertical_SMD
JP1: 3-wire; SolderJumper-3_P1.3mm_Bridged12_RoundedPad1.0x1.5mm
JP2: VDD Sensor; SolderJumper-3_P1.3mm_Bridged12_RoundedPad1.0x1.5mm
JP3: SolderJumper_2_Bridged; SolderJumper-2_P1.3mm_Bridged_RoundedPad1.0x1.5mm
JP4, JP5: SolderJumper_2_Open; SolderJumper-2_P1.3mm_Open_RoundedPad1.0x1.5mm
LED1: SML-D12Y1WT86; LED_0805_2012Metric_Pad1.15x1.40mm_HandSolder; Mouser Part Number 755-SML-D12Y1WT86
R1, R3: 10k; R_0805_2012Metric_Pad1.15x1.40mm_HandSolder
R2: 1k; R_0805_2012Metric_Pad1.15x1.40mm_HandSolder
U1: BME680; PSON80P300X300X100-8N
U2: STM32L073RZTx; LQFP-64_10x10mm_P0.5mm
Y1: ECS-80-18-33-JGN-TR; ECS801833JGNTR_kristal; Mouser Part Number 520-80-18-33-JGN-TR
Y2: ABS25-32.768KHZ-6-T; ABS25; Mouser Part Number 815-ABS25-32.768K6-T

Connections:
+3V3: C8.1, C9.1, C10.1, C11.1, J1.6, J2.1, J3.6, J4.4, JP2.1 (A), JP4.1 (A), JP5.1 (A), LED1.2 (A), U2.19 (VDD), U2.32 (VDD), U2.48 (VDD_USB), U2.64 (VDD)
/CS: U1.2 (CSB), U2.58 (PB6)
/INT: J2.3, U2.42 (PA9)
/MISO_SDI: JP1.1 (A), R3.2, U2.22 (PA6)
/MOSI_SDO: R3.1, U1.3 (SDI), U2.23 (PA7)
/NEWDATA: JP1.3 (B), U2.41 (PA8)
/NRST: J1.2, J3.2, U2.7 (NRST)
/SCK: U1.4 (SCK), U2.21 (PA5)
/SCL: J2.5, U2.61 (PB8)
/SDA: J2.4, U2.62 (PB9)
/SWO: J1.1, J3.1, U2.55 (PB3)
/TCK: J1.5, J3.5, U2.49 (PA14)
/TMS: J1.3, J3.3, U2.46 (PA13)
/USART_RX: J4.2, U2.17 (PA3)
/USART_TX: J4.1, U2.16 (PA2)
/USER_LED: R2.2, U2.20 (PA4)
/VDDA: C15.1, C16.1, JP5.2 (B), U2.13 (VDDA)
/VDD_sensor: JP2.3 (B), U2.43 (PA10)
GND: C1.2, C2.2, C3.2, C4.1, C5.1, C6.2, C7.2, C8.2, C9.2, C10.2, C11.2, C13.2, C14.2, C15.2, C16.2, C17.1, J1.4, J2.2, J3.4, J4.3, JP3.1 (A), R1.1, U1.1 (GND), U1.7 (GND), U2.18 (VSS), U2.63 (VSS), Y1.2 (GND_1), Y1.4 (GND_2)
GNDA: JP3.2 (B), U2.12 (VSSA)
unnamed: C1.1, JP4.2 (B), U2.1 (VDD)
unnamed: C2.1, C3.1, JP2.2 (C), U1.6 (VDDIO), U1.8 (VDD)
unnamed: C4.2, U2.6 (PH1), Y1.1 (IN/OUT)
unnamed: C5.2, U2.5 (PH0), Y1.3 (OUT/IN)
unnamed: C6.1, U2.4 (PC15), Y2.4
unnamed: C7.1, U2.3 (PC14), Y2.1
unnamed: C13.1, U2.31 (VSS)
unnamed: C14.1, U2.47 (VSS)
unnamed: C17.2, U2.30 (PB11)
unnamed: JP1.2 (C), U1.5 (SDO)
unnamed: LED1.1 (K), R2.1
unnamed: R1.2, U2.60 (BOOT0)

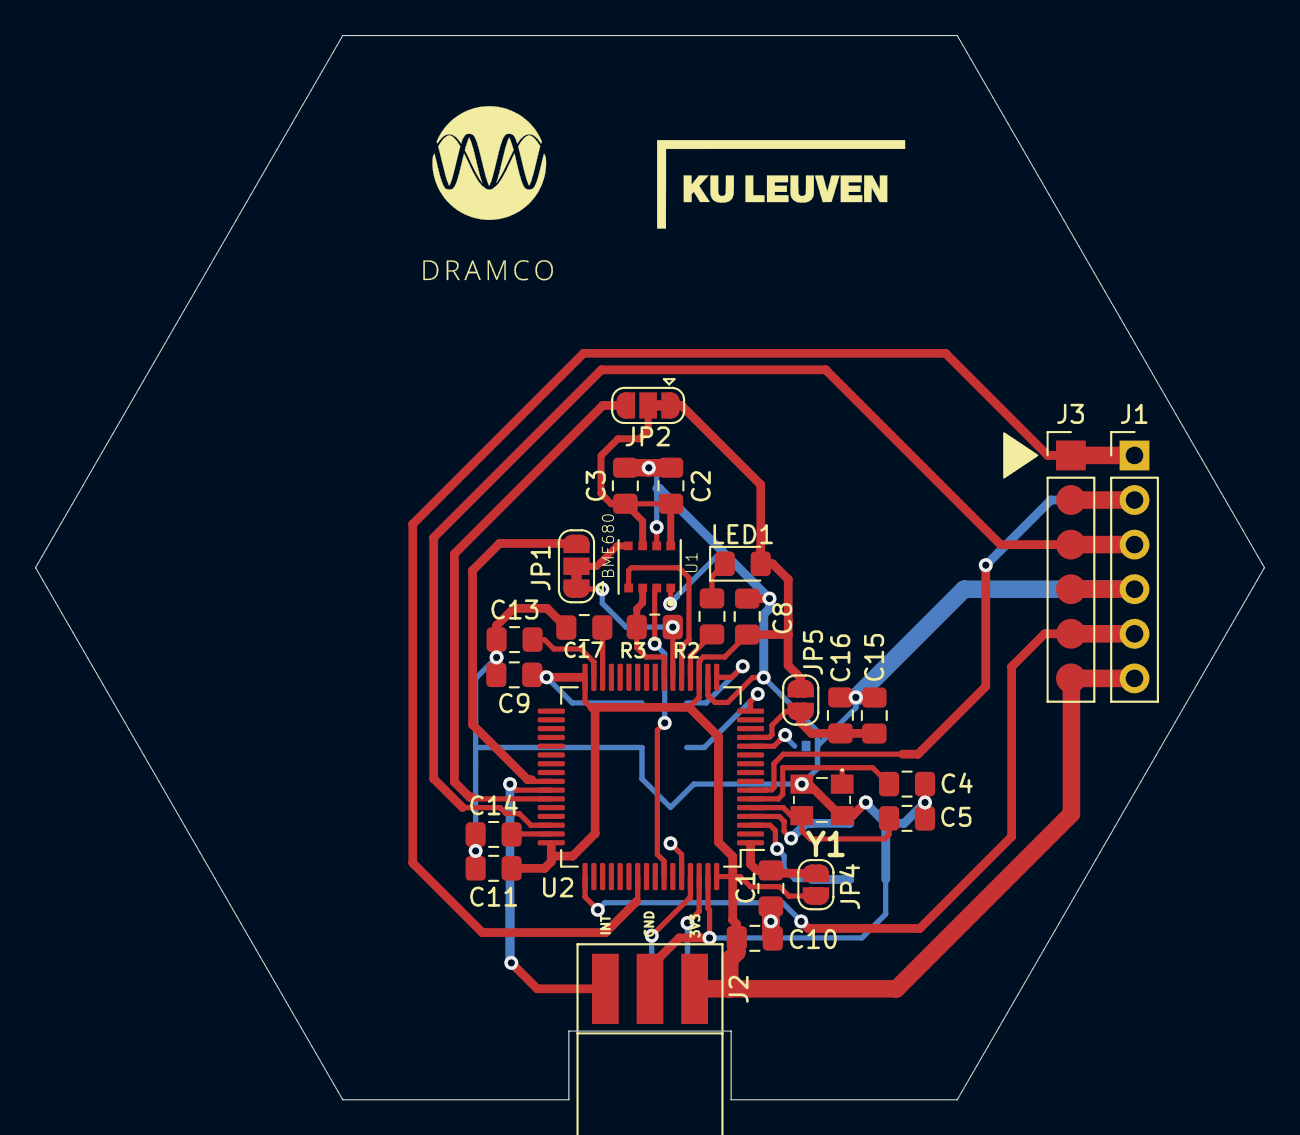
[picture p51: board hardware/Air_Quality/air_quality_v2/kicadproject/BME680.kicad_pcb from above]

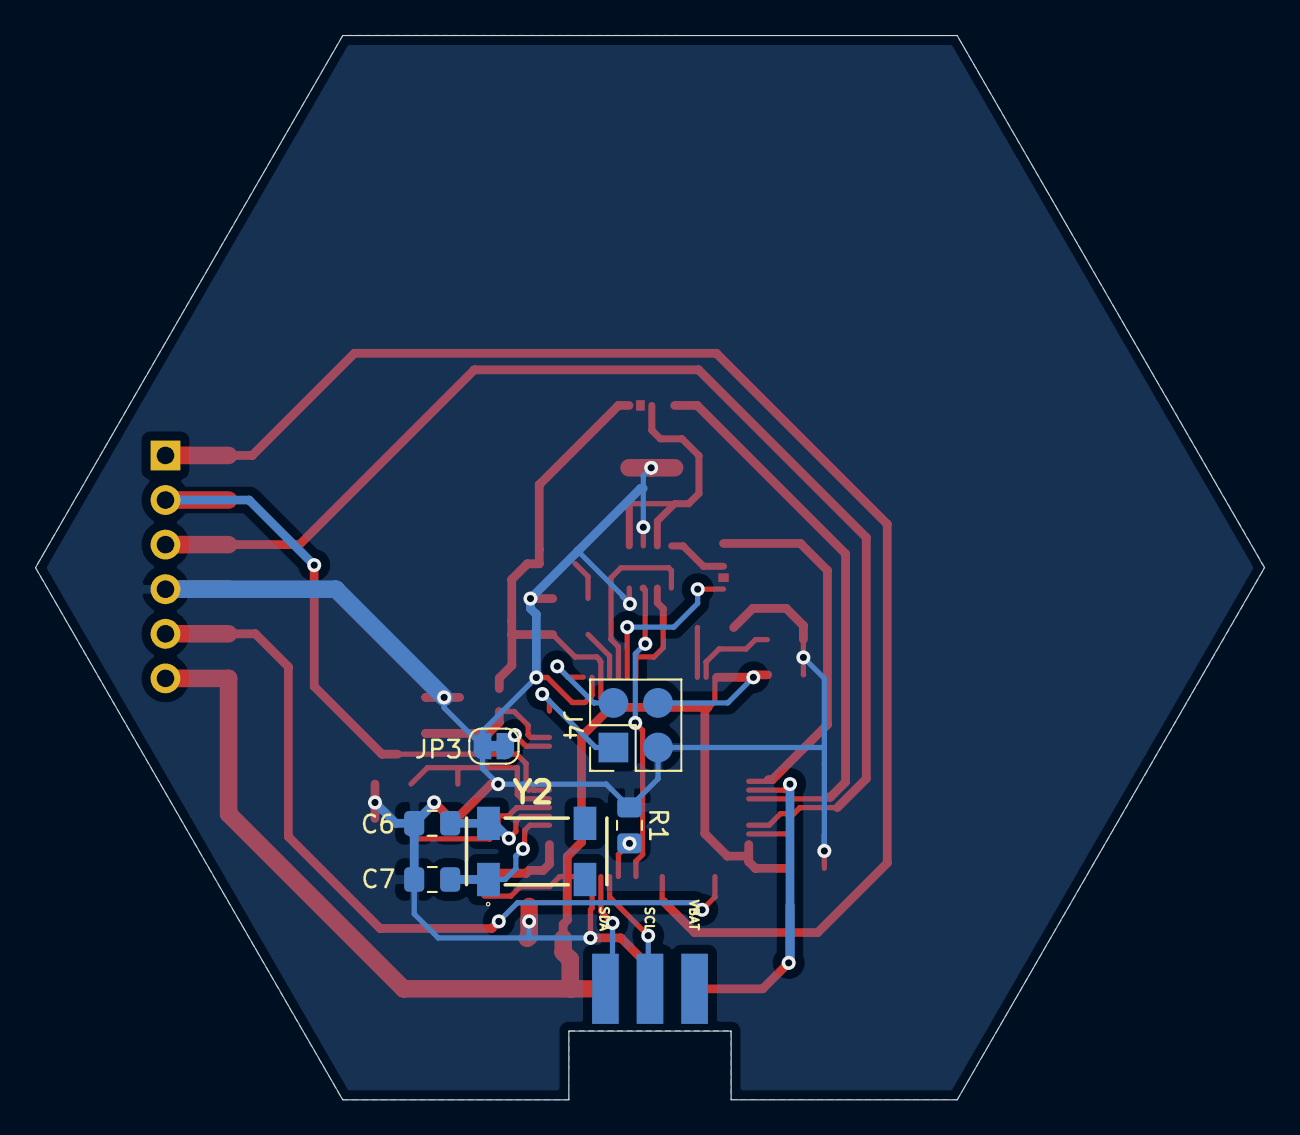
[picture p52: board hardware/Air_Quality/air_quality_v2/kicadproject/BME680.kicad_pcb from below]

Board: 2 copper layers, 70.0 x 60.6 mm, 33 parts (6 on the bottom side), 32 nets.
