dramco-iwast/sensors/hardware/Air_Quality/air_quality_v1/kicadproject/IWAST_BME680_v2/BME680.kicad_pcb

## KiCad design hardware/Air_Quality/air_quality_v1/kicadproject/IWAST_BME680_v2/BME680.kicad_pcb (2020-03-09, an earlier design)

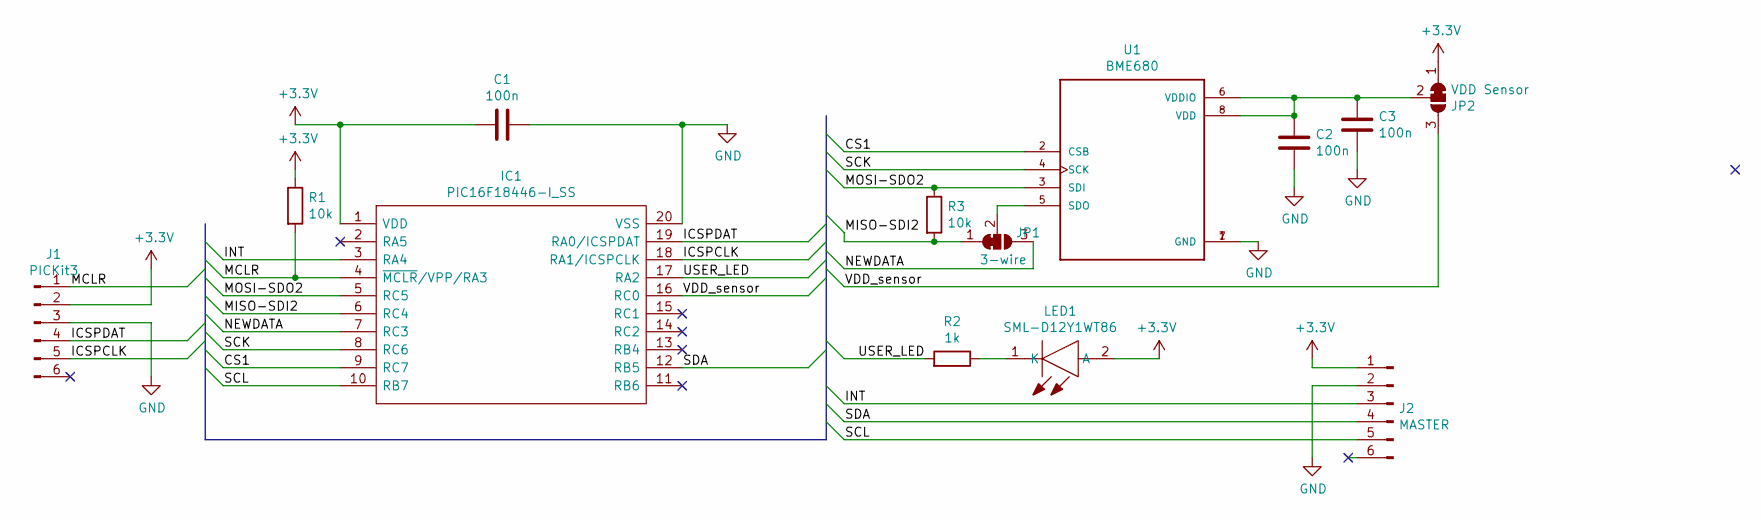
[picture p53: schematic BME680.sch, IWAST - BME680]

Parts:
C1, C2, C3: 100n; C_0805_2012Metric_Pad1.15x1.40mm_HandSolder
IC1: PIC16F18446-I_SS; SOP65P780X200-20N; Mouser Part Number 579-PIC16F18446-I/SS
J1: PICKit3; PinHeader_1x06_P2.54mm_Vertical
J2: MASTER; ConnectorHorizontalPcb
JP1: 3-wire; SolderJumper-3_P1.3mm_Bridged12_RoundedPad1.0x1.5mm
JP2: VDD Sensor; SolderJumper-3_P1.3mm_Bridged12_RoundedPad1.0x1.5mm
LED1: SML-D12Y1WT86; LED_0805_2012Metric_Pad1.15x1.40mm_HandSolder; Mouser Part Number 755-SML-D12Y1WT86
R1, R3: 10k; R_0805_2012Metric_Pad1.15x1.40mm_HandSolder
R2: 1k; R_0805_2012Metric_Pad1.15x1.40mm_HandSolder
U1: BME680; PSON80P300X300X100-8N

Connections:
+3V3: C1.1, IC1.1 (VDD), J1.2, J2.1, JP2.1 (A), LED1.2 (A), R1.1
/CS1: IC1.9 (RC7), U1.2 (CSB)
/ICSPCLK: IC1.18 (RA1/ICSPCLK), J1.5
/ICSPDAT: IC1.19 (RA0/ICSPDAT), J1.4
/INT: IC1.3 (RA4), J2.3
/MCLR: IC1.4 (~MCLR~/VPP/RA3), J1.1, R1.2
/MISO-SDI2: IC1.6 (RC4), JP1.1 (A), R3.2
/MOSI-SDO2: IC1.5 (RC5), R3.1, U1.3 (SDI)
/NEWDATA: IC1.7 (RC3), JP1.3 (B)
/SCK: IC1.8 (RC6), U1.4 (SCK)
/SCL: IC1.10 (RB7), J2.5
/SDA: IC1.12 (RB5), J2.4
/USER_LED: IC1.17 (RA2), R2.2
/VDD_sensor: IC1.16 (RC0), JP2.3 (B)
GND: C1.2, C2.2, C3.2, IC1.20 (VSS), J1.3, J2.2, U1.1 (GND), U1.7 (GND)
unnamed: C2.1, C3.1, JP2.2 (C), U1.6 (VDDIO), U1.8 (VDD)
unnamed: JP1.2 (C), U1.5 (SDO)
unnamed: LED1.1 (K), R2.1

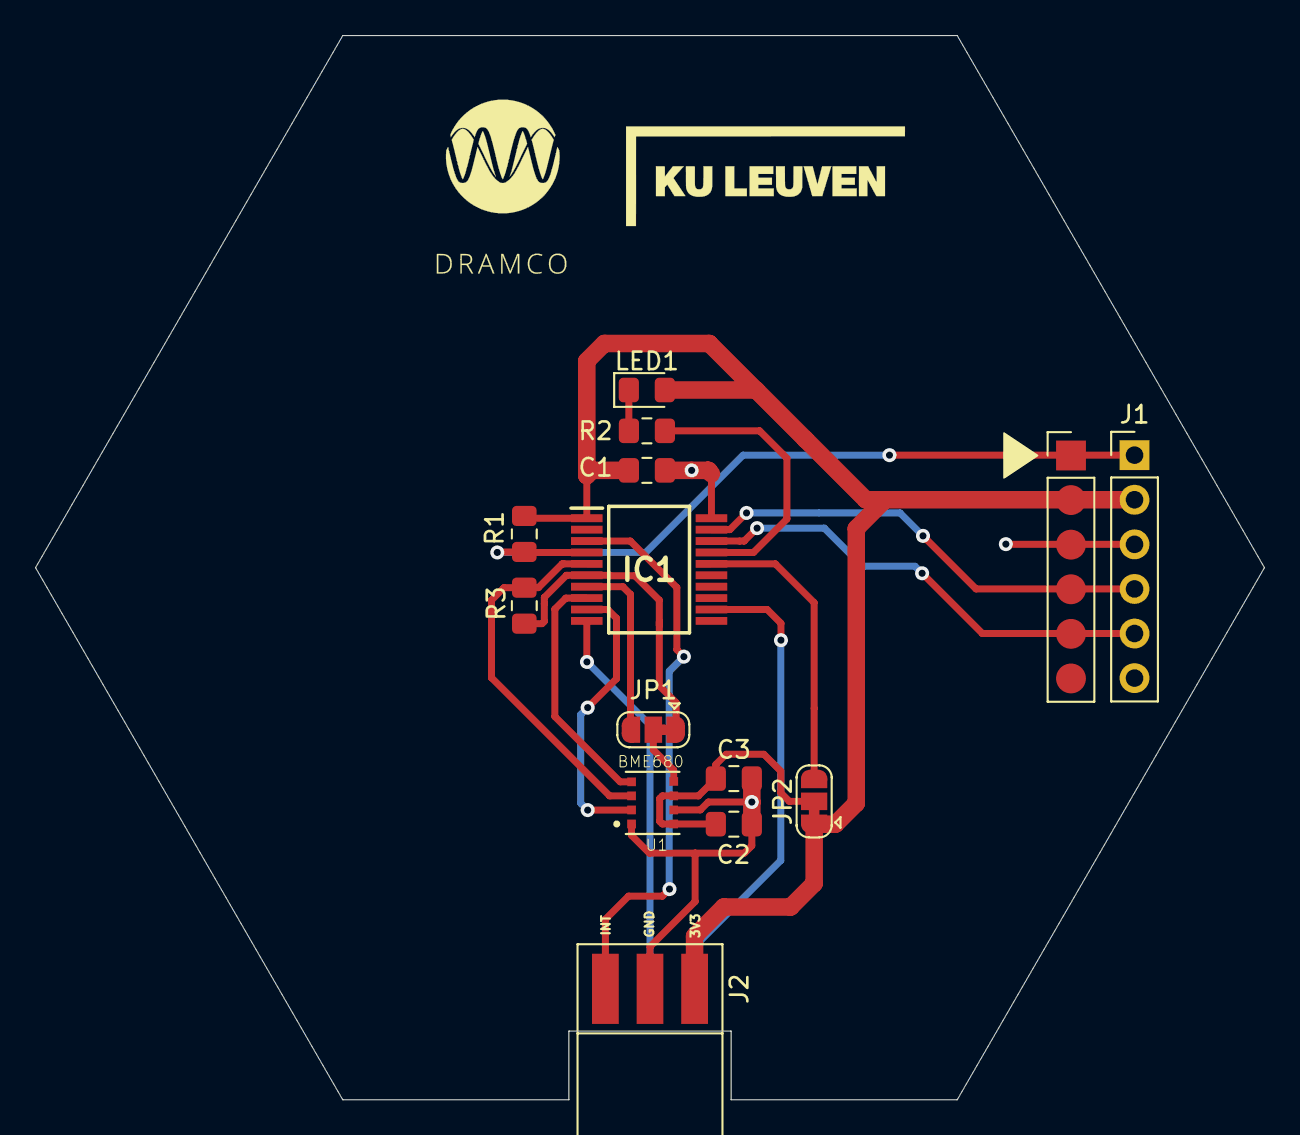
[picture p54: board hardware/Air_Quality/air_quality_v1/kicadproject/IWAST_BME680_v2/BME6… from above]

Board: 2 copper layers, 70.0 x 60.6 mm, 13 parts (0 on the bottom side), 18 nets.
