dramco-iwast/sensors/hardware/Power/Power_v1/Power_module_v0.kicad_pcb

## KiCad design hardware/Power/Power_v1/Power_module_v0.kicad_pcb (2020-11-27, an earlier design)

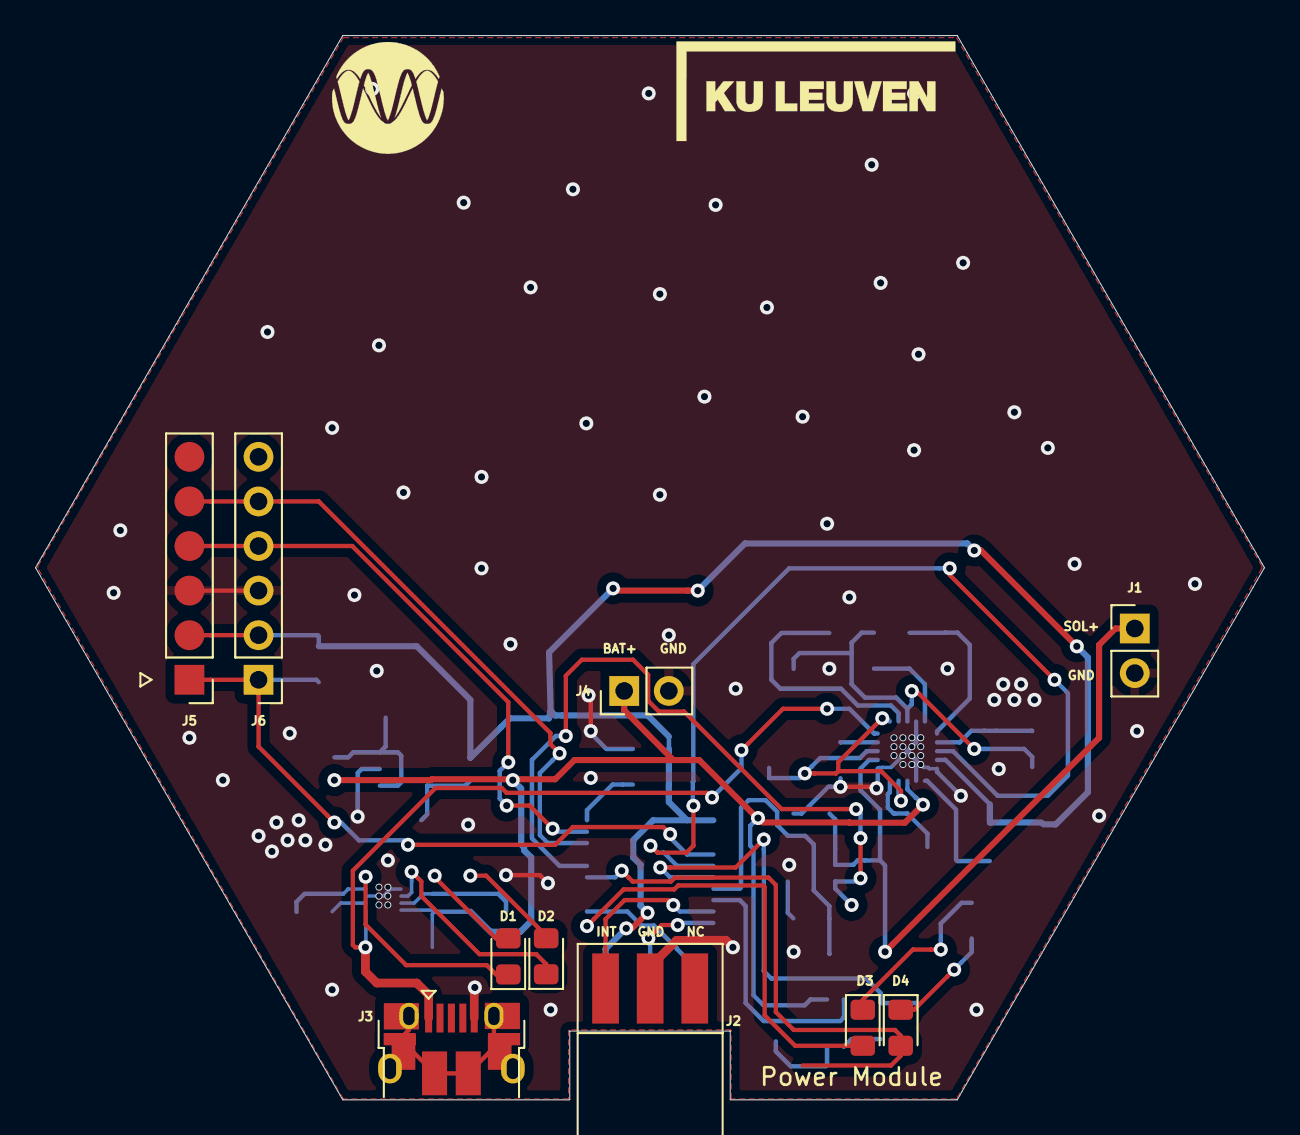
[picture p55: board Power_module_v0.kicad_pcb from above]

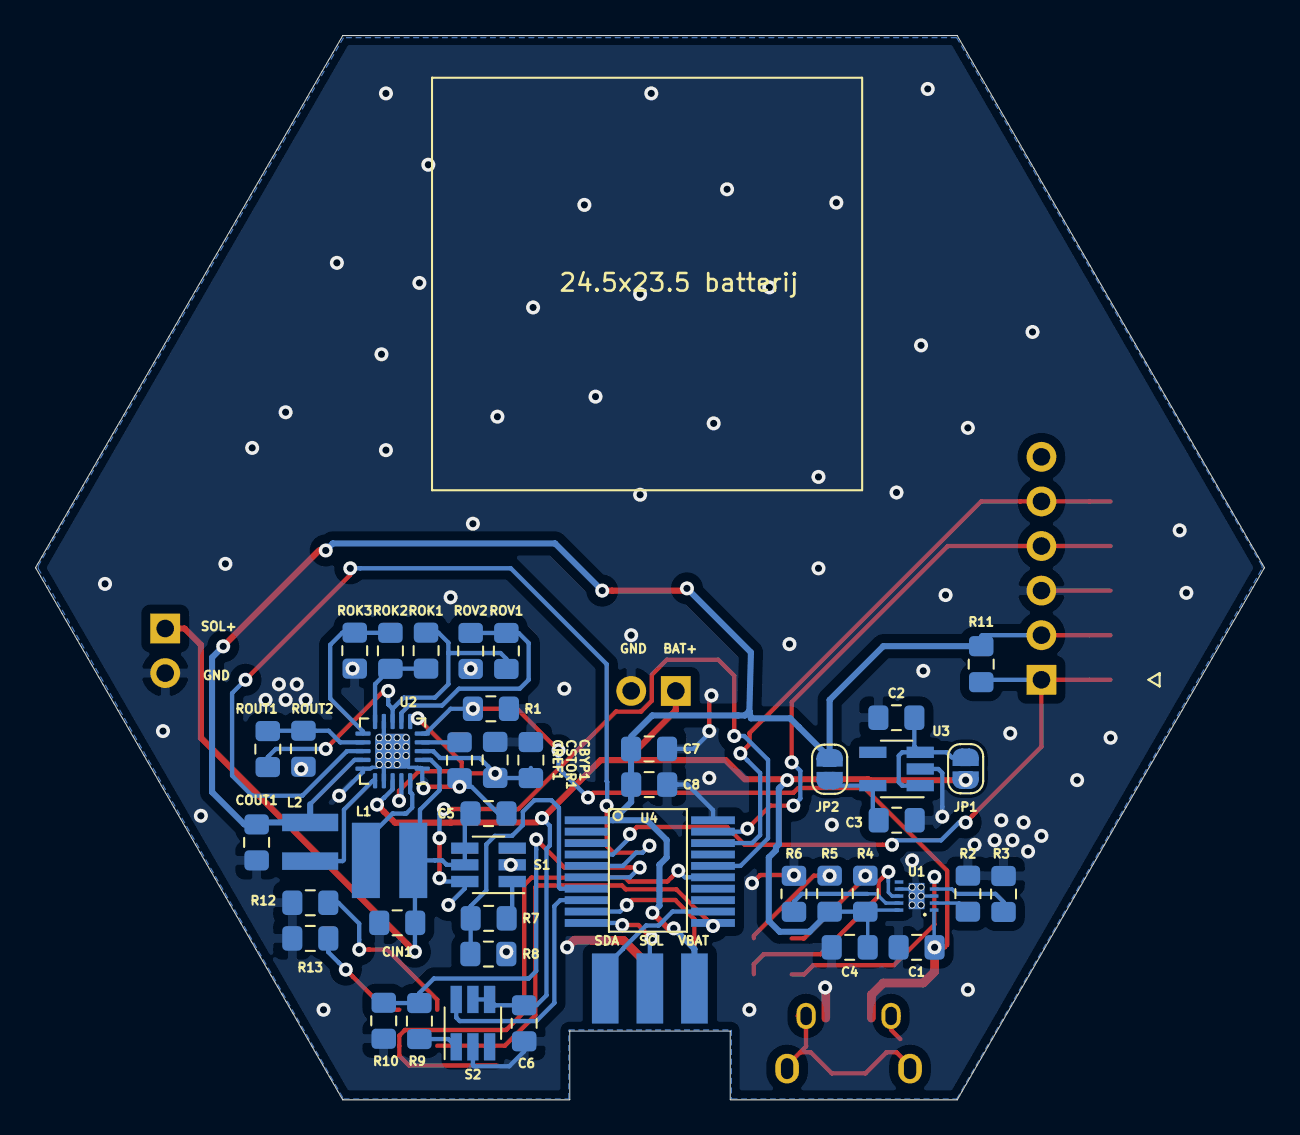
[picture p56: board Power_module_v0.kicad_pcb from below]

Board: 2 copper layers, 70.0 x 60.6 mm, 53 parts (43 on the bottom side), 40 nets.

Parts:
C1, C2, C3, C4, C5, C6: 1 uF; C_0805_2012Metric_Pad1.15x1.40mm_HandSolder
C7: 10 uF; C_0805_2012Metric_Pad1.15x1.40mm_HandSolder
C8: 100 nF; C_0805_2012Metric_Pad1.15x1.40mm_HandSolder
CBYP1: 10 nF; C_0805_2012Metric_Pad1.15x1.40mm_HandSolder
CIN1: 4.7 uF; C_0805_2012Metric_Pad1.15x1.40mm_HandSolder
COUT1: 22 uF; C_0805_2012Metric_Pad1.15x1.40mm_HandSolder
CREF1: 10 nF; C_0805_2012Metric_Pad1.15x1.40mm_HandSolder
CSTOR1: 4.7 uF; C_0805_2012Metric_Pad1.15x1.40mm_HandSolder
D1, D2, D3, D4: LED; LED_0805_2012Metric_Pad1.15x1.40mm_HandSolder
J1: Conn_01x02; PinHeader_1x02_P2.54mm_Vertical
J2: Conn_02x03_motherboardconn; ConnectorHorizontalPcb
J3: USB_B_Micro; USB_Micro
J4: Conn_01x02_battery; PinHeader_1x02_P2.54mm_Vertical
J5, J6: Conn_01x06_programmer; PinHeader_1x06_P2.54mm_Vertical
JP1, JP2: SolderJumper_2_Open; SolderJumper-2_P1.3mm_Open_RoundedPad1.0x1.5mm
L1: 22 uH; Inductor_744031220_22uH
L2: 10 uH; Inductor_744029100_10uH
R1, R6, R7, R8, R9, R10, R11: 10k; R_0805_2012Metric_Pad1.15x1.40mm_HandSolder
R2: 1k; R_0805_2012Metric_Pad1.15x1.40mm_HandSolder
R3: 2k; R_0805_2012Metric_Pad1.15x1.40mm_HandSolder
R4, R5: 1.5k; R_0805_2012Metric_Pad1.15x1.40mm_HandSolder
R12, R13: 470; R_0805_2012Metric_Pad1.15x1.40mm_HandSolder
ROK1: 1.9 M; R_0805_2012Metric_Pad1.15x1.40mm_HandSolder
ROK2: 5.49 M; R_0805_2012Metric_Pad1.15x1.40mm_HandSolder
ROK3: 5.62M; R_0805_2012Metric_Pad1.15x1.40mm_HandSolder
ROUT1: 8.25 M; R_0805_2012Metric_Pad1.15x1.40mm_HandSolder
ROUT2: 4.75 M; R_0805_2012Metric_Pad1.15x1.40mm_HandSolder
ROV1: 7.32 M; R_0805_2012Metric_Pad1.15x1.40mm_HandSolder
ROV2: 5.61 M; R_0805_2012Metric_Pad1.15x1.40mm_HandSolder
S1, S2: TPS22860; SOT-23-6_Handsoldering
U1: BQ24040
U2: BQ25570; QFN-20-1EP_3.5x3.5mm_P0.5mm_EP2x2mm
U3: TPS705; SOT-23-5_HandSoldering
U4: PIC16F18446; PIC16F18446SSOP20PIN

Connections:
3V3: C7.2, C8.2, COUT1.1, J2.6, J5.2, J6.2, JP2.1, L2.1, R11.1, U2.14, U4.1
BAT+: C4.1, C6.1, J4.1, JP1.1, R4.2, R5.2, S2.4, S2.5, U1.10, U2.18
BAT_MEAS_EN: S2.6, U4.8
BAT_VOLTAGE: R9.2, R10.1, U4.6
GND: C1.2, C2.2, C3.2, C4.2, C5.2, C6.2, C7.1, C8.1, CBYP1.2, CIN1.2, COUT1.2, CREF1.2, CSTOR1.2, J1.2, J2.2, J3.5, J4.2, J5.3, J6.3, R1.2, R2.2, R3.2, R6.2, R8.2, R10.2, R12.2, R13.2, ROK3.2, ROUT2.2, ROV2.2, S1.2, S2.2, U1.3, U1.7, U1.11, U2.1, U2.9, U2.15, U2.17, U2.21, U3.2, U4.20
HYST: ROK1.2, ROK2.1, U2.10
ICSPCLK: J5.5, J6.5, U4.18
ICSPDAT: J5.4, J6.4, U4.19
INT: J2.3, U4.9
LED0: D3.2, U4.11
LED1: D4.2, U4.15
MCLR: J5.1, J6.1, R11.2, U4.4
unnamed: C2.1, JP1.2, U3.1, U3.3
unnamed: C3.1, JP2.2, U3.5
unnamed: CREF1.1, U2.4
unnamed: D1.1, U1.5
unnamed: D1.2, R4.1
unnamed: D2.1, U1.8
unnamed: D2.2, R5.1
unnamed: D3.1, R12.1
unnamed: D4.1, R13.1
unnamed: L1.1, U2.20
unnamed: L2.2, U2.16
unnamed: R2.1, U1.2
unnamed: R3.1, U1.4
unnamed: R6.1, U1.9
unnamed: R7.1, S1.1
unnamed: R9.1, S2.1
unnamed: ROK1.1, ROUT1.1, ROV1.1, U2.8
unnamed: ROV1.2, ROV2.1, U2.7
PROG: ROK2.2, ROK3.1, U2.11
SCL: J2.5, U4.10
SDA: J2.4, U4.12
SET: ROUT1.2, ROUT2.1, U2.12
SOL+: C5.1, CIN1.1, J1.1, L1.2, S1.4, S1.5, U2.2
SOL_MEAS_EN: S1.6, U4.16
SOL_VOLTAGE: R7.2, R8.1, U4.7
VBAT_OK_TO_MCU: U2.13, U4.5
VSTOR: CBYP1.1, CSTOR1.1, U2.3, U2.6, U2.19
VUSB: C1.1, J3.1, R1.1, U1.1, U2.5
