dramco-iwast/sensors/hardware/Sound_Level/SoundModulev1/kicadproject/SoundModule.kicad_pcb

## KiCad design hardware/Sound_Level/SoundModulev1/kicadproject/SoundModule.kicad_pcb (2020-03-09)

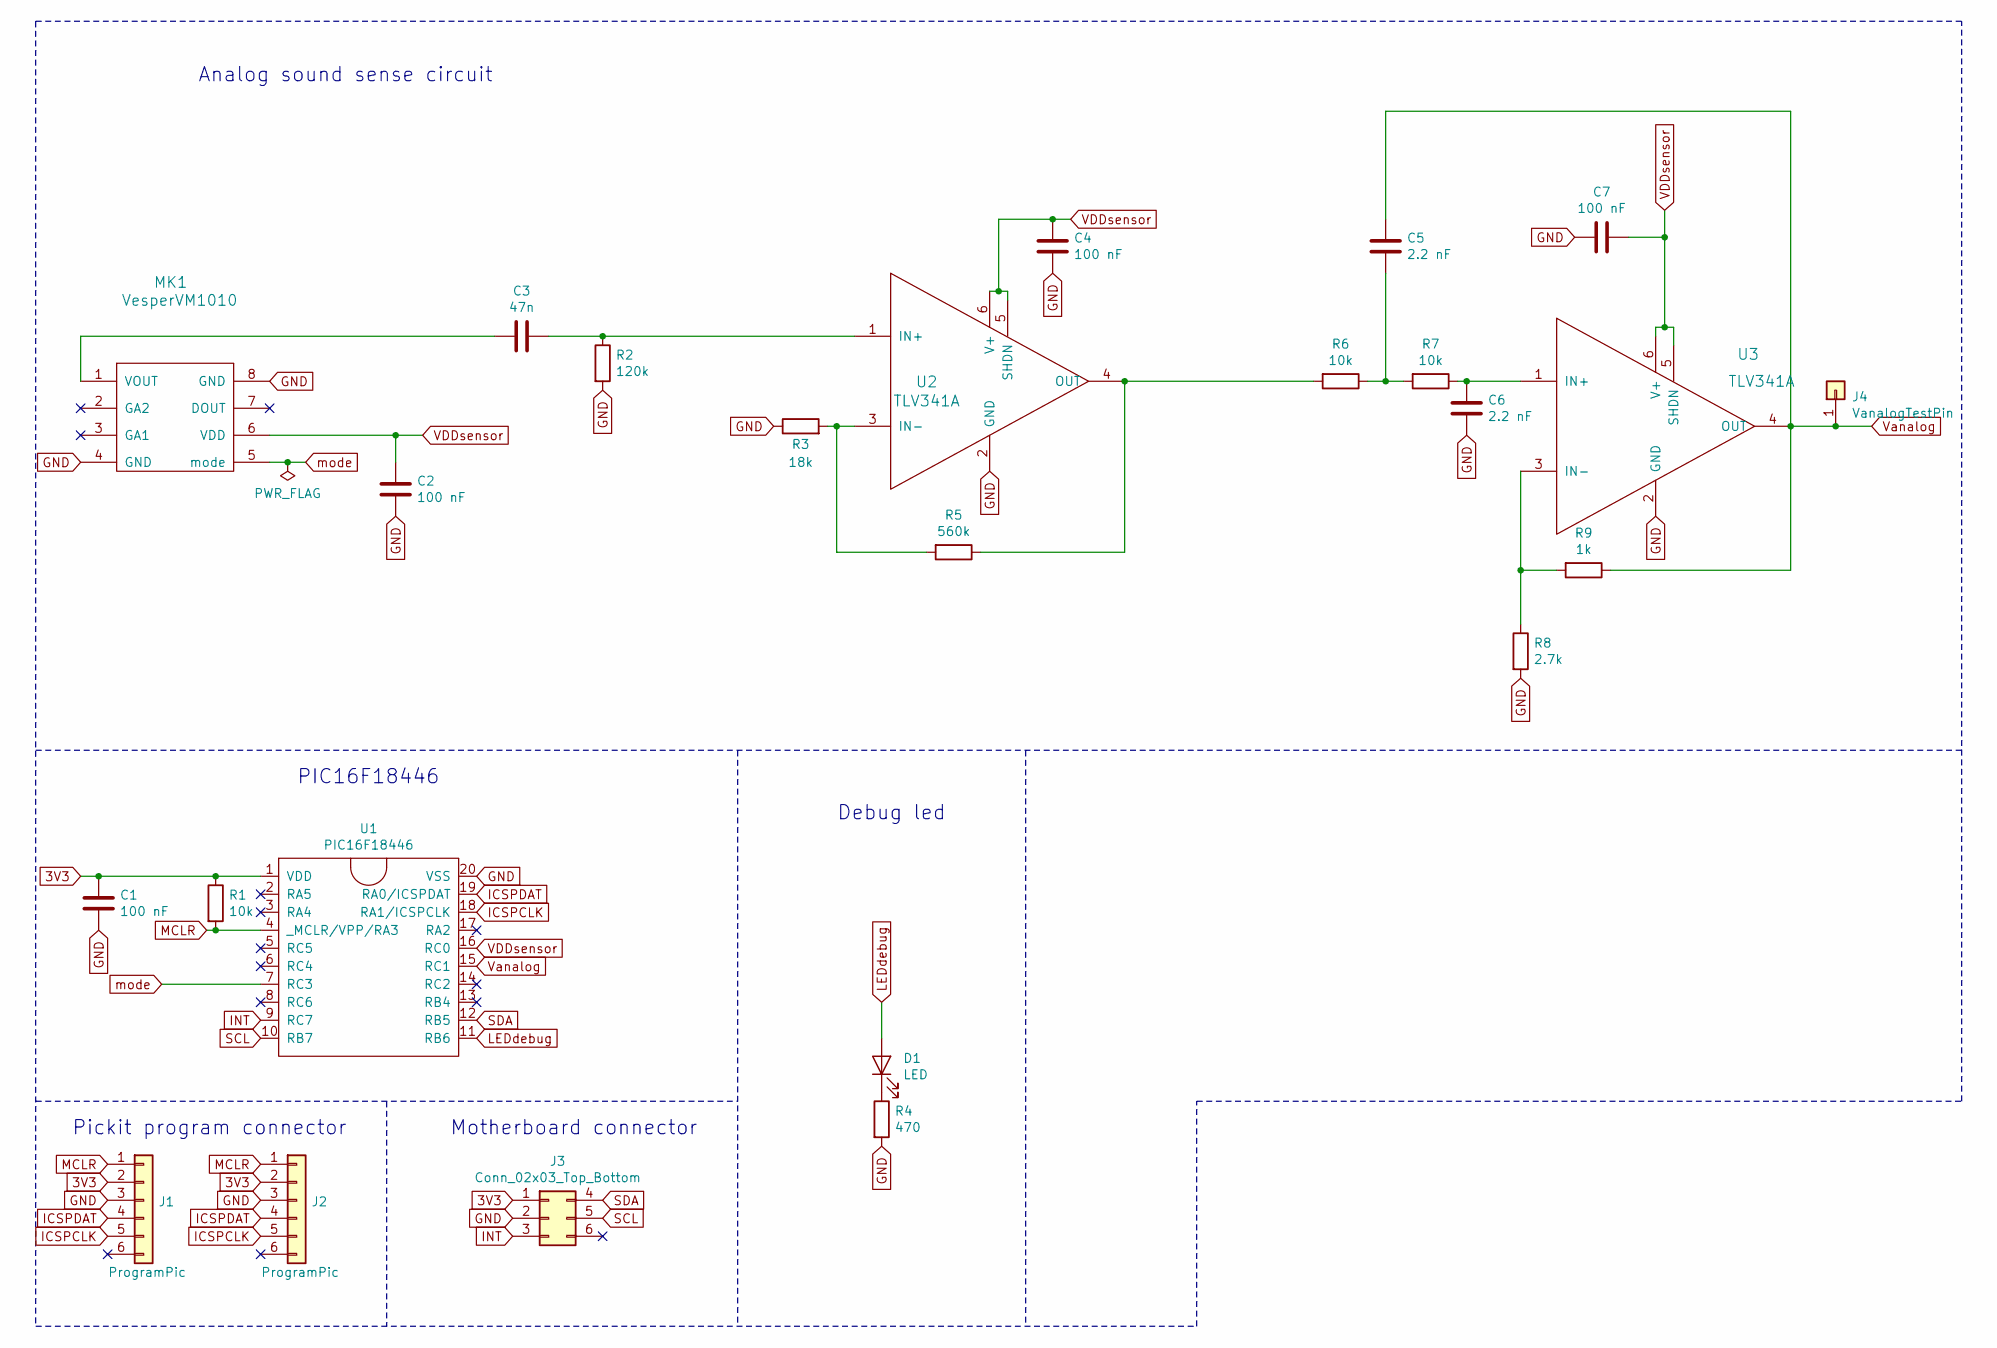
[picture p57: schematic SoundModule.sch, IOT with a soft toch: Sound sensor]

Parts:
C1, C2, C4, C7: 100 nF; C_0805_2012Metric_Pad1.15x1.40mm_HandSolder
C3: 47n; C_0805_2012Metric_Pad1.15x1.40mm_HandSolder
C5, C6: 2.2 nF; C_0805_2012Metric_Pad1.15x1.40mm_HandSolder
D1: LED; LED_0805_2012Metric_Pad1.15x1.40mm_HandSolder
J1, J2: ProgramPic; PinHeader_1x06_P2.54mm_Vertical
J3: Conn_02x03_Top_Bottom; ConnectorHorizontalPcb
J4: VanalogTestPin; PinHeader_1x01_P2.54mm_Vertical
MK1: VesperVM1010; VESPER_VM1010
R1, R6, R7: 10k; R_0805_2012Metric_Pad1.15x1.40mm_HandSolder
R2: 120k; R_0805_2012Metric_Pad1.15x1.40mm_HandSolder
R3: 18k; R_0805_2012Metric_Pad1.15x1.40mm_HandSolder
R4: 470; R_0805_2012Metric_Pad1.15x1.40mm_HandSolder
R5: 560k; R_0805_2012Metric_Pad1.15x1.40mm_HandSolder
R8: 2.7k; R_0805_2012Metric_Pad1.15x1.40mm_HandSolder
R9: 1k; R_0805_2012Metric_Pad1.15x1.40mm_HandSolder
U1: PIC16F18446; PIC16F18446SSOP20PIN
U2, U3: TLV341A; TLV341 SOT-23-6

Connections:
3V3: C1.1, J1.2, J2.2, J3.1, R1.1, U1.1 (VDD)
GND: C1.2, C2.2, C4.2, C6.2, C7.2, J1.3, J2.3, J3.2, MK1.4 (GND), MK1.8 (GND), R2.2, R3.1, R4.2, R8.2, U1.20 (VSS), U2.2 (GND), U3.2 (GND)
ICSPCLK: J1.5, J2.5, U1.18 (RA1/ICSPCLK)
ICSPDAT: J1.4, J2.4, U1.19 (RA0/ICSPDAT)
INT: J3.3, U1.9 (RC7)
LEDdebug: D1.2 (A), U1.11 (RB6)
MCLR: J1.1, J2.1, R1.2, U1.4 (_MCLR/VPP/RA3)
unnamed: C3.1, R2.1, U2.1 (IN+)
unnamed: C3.2, MK1.1 (VOUT)
unnamed: C5.2, R6.1, R7.2
unnamed: C6.1, R7.1, U3.1 (IN+)
unnamed: D1.1 (K), R4.1
unnamed: R3.2, R5.2, U2.3 (IN-~)
unnamed: R5.1, R6.2, U2.4 (OUT)
unnamed: R8.1, R9.2, U3.3 (IN-~)
SCL: J3.5, U1.10 (RB7)
SDA: J3.4, U1.12 (RB5)
VDDsensor: C2.1, C4.1, C7.1, MK1.6 (VDD), U1.16 (RC0), U2.5 (SHDN), U2.6 (V+), U3.5 (SHDN), U3.6 (V+)
Vanalog: C5.1, J4.1, R9.1, U1.15 (RC1), U3.4 (OUT)
mode: MK1.5 (mode), U1.7 (RC3)

Notes on the sheet:
Pickit program connector
Motherboard connector
PIC16F18446
Debug led
Analog sound sense circuit

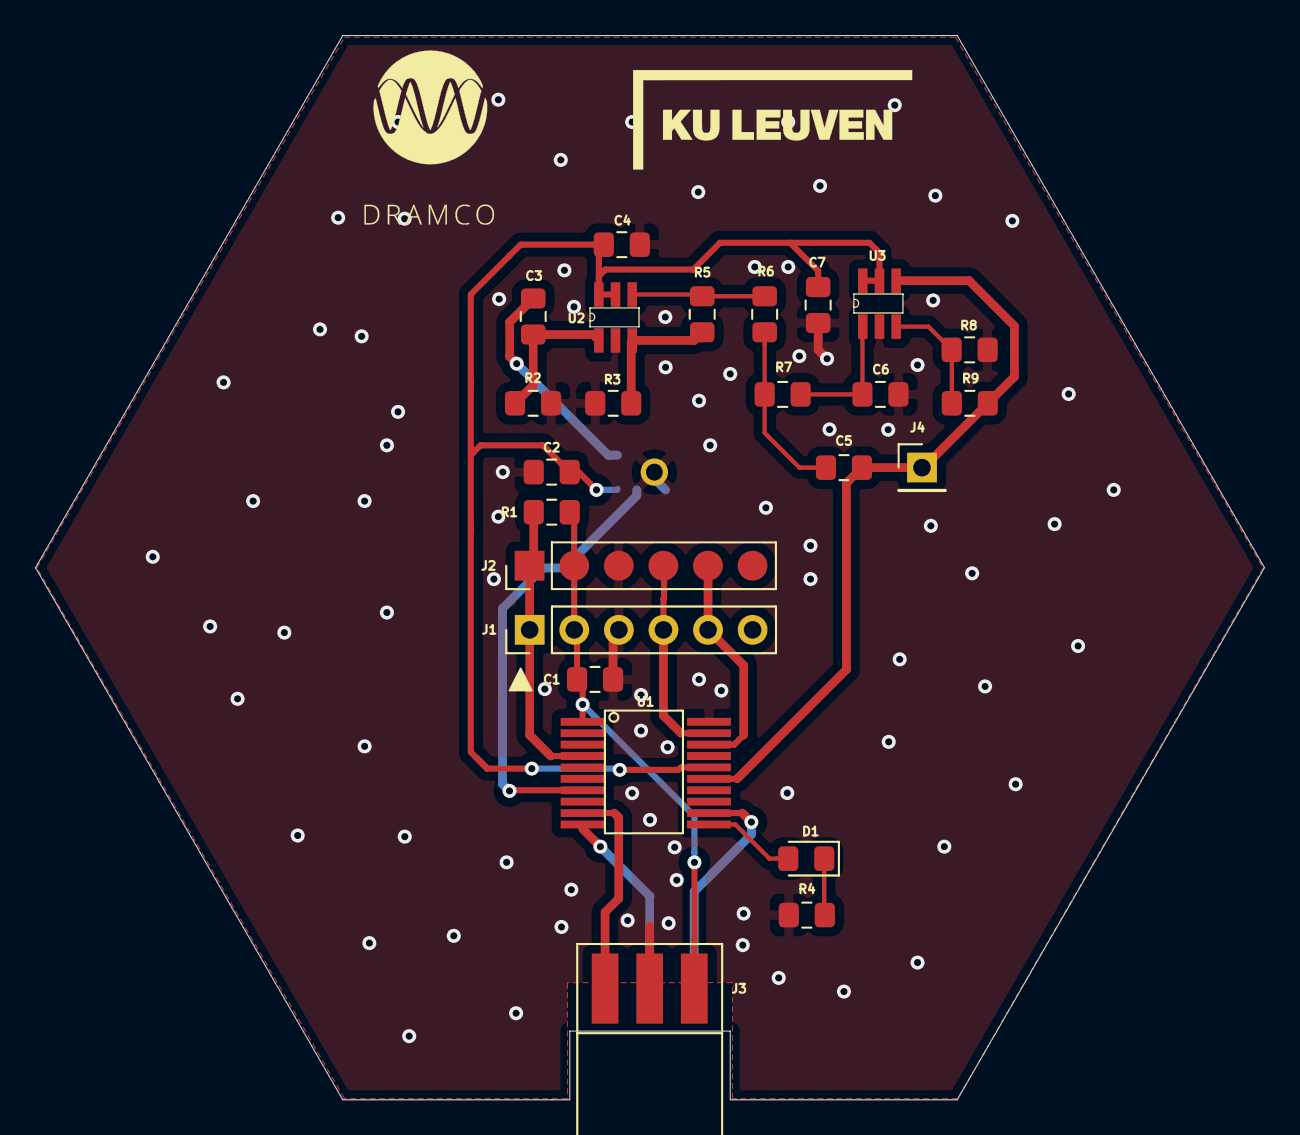
[picture p58: board SoundModule.kicad_pcb from above]

Board: 2 copper layers, 70.0 x 60.6 mm, 25 parts (1 on the bottom side), 20 nets.
