dramco-iwast/sensors/firmware/Sound_Level/system/pin_manager.h

/*  ____  ____      _    __  __  ____ ___
 * |  _ \|  _ \    / \  |  \/  |/ ___/ _ \
 * | | | | |_) |  / _ \ | |\/| | |  | | | |
 * | |_| |  _ <  / ___ \| |  | | |__| |_| |
 * |____/|_| \_\/_/   \_\_|  |_|\____\___/
 *                           research group
 *                             dramco.be/
 *
 *  KU Leuven - Technology Campus Gent,
 *  Gebroeders De Smetstraat 1,
 *  B-9000 Gent, Belgium
 *
 *         File: pin_manager.h
 *      Created: 2020-10-15
 *       Author: Mathias Alleman - Jona Cappelle
 *      Version: 0.2
 *
 *  Description: Pin manager
 *
 */

#ifndef PIN_MANAGER_H
#define PIN_MANAGER_H

/**
  Section: Included Files
*/

#include <xc.h>

#define INPUT   1
#define OUTPUT  0

#define HIGH    1
#define LOW     0

#define ANALOG      1
#define DIGITAL     0

#define PULL_UP_ENABLED      1
#define PULL_UP_DISABLED     0

// get/set SDA1 aliases
#define SDA1_TRIS                 TRISBbits.TRISB5
#define SDA1_LAT                  LATBbits.LATB5
#define SDA1_PORT                 PORTBbits.RB5
#define SDA1_WPU                  WPUBbits.WPUB5
#define SDA1_OD                   ODCONBbits.ODCB5
#define SDA1_ANS                  ANSELBbits.ANSB5
#define SDA1_SetHigh()            do { LATBbits.LATB5 = 1; } while(0)
#define SDA1_SetLow()             do { LATBbits.LATB5 = 0; } while(0)
#define SDA1_Toggle()             do { LATBbits.LATB5 = ~LATBbits.LATB5; } while(0)
#define SDA1_GetValue()           PORTBbits.RB5
#define SDA1_SetDigitalInput()    do { TRISBbits.TRISB5 = 1; } while(0)
#define SDA1_SetDigitalOutput()   do { TRISBbits.TRISB5 = 0; } while(0)
#define SDA1_SetPullup()          do { WPUBbits.WPUB5 = 1; } while(0)
#define SDA1_ResetPullup()        do { WPUBbits.WPUB5 = 0; } while(0)
#define SDA1_SetPushPull()        do { ODCONBbits.ODCB5 = 0; } while(0)
#define SDA1_SetOpenDrain()       do { ODCONBbits.ODCB5 = 1; } while(0)
#define SDA1_SetAnalogMode()      do { ANSELBbits.ANSB5 = 1; } while(0)
#define SDA1_SetDigitalMode()     do { ANSELBbits.ANSB5 = 0; } while(0)

// get/set SCL1 aliases
#define SCL1_TRIS                 TRISBbits.TRISB7
#define SCL1_LAT                  LATBbits.LATB7
#define SCL1_PORT                 PORTBbits.RB7
#define SCL1_WPU                  WPUBbits.WPUB7
#define SCL1_OD                   ODCONBbits.ODCB7
#define SCL1_ANS                  ANSELBbits.ANSB7
#define SCL1_SetHigh()            do { LATBbits.LATB7 = 1; } while(0)
#define SCL1_SetLow()             do { LATBbits.LATB7 = 0; } while(0)
#define SCL1_Toggle()             do { LATBbits.LATB7 = ~LATBbits.LATB7; } while(0)
#define SCL1_GetValue()           PORTBbits.RB7
#define SCL1_SetDigitalInput()    do { TRISBbits.TRISB7 = 1; } while(0)
#define SCL1_SetDigitalOutput()   do { TRISBbits.TRISB7 = 0; } while(0)
#define SCL1_SetPullup()          do { WPUBbits.WPUB7 = 1; } while(0)
#define SCL1_ResetPullup()        do { WPUBbits.WPUB7 = 0; } while(0)
#define SCL1_SetPushPull()        do { ODCONBbits.ODCB7 = 0; } while(0)
#define SCL1_SetOpenDrain()       do { ODCONBbits.ODCB7 = 1; } while(0)
#define SCL1_SetAnalogMode()      do { ANSELBbits.ANSB7 = 1; } while(0)
#define SCL1_SetDigitalMode()     do { ANSELBbits.ANSB7 = 0; } while(0)



/**
 * @Param
    none
 * @Returns
    none
 * @Description
    Interrupt on Change Handling routine
 * @Example
    PIN_MANAGER_IOC();
 */
void PIN_MANAGER_IOC(void);


/**
 * @Param
    none
 * @Returns
    none
 * @Description
    Interrupt on Change Handler for the IOCCF0 pin functionality
 * @Example
    IOCCF0_ISR();
 */
void IOCCF0_ISR(void);

/**
  @Summary
    Interrupt Handler Setter for IOCCF0 pin interrupt-on-change functionality

  @Description
    Allows selecting an interrupt handler for IOCCF0 at application runtime
    
  @Preconditions
    Pin Manager intializer called

  @Returns
    None.

  @Param
    InterruptHandler function pointer.

  @Example
    PIN_MANAGER_Initialize();
    IOCCF0_SetInterruptHandler(MyInterruptHandler);

*/
void IOCCF0_SetInterruptHandler(void (* InterruptHandler)(void));

/**
  @Summary
    Dynamic Interrupt Handler for IOCCF0 pin

  @Description
    This is a dynamic interrupt handler to be used together with the IOCCF0_SetInterruptHandler() method.
    This handler is called every time the IOCCF0 ISR is executed and allows any function to be registered at runtime.
    
  @Preconditions
    Pin Manager intializer called

  @Returns
    None.

  @Param
    None.

  @Example
    PIN_MANAGER_Initialize();
    IOCCF0_SetInterruptHandler(IOCCF0_InterruptHandler);

*/
extern void (*IOCCF0_InterruptHandler)(void);

/**
  @Summary
    Default Interrupt Handler for IOCCF0 pin

  @Description
    This is a predefined interrupt handler to be used together with the IOCCF0_SetInterruptHandler() method.
    This handler is called every time the IOCCF0 ISR is executed. 
    
  @Preconditions
    Pin Manager intializer called

  @Returns
    None.

  @Param
    None.

  @Example
    PIN_MANAGER_Initialize();
    IOCCF0_SetInterruptHandler(IOCCF0_DefaultInterruptHandler);

*/
void IOCCF0_DefaultInterruptHandler(void);


/**
 * @Param
    none
 * @Returns
    none
 * @Description
    Interrupt on Change Handler for the IOCCF2 pin functionality
 * @Example
    IOCCF2_ISR();
 */
void IOCCF2_ISR(void);

/**
  @Summary
    Interrupt Handler Setter for IOCCF2 pin interrupt-on-change functionality

  @Description
    Allows selecting an interrupt handler for IOCCF2 at application runtime
    
  @Preconditions
    Pin Manager intializer called

  @Returns
    None.

  @Param
    InterruptHandler function pointer.

  @Example
    PIN_MANAGER_Initialize();
    IOCCF2_SetInterruptHandler(MyInterruptHandler);

*/
void IOCCF2_SetInterruptHandler(void (* InterruptHandler)(void));

/**
  @Summary
    Dynamic Interrupt Handler for IOCCF2 pin

  @Description
    This is a dynamic interrupt handler to be used together with the IOCCF2_SetInterruptHandler() method.
    This handler is called every time the IOCCF2 ISR is executed and allows any function to be registered at runtime.
    
  @Preconditions
    Pin Manager intializer called

  @Returns
    None.

  @Param
    None.

  @Example
    PIN_MANAGER_Initialize();
    IOCCF2_SetInterruptHandler(IOCCF2_InterruptHandler);

*/
extern void (*IOCCF2_InterruptHandler)(void);

/**
  @Summary
    Default Interrupt Handler for IOCCF2 pin

  @Description
    This is a predefined interrupt handler to be used together with the IOCCF2_SetInterruptHandler() method.
    This handler is called every time the IOCCF2 ISR is executed. 
    
  @Preconditions
    Pin Manager intializer called

  @Returns
    None.

  @Param
    None.

  @Example
    PIN_MANAGER_Initialize();
    IOCCF2_SetInterruptHandler(IOCCF2_DefaultInterruptHandler);

*/
void IOCCF2_DefaultInterruptHandler(void);


/**
 * @Param
    none
 * @Returns
    none
 * @Description
    Interrupt on Change Handler for the IOCCF4 pin functionality
 * @Example
    IOCCF4_ISR();
 */
void IOCCF4_ISR(void);

/**
  @Summary
    Interrupt Handler Setter for IOCCF4 pin interrupt-on-change functionality

  @Description
    Allows selecting an interrupt handler for IOCCF4 at application runtime
    
  @Preconditions
    Pin Manager intializer called

  @Returns
    None.

  @Param
    InterruptHandler function pointer.

  @Example
    PIN_MANAGER_Initialize();
    IOCCF4_SetInterruptHandler(MyInterruptHandler);

*/
void IOCCF4_SetInterruptHandler(void (* InterruptHandler)(void));

/**
  @Summary
    Dynamic Interrupt Handler for IOCCF4 pin

  @Description
    This is a dynamic interrupt handler to be used together with the IOCCF4_SetInterruptHandler() method.
    This handler is called every time the IOCCF4 ISR is executed and allows any function to be registered at runtime.
    
  @Preconditions
    Pin Manager intializer called

  @Returns
    None.

  @Param
    None.

  @Example
    PIN_MANAGER_Initialize();
    IOCCF4_SetInterruptHandler(IOCCF4_InterruptHandler);

*/
extern void (*IOCCF4_InterruptHandler)(void);

/**
  @Summary
    Default Interrupt Handler for IOCCF4 pin

  @Description
    This is a predefined interrupt handler to be used together with the IOCCF4_SetInterruptHandler() method.
    This handler is called every time the IOCCF4 ISR is executed. 
    
  @Preconditions
    Pin Manager intializer called

  @Returns
    None.

  @Param
    None.

  @Example
    PIN_MANAGER_Initialize();
    IOCCF4_SetInterruptHandler(IOCCF4_DefaultInterruptHandler);

*/
void IOCCF4_DefaultInterruptHandler(void);


/**
 * @Param
    none
 * @Returns
    none
 * @Description
    Interrupt on Change Handler for the IOCCF6 pin functionality
 * @Example
    IOCCF6_ISR();
 */
void IOCCF6_ISR(void);

/**
  @Summary
    Interrupt Handler Setter for IOCCF6 pin interrupt-on-change functionality

  @Description
    Allows selecting an interrupt handler for IOCCF6 at application runtime
    
  @Preconditions
    Pin Manager intializer called

  @Returns
    None.

  @Param
    InterruptHandler function pointer.

  @Example
    PIN_MANAGER_Initialize();
    IOCCF6_SetInterruptHandler(MyInterruptHandler);

*/
void IOCCF6_SetInterruptHandler(void (* InterruptHandler)(void));

/**
  @Summary
    Dynamic Interrupt Handler for IOCCF6 pin

  @Description
    This is a dynamic interrupt handler to be used together with the IOCCF6_SetInterruptHandler() method.
    This handler is called every time the IOCCF6 ISR is executed and allows any function to be registered at runtime.
    
  @Preconditions
    Pin Manager intializer called

  @Returns
    None.

  @Param
    None.

  @Example
    PIN_MANAGER_Initialize();
    IOCCF6_SetInterruptHandler(IOCCF6_InterruptHandler);

*/
extern void (*IOCCF6_InterruptHandler)(void);

/**
  @Summary
    Default Interrupt Handler for IOCCF6 pin

  @Description
    This is a predefined interrupt handler to be used together with the IOCCF6_SetInterruptHandler() method.
    This handler is called every time the IOCCF6 ISR is executed. 
    
  @Preconditions
    Pin Manager intializer called

  @Returns
    None.

  @Param
    None.

  @Example
    PIN_MANAGER_Initialize();
    IOCCF6_SetInterruptHandler(IOCCF6_DefaultInterruptHandler);

*/
void IOCCF6_DefaultInterruptHandler(void);



#endif // PIN_MANAGER_H
/**
 End of File
*/
