dramco-iwast/sensors/firmware/Air_Quality_V2/Inc/debugPrint.h

/*
 * debugPrint.h
 *
 *  Created on: 9 sep. 2020
 *      Author: Sarah
 */

#ifndef DEBUGPRINT_H_
#define DEBUGPRINT_H_

#include "string.h"

//void debugPrint(UART_HandleTypeDef *huart, char _out[]);
//void debugPrintln(UART_HandleTypeDef *huart, char _out[]);

#endif /* DEBUGPRINT_H_ */
