dramco-iwast/sensors/firmware/Air_Quality_V2/Src/debugPrint.c

/*
 * debugPrint.c
 *
 *  Created on: 9 sep. 2020
 *      Author: Sarah
 */

#include "debugPrint.h"

//void debugPrint(UART_HandleTypeDef *huart, char _out[]){
// HAL_UART_Transmit(huart, (uint8_t *) _out, strlen(_out), 10);
//}
//
//void debugPrintln(UART_HandleTypeDef *huart, char _out[]){
// HAL_UART_Transmit(huart, (uint8_t *) _out, strlen(_out), 10);
// char newline[2] = "\r\n";
// HAL_UART_Transmit(huart, (uint8_t *) newline, 2, 10);
//}
