dramco-iwast/sensors/(commit log)

2019-09-11 Firmware first commit
    Working version of a "dummy" sensor device.
2019-10-30 Update of sensor operation and I2C commands
2019-11-04 Add button software
2019-11-07 Working sound level sensors
    Low-power operation with threshold-based interrupt
2019-11-12 Working sensor boards (buttons and sound level)
2019-11-13 Changed buttons behavior
2019-11-14 Buttons update
    Button presses are ignored while led animation is running.
2019-11-18 added schematics
2019-12-10 Modified hardware design of sound_level sensor board
2020-01-30 sensors firmware reorganization
2020-03-09 Add kicad project files sound_level sensor
    [SoundModule.csv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]
2020-03-09 BME and STEM kicadproject added
    [BME680.csv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]
2020-07-07 Add power module hardware and firmware
    [PowerModule-B_SilkS.dxf, PowerModule-F_SilkS.dxf, PowerModule.csv, PowerModule.kicad_pcb, PowerModule.sch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]
2020-10-02 Firmware for buttons
    First project in accordance to new separate project system. Buttons can serve as a guideline for Sound_level and powermodule
2020-10-07 Fixed 'high' current draw in sleep
    Now only 300 nA in sleep.
    [global.h, main.c, system.c]
2020-10-08 Update buttons.c
    slightly modified fade
2020-10-09 Changed sensor API naming
2020-10-13 Low Power Optimisation Sound Sensor
    - approx. 1.37µA in SLEEP
    - approx. 260µA MIC ON
2020-10-20 Sound Sensor Interrupt based v2
    Still some bugs, only interrupt working, polled measurement not working
    [main.c, sound_level.c, sound_level.h]
2020-10-21 Sound Sensor v2 - interrupt + polling no watchdog
2020-10-26 Sound Sensor v2 - interrupt + polling + watchdog
2020-10-28 Sound Module Hardware v2.1
    [STEM-B_Cu.gbl, STEM-B_Mask.gbs, STEM-B_SilkS.gbo, STEM-Edge_Cuts.gm1, STEM-F_Cu.gtl, STEM-F_Mask.gts, STEM-F_SilkS.gto, STEM.drl]
2020-10-28 Updated dB calculation + cleanup ADC interrupt service routine (Sound Module v2.1)
2020-10-29 Update to i2c interface (sound module)
    Problem with I2C crashing, possibly the motherboard who doesn't give a fast enough ACK
    [SoundModulev2.kicad_pcb, SoundModulev2BOM.csv]
2020-10-29 Cleanup repo
    [BME680.csv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]
2020-11-06 Sound sensor: threshold by digital switch R network
2020-11-06 added current measurements (indication)
2020-11-12 Current measurements: with & without motherboard
2020-11-13 Added earlier version of HW power module
    [Power_module_v0-B_Cu.gbl, Power_module_v0-B_Mask.gbs, Power_module_v0-B_Paste.gbp, Power_module_v0-B_SilkS.gbo, Power_module_v0-Edge_Cuts.gm1, Power_module_v0-F_Cu.gtl, Power_module_v0-F_Mask.gts, Power_module_v0-F_Paste.gtp]
2020-11-16 Update file structure power module
2020-11-17 Power Module: Fixed connection to motherboard
    [global.h, i2c1.c, i2c1.h, power.c]
2020-11-17 Power: battery voltage measurement working to TTN console
2020-11-17 Power: fixed solar voltage resistor divider
    [power.c]
2020-11-18 Power: renaming in schematic
    [Power_module_v0.sch]
2020-11-18 Power: current reduction to +-1.5µA
2020-11-20 Power: Cleanup code
2020-11-20 Power merge with interrupt based code
    Needs to be tested
2020-11-20 Power: Cleanup
2020-11-20 Power: HW notes
    [Power_module_v0.kicad_pcb, Power_module_v0.sch]
2020-11-20 Power: HW buck layout
    [Power_module_v0.sch, Power_module_v1.kicad_pcb, Power_module_v1.sch]
2020-11-23 Power module HW redesign v2.0
    [Power_module_v1-B_Cu.gbl, Power_module_v1-B_Mask.gbs, Power_module_v1-B_Paste.gbp, Power_module_v1-B_SilkS.gbo, Power_module_v1-Edge_Cuts.gm1, Power_module_v1-F_Cu.gtl, Power_module_v1-F_Mask.gts, Power_module_v1-F_Paste.gtp]
2020-11-24 Power HW: gerber + add vias
    [Power_module_v1-B_Cu.gbl, Power_module_v1-B_Mask.gbs, Power_module_v1-B_Paste.gbp, Power_module_v1-B_SilkS.gbo, Power_module_v1-Edge_Cuts.gm1, Power_module_v1-F_Cu.gtl, Power_module_v1-F_Mask.gts, Power_module_v1-F_Paste.gtp]
2020-11-25 Power hw: logo
    [Power_module_v1-B_Cu.gbl, Power_module_v1-B_Mask.gbs, Power_module_v1-B_Paste.gbp, Power_module_v1-B_SilkS.gbo, Power_module_v1-Edge_Cuts.gm1, Power_module_v1-F_Cu.gtl, Power_module_v1-F_Mask.gts, Power_module_v1-F_Paste.gtp]
2020-11-26 Pierre test (#4)
    * Modification_1
    - The polling works
    - ADC returns 0
    - Need to implement the WDT
    * Modification_2
    - The Threhold and the configuration of the WDT are ok
    - ADC doesn't still working...
    - Polling alone is ok
    * Modification_3
    - Improvement of the WDT enabling/disabling
    * ADC fixing
    - Need to enable the peripheral
    * Modif WDT Period
    * Minor Modification
    [global.h, power.c]
2020-11-26 Revert "Pierre test (#4)"
    This reverts commit b3f6c8bbd5bab70516751f97c902ce99610df233.
    [global.h, power.c]
2020-11-26 Power: Update BOM + code loop + thresholds
    PROBLEM: Motherboard reset after 5 min / 3 polled measurements
    [Power_module_v2_BOM.csv]
2020-11-27 Power: Small stability update
    [Power_module_v0.kicad_pcb, Power_module_v2_BOM.csv]
2020-11-27 Cleanup power code
2020-11-27 Power: Power consumption
2020-11-30 Power HW: fixed LDR voltage divider
    [Power_module_v1-B_Cu.gbl, Power_module_v1-B_Mask.gbs, Power_module_v1-B_Paste.gbp, Power_module_v1-B_SilkS.gbo, Power_module_v1-Edge_Cuts.gm1, Power_module_v1-F_Cu.gtl, Power_module_v1-F_Mask.gts, Power_module_v1-F_Paste.gtp]
2020-12-04 Sound level: cleanup + shorter blink
    Blink time shortened to 20ms to conserver battery power
    [main.c, sound_level.c]
2020-12-07 Power: LDR Resistance readout
2020-12-07 Power: added lux conversion based on fitting with "pro" lux meter
2020-12-11 Power: added low + high threshold levels for battery + ldr
2020-12-16 Power HW v3.0
    [Power_module_v1-B_Cu.gbl, Power_module_v1-B_Mask.gbs, Power_module_v1-B_Paste.gbp, Power_module_v1-B_SilkS.gbo, Power_module_v1-Edge_Cuts.gm1, Power_module_v1-F_Cu.gtl, Power_module_v1-F_Mask.gts, Power_module_v1-F_Paste.gtp]
2021-01-05 Power: conversion config + maybe change in hw
    [Power_module_v1-B_Cu.gbl, Power_module_v1-B_Mask.gbs, Power_module_v1-B_Paste.gbp, Power_module_v1-B_SilkS.gbo, Power_module_v1-Edge_Cuts.gm1, Power_module_v1-F_Cu.gtl, Power_module_v1-F_Mask.gts, Power_module_v1-F_Paste.gtp]
2021-01-15 Power HW v4.0
    [Power_module_v1-B_Cu.gbl, Power_module_v1-B_Mask.gbs, Power_module_v1-B_Paste.gbp, Power_module_v1-B_SilkS.gbo, Power_module_v1-Edge_Cuts.gm1, Power_module_v1-F_Cu.gtl, Power_module_v1-F_Mask.gts, Power_module_v1-F_Paste.gtp]
2021-01-15 Power: set WDT to 64sec period
2021-01-19 Sound module: FVR + longer stabilizing time
    FVR for more accurate measurements + longer stabilisation time to charge RC circuits -> higher accuracy across multiple sensors
2021-01-19 Sound: change resistor value
    [SoundModulev2.sch]
2021-02-04 Update hardware schematics
    [Power_module_v1.kicad_pcb, Power_module_v1.sch]
2021-02-04 Power: Make I2C non blocking + change data length
2021-02-11 Sound: Reset thresholds on CMD_POLL (motherboard resets)
    [main.c]
2021-05-18 Update hardware files
    [Power_module_v0-B_Cu.gbl, Power_module_v0-B_Mask.gbs, Power_module_v0-B_Paste.gbp, Power_module_v0-B_SilkS.gbo, Power_module_v0-Edge_Cuts.gm1, Power_module_v0-F_Cu.gtl, Power_module_v0-F_Mask.gts, Power_module_v0-F_Paste.gtp]
2021-05-18 Update buttons
2021-05-18 Added BOM
    [BME680.xlsx, Buttons.xlsx, Power_module_v4.xlsx, SoundModulev2_2.xlsx]
2021-05-21 Update HW air quality v2 + update BOMs
    [BME680.csv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]
2021-05-21 Update boms
    [Buttons.xlsx, Power_module_v4.xlsx, SoundModulev2_2.xlsx, air_quality_bom.xlsx]
2021-05-31 Hardware update Power Module
    [Power_module_v1-B_Cu.gbl, Power_module_v1-B_Mask.gbs, Power_module_v1-B_Paste.gbp, Power_module_v1-B_SilkS.gbo, Power_module_v1-Edge_Cuts.gm1, Power_module_v1-F_Cu.gtl, Power_module_v1-F_Mask.gts, Power_module_v1-F_Paste.gtp]
2021-06-30 Code update Light sensor VEML7700 v0.1
2021-07-01 Power Module code cleanup
2021-07-02 Power module: add thresholds (to be tested!)
2021-07-02 Power module: Thresholds (updated each 16sec)
2021-07-05 Power: WDT when threshold exceeded - wait for 64sec
2021-07-05 Power: Added current measurements
2021-07-08 Power: added some delay
    Motherboard could not react in time without the delay - the interrupt doesn't get registered correctly
    [power.c]
2021-07-28 Update Sensor Module
    [Buttons_v1.xlsx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]
2021-08-11 Power: separated light & batt measurements + added filtering to batt measurements
2021-08-18 Power: current consumption reduced even more :ok_hand: + measurements
2021-08-19 Power: split v1 - v2 code
2021-08-23 Power: v1 code working
2021-08-23 Power V2 stability update
    [adcc.c, battery.c, filter.h, power.c]
2021-08-27 Update Footprint Button
    [STEM-B_Cu.gbl, STEM-B_Mask.gbs, STEM-B_SilkS.gbo, STEM-Edge_Cuts.gm1, STEM-F_Cu.gtl, STEM-F_Mask.gts, STEM-F_SilkS.gto, STEM-NPTH.drl]
2021-09-02 Buttons gerber update with logos
    [STEM.kicad_pcb]
2021-10-26 update HW sound module
    [Power_module_v4.xlsx, SoundModulev11.csv, SoundModulev12.csv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]
2021-10-26 Power module HW update: 1 sided
    [610106249121.step, PIC_3d.STEP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]
2021-10-27 Power module: HW update new pinheaders + new case
    [Power_module_v1-B_Cu.gbl, Power_module_v1-B_Mask.gbs, Power_module_v1-B_Paste.gbp, Power_module_v1-B_SilkS.gbo, Power_module_v1-Edge_Cuts.gm1, Power_module_v1-F_Cu.gtl, Power_module_v1-F_Mask.gts, Power_module_v1-F_Paste.gtp]
2021-11-15 HW: Sound level update
    [610106249121.step, SoundModulev11.csv, SoundModulev12.csv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]
2021-11-15 sound level add mounting holes
    [SoundModulev2-B_Cu.gbl, SoundModulev2-B_Mask.gbs, SoundModulev2-B_Paste.gbp, SoundModulev2-B_SilkS.gbo, SoundModulev2-Edge_Cuts.gm1, SoundModulev2-F_Cu.gtl, SoundModulev2-F_Mask.gts, SoundModulev2-F_Paste.gtp]
2021-11-15 Buttons + power HW update to support new casing
    [610106249121.step, Buttons_v1.xlsx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]
2022-10-10 Update air quality sensor
    [BME680.csv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]
